aditya-167/SuperPong-FPGA/sw/videodemo/src/assets/test.jpg

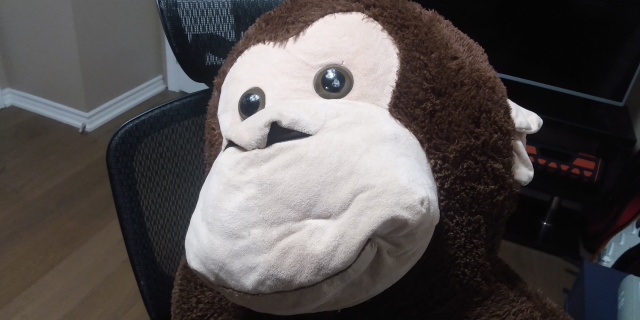
sw/videodemo/src/assets/test.jpg
