aditya-167/SuperPong-FPGA/docs/README.md

# Demo Video
[Full Demo](https://github.com/aditya-167/SuperPong-FPGA/blob/main/assets/full_demo.mp4)

# Camera Demo
[Camera Demo](https://github.com/aditya-167/SuperPong-FPGA/blob/main/assets/camera_interface.mp4)

# Pong Game Demo
[Full Demo](https://github.com/aditya-167/SuperPong-FPGA/blob/main/assets/pong_demo.mp4)

# Image Processing Demo
[Full Demo](https://github.com/aditya-167/SuperPong-FPGA/blob/main/assets/img_processing_unit.mp4)
