aditya-167/SuperPong-FPGA/hw/HDMI.runs/impl_1/.init_design.begin.rst

<?xml version="1.0"?>
<ProcessHandle Version="1" Minor="0">
    <Process Command=".planAhead." Owner="Yash Dhillon" Host="SOL-WYPC2" Pid="14732">
    </Process>
</ProcessHandle>
