aditya-167/SuperPong-FPGA/hw/HDMI.runs/hdmi_auto_rs_w_2_synth_1/.vivado.begin.rst

<?xml version="1.0"?>
<ProcessHandle Version="1" Minor="0">
    <Process Command="vivado.bat" Owner="Angad" Host="DESKTOP-RMQ09J8" Pid="7096">
    </Process>
</ProcessHandle>
