aditya-167/SuperPong-FPGA/hw/HDMI.runs/hdmi_axi_dynclk_0_0_synth_1/.vivado.begin.rst

<?xml version="1.0"?>
<ProcessHandle Version="1" Minor="0">
    <Process Command="vivado.bat" Owner="Yash Dhillon" Host="SOL-WYPC2" Pid="27572">
    </Process>
</ProcessHandle>
