aditya-167/SuperPong-FPGA/docs/ECE532 Mid-Project Demo.pptx

## Super Pong

Haoran S. Wei
Harsimrat S. Wadhawan
Yash Dhillon
Aditya Srichandan

## Overview

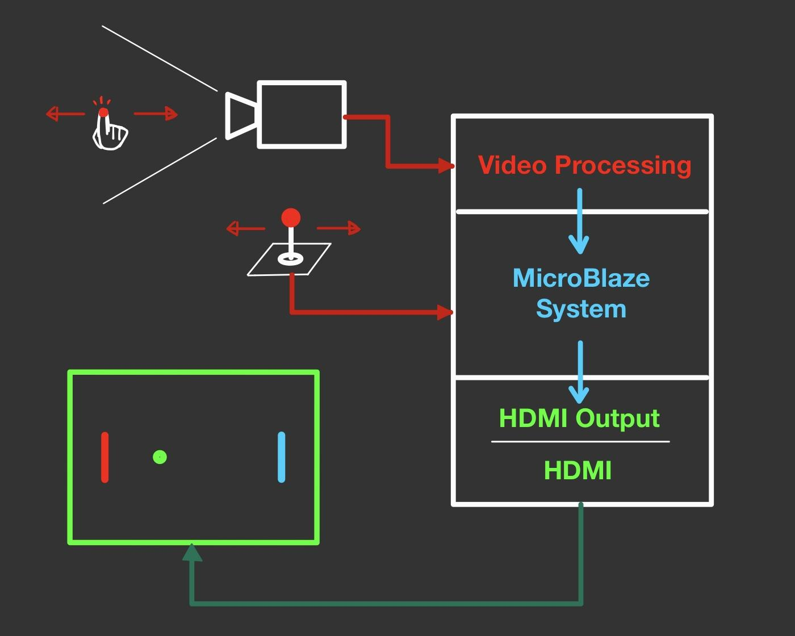
[picture p3: figure]

## Overview

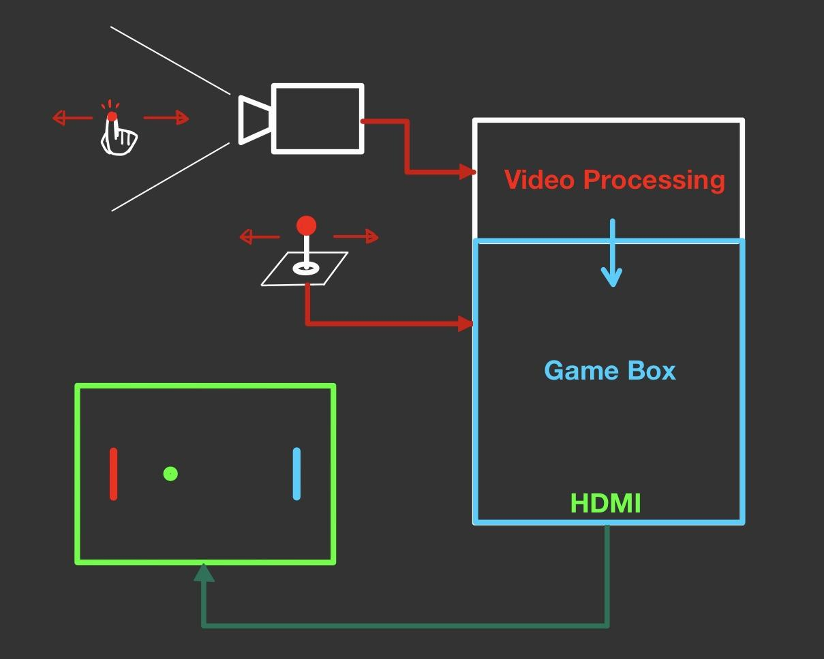
[picture p4: figure]

## Block Diagram

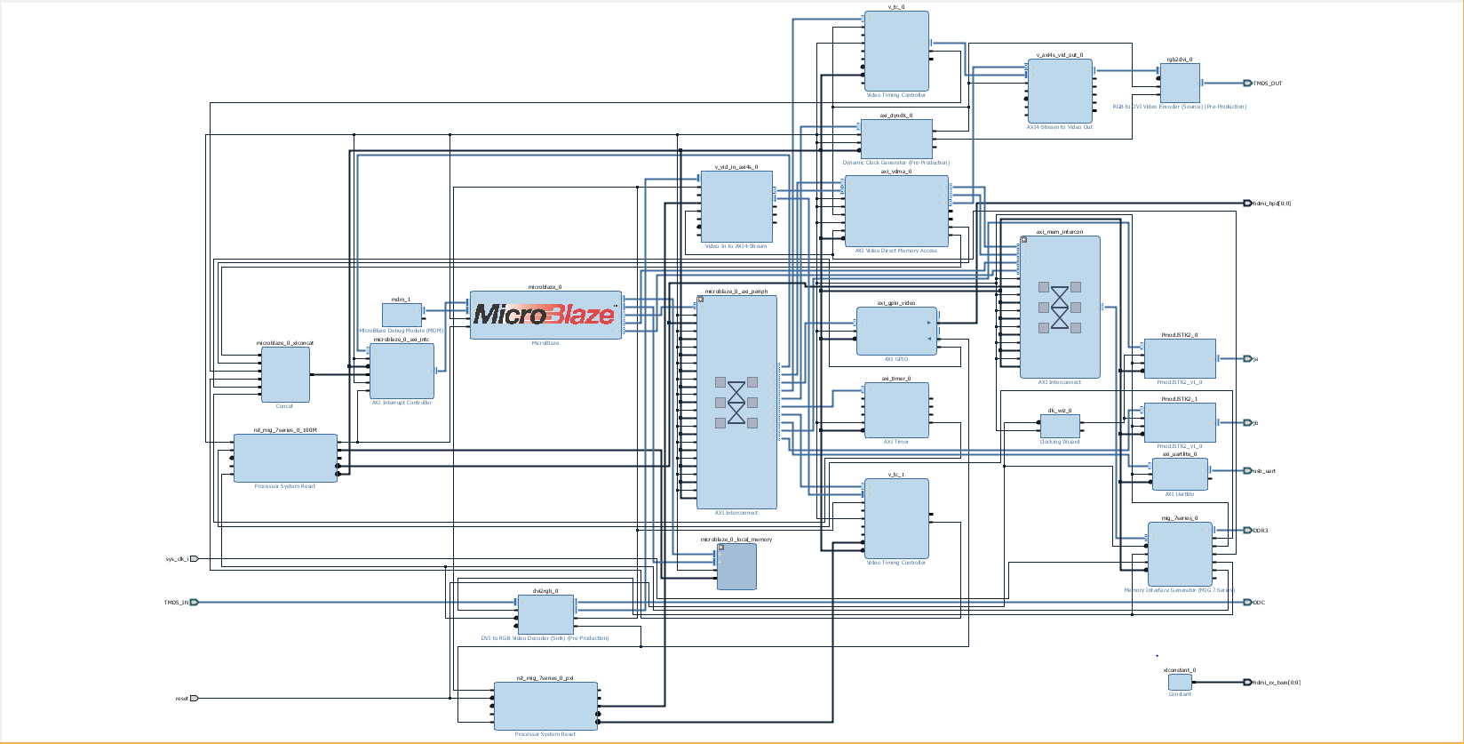
[picture p5: figure]

## Video Data Flow

VIDEO DMA

AXI STREAM TO VIDEO OUT

RGB to DVI Encoder

TMDS141 CHIP

HDMI
PORT

MEMORY INTERFACE

TIMING CONTROLLER

## MicroBlaze + HDMI Output

DRAM BUFFER

Microblaze

WRITE

READ

Video DMA

## MicroBlaze + HDMI Output

void drawPixel(int x, int y, int r, int g, int b) {
int iPixelAddr = x + (stride * y);
frame[iPixelAddr] = r;
frame[iPixelAddr + 1] = g;
frame[iPixelAddr + 2] = b;
}
// frame is a pointer to the DRAM buffer.
// iPixelAddr is the address of a single pixel in the buffer.

## Block Diagram : Joysticks

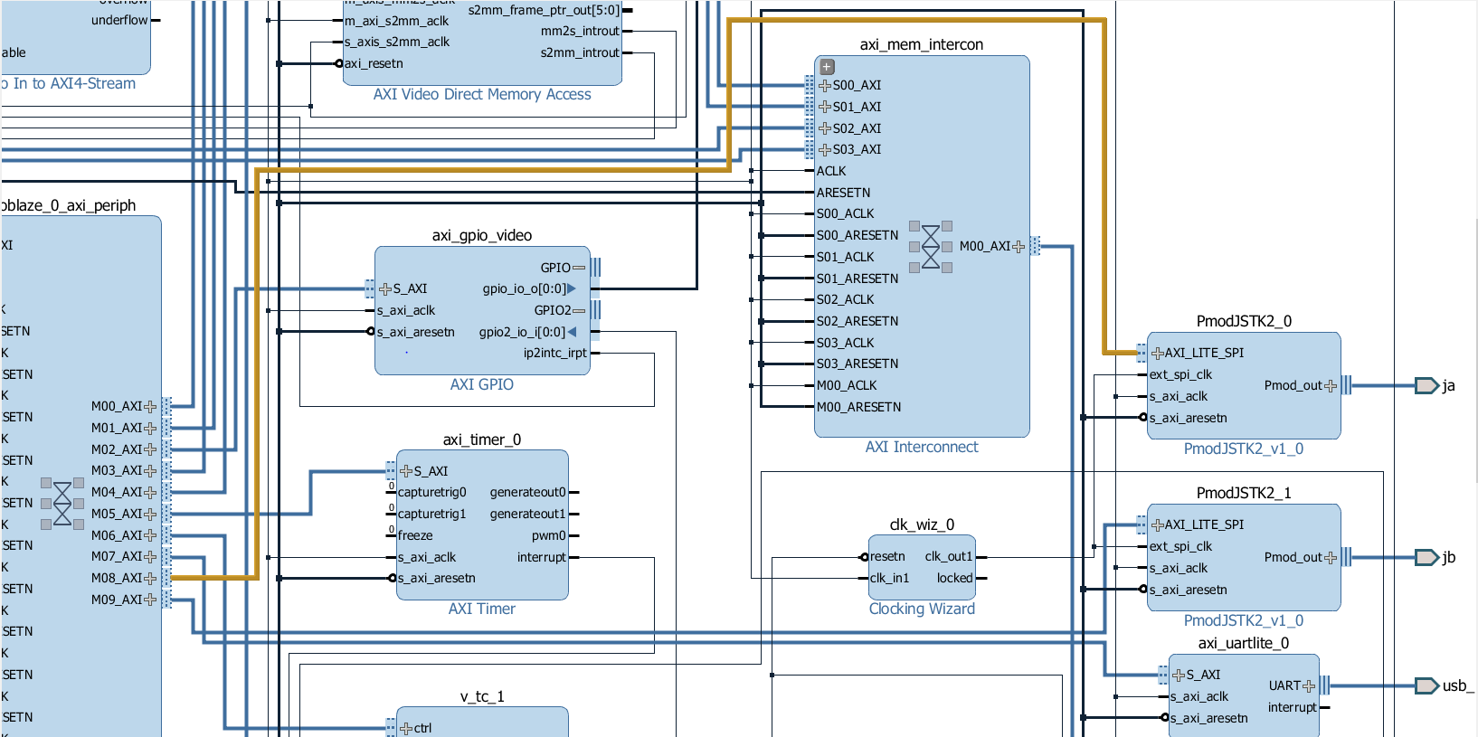
[picture p6: figure]

## Joysticks: Interface with Microblaze

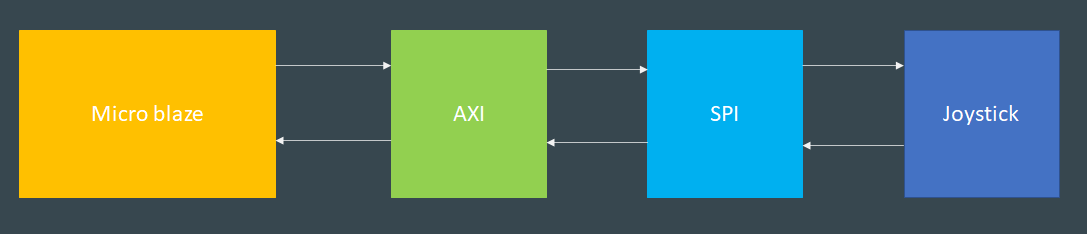
[picture p7: figure]

## Joysticks: Code Interface

void update_player_pad(PmodJSTK2* player, player_pad* pad, ball_struct* ball, int t_elapse) {
u16 Ydata;
u16 Xdata;
float step;
pad->pX = pad->xPos;
pad->pY = pad->yPos;
Ydata = JSTK2_getY(player);
Xdata = JSTK2_getX(player);
step = JOY_STEP * (((float)(Ydata-128))/128);
pad->yPos -= step;
if (pad->yPos < pad->h / 2)
pad->yPos = pad->h / 2;
if (pad->yPos > SCREEN_HEIGHT - pad->h / 2)
pad->yPos = SCREEN_HEIGHT - pad->h / 2;
}

## VGA Camera Interface

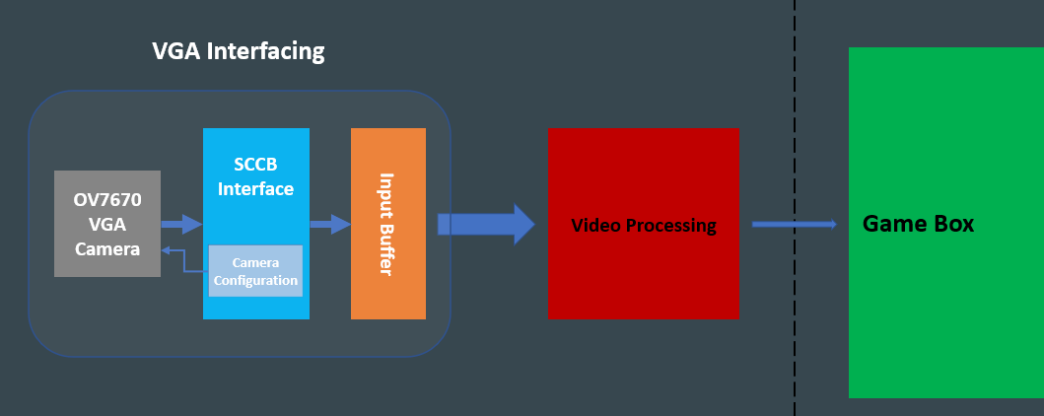
[picture p8: figure]

## VGA Camera Verification

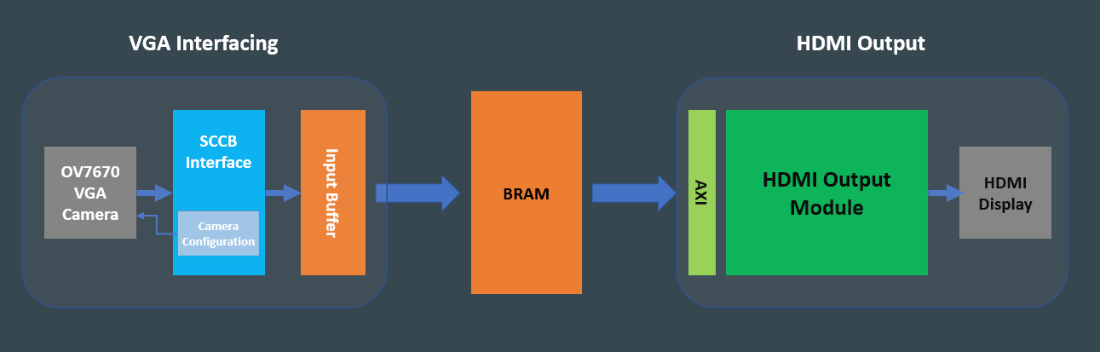
[picture p9: figure]

## Image Processing Unit (IPU)

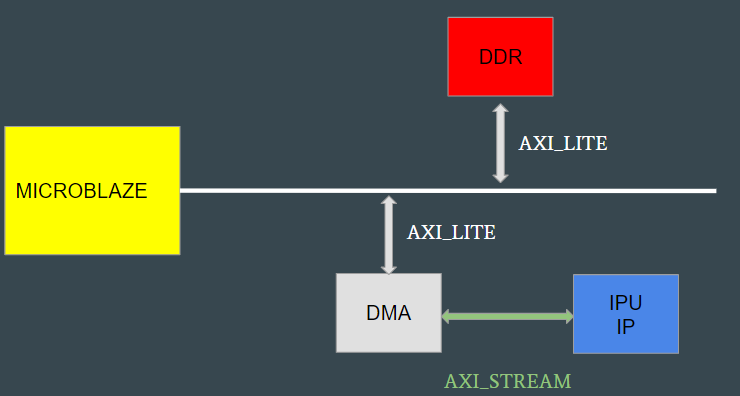
[picture p10: figure]

System Architecture

- 24 bits RGB2HSV Module
- Masking HSV logic

IPU Logic

## IPU BLOCK DESIGN

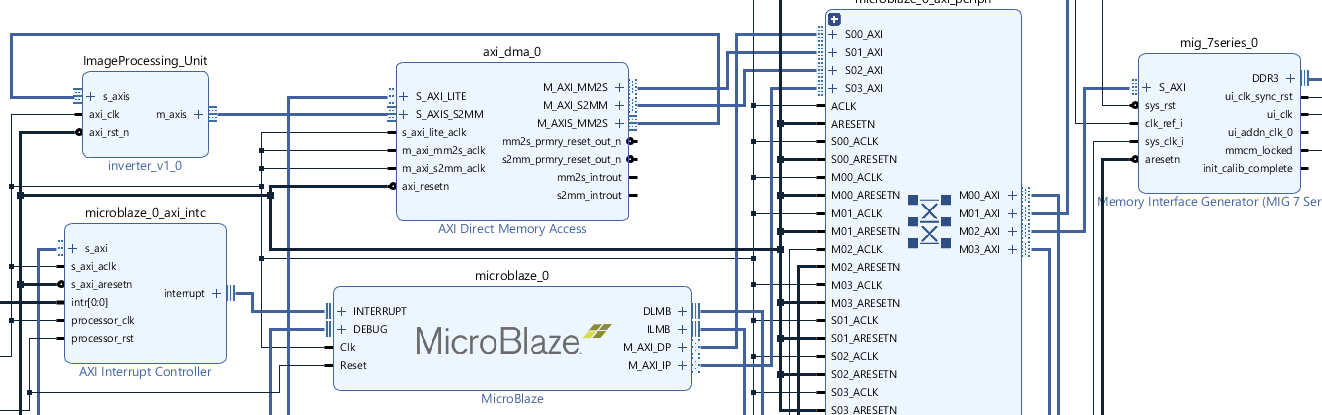
[picture p11: figure]

## TEST IMAGE

BMP image
(Two fingers covered with blue & yellow cover)

UART

Microblaze

RGB2HSV & mask values

Save back to bmp file & visualize

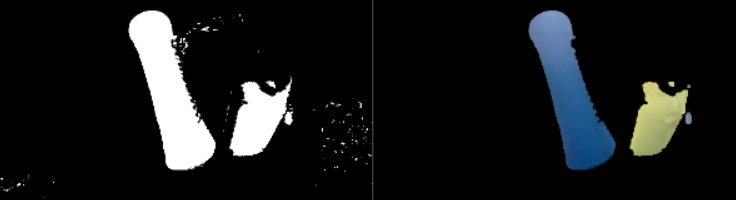
[picture p12: figure]

HW IPU under development, tested functionality on SW

## Demonstration

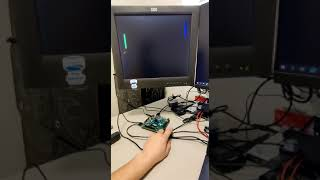
[picture p13: figure]

## Thanks !

Q & A
