aditya-167/SuperPong-FPGA/assets/generalproj.bmp

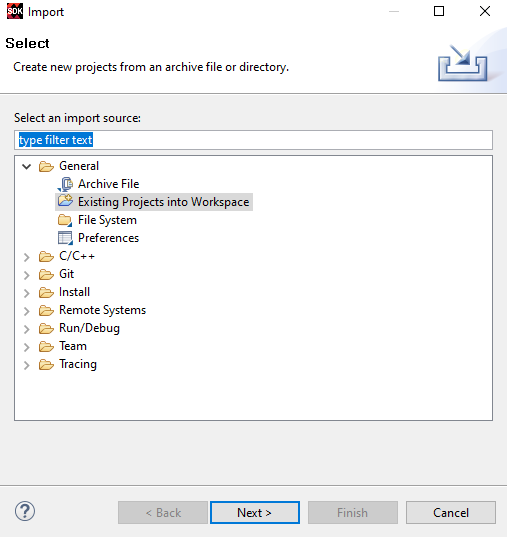
assets/generalproj.bmp
