aditya-167/SuperPong-FPGA/assets/prog.bmp

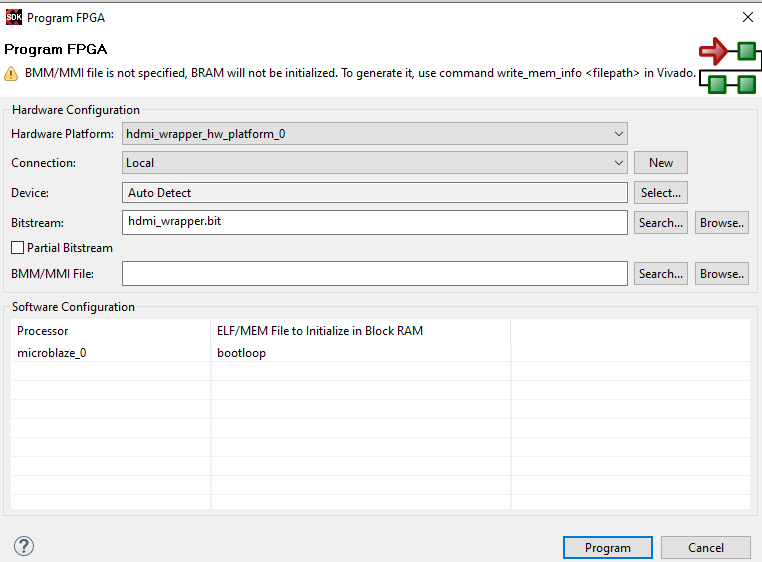
assets/prog.bmp
