aditya-167/SuperPong-FPGA/assets/root0dir.bmp

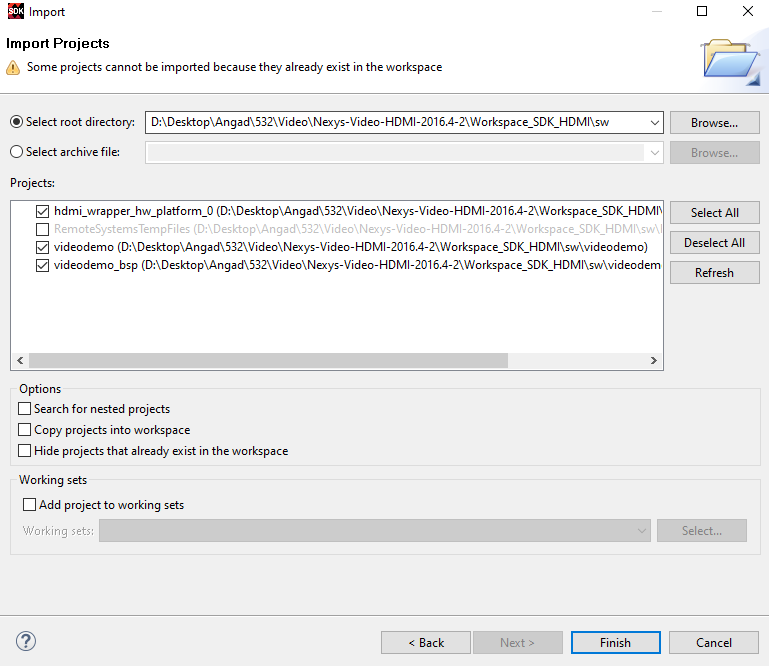
assets/root0dir.bmp
