aditya-167/SuperPong-FPGA/hw/HDMI.runs/impl_1/usage_statistics_webtalk.html

### Device Usage Page (usage_statistics_webtalk.html)

This HTML page displays the device usage statistics that will be sent to Xilinx.
To see the actual file transmitted to Xilinx, please click here.

software_version_and_target_device
beta | FALSE | build_version | 1756540
date_generated | Sun Mar 05 17:50:35 2023 | os_platform | WIN64
product_version | Vivado v2016.4 (64-bit) | project_id | 1ed84a7dc2a040de8295c28d0cfe79b6
project_iteration | 4 | random_id | 4f49d80dda655659bcc6e15ab8275343
registration_id | 4f49d80dda655659bcc6e15ab8275343 | route_design | TRUE
target_device | xc7a200t | target_family | artix7
target_package | sbg484 | target_speed | -1
tool_flow | Vivado

user_environment
cpu_name | Intel(R) Core(TM) i5-6300U CPU @ 2.40GHz | cpu_speed | 2496 MHz
os_name | Microsoft Windows 8 or later , 64-bit | os_release | major release (build 9200)
system_ram | 16.000 GB | total_processors | 1

vivado_usage

java_command_handlers
autoconnectport=3 | autoconnecttarget=1 | createtophdl=9 | customizersbblock=18
disconnectrsbpin=1 | editdelete=10 | editproperties=1 | editundo=5
launchprogramfpga=1 | newexporthardware=4 | newhardwaredashboard=1 | newlaunchhardware=13
openblockdesign=10 | openexample=1 | openhardwaremanager=2 | openproject=3
projectsettingscmdhandler=3 | regeneratersblayout=5 | runbitgen=11 | runimplementation=1
runsynthesis=2 | saversbdesign=4 | showproductguide=1 | showproductwebpage=1
showview=4 | toggleautofitselection=2 | validatersbdesign=1 | viewtaskprojectmanager=1

zoomin=2

other_data

guimode=12

project_data
constraintsetcount=1 | core_container=false | currentimplrun=impl_1 | currentsynthesisrun=synth_1
default_library=xil_defaultlib | designmode=RTL | export_simulation_activehdl=0 | export_simulation_ies=0
export_simulation_modelsim=0 | export_simulation_questa=0 | export_simulation_riviera=0 | export_simulation_vcs=0
export_simulation_xsim=0 | implstrategy=Vivado Implementation Defaults | launch_simulation_activehdl=0 | launch_simulation_ies=0
launch_simulation_modelsim=0 | launch_simulation_questa=0 | launch_simulation_riviera=0 | launch_simulation_vcs=0
launch_simulation_xsim=0 | simulator_language=Mixed | srcsetcount=3 | synthesisstrategy=Vivado Synthesis Defaults
target_language=VHDL | target_simulator=XSim | totalimplruns=7 | totalsynthesisruns=7

unisim_transformation

post_unisim_transformation
and2b1l=3 | bscane2=1 | bufg=11 | bufh=1
bufio=2 | bufmr=1 | bufr=2 | carry4=761
dsp48e1=9 | fdce=816 | fdpe=325 | fdre=30860
fdse=1087 | fifo36e1=10 | gnd=1306 | ibuf=21
ibuf_intermdisable=16 | ibufds=4 | ibufds_intermdisable_int=4 | iddr=2
idelayctrl=2 | idelaye2=19 | in_fifo=2 | inv=3
iserdese2=22 | lut1=1573 | lut2=3108 | lut3=7629
lut4=3981 | lut5=5327 | lut6=7744 | mmcme2_adv=4
muxf7=803 | muxf8=39 | obuf=27 | obufds=6
obuft=36 | obuftds=4 | oddr=5 | oserdese2=51
out_fifo=4 | phaser_in_phy=2 | phaser_out_phy=4 | phaser_ref=1
phy_control=1 | plle2_adv=1 | ramb18e1=4 | ramb36e1=280
ramd32=1126 | rams32=866 | srl16e=1067 | srlc16e=7
srlc32e=209 | vcc=906 | xadc=1

pre_unisim_transformation
and2b1l=3 | bscane2=1 | bufg=11 | bufh=1
bufio=2 | bufmr=1 | bufr=2 | carry4=761
dsp48e1=9 | fdce=816 | fdpe=325 | fdre=30860
fdse=1087 | fifo36e1=10 | gnd=1306 | ibuf=4
ibufds=4 | iddr=2 | idelayctrl=2 | idelaye2=19
in_fifo=2 | iobuf=18 | iobuf_intermdisable=16 | iobufds_diff_out_intermdisable=2
iserdese2=22 | lut1=1573 | lut2=3108 | lut3=7629
lut4=3981 | lut5=5263 | lut6=7680 | lut6_2=64
mmcme2_adv=4 | muxf7=803 | muxf8=39 | obuf=27
obufds=5 | obuft=2 | oddr=5 | oserdese2=51
out_fifo=4 | phaser_in_phy=2 | phaser_out_phy=4 | phaser_ref=1
phy_control=1 | plle2_adv=1 | ram32m=177 | ram32x1d=32
ram32x1s=512 | ramb18e1=4 | ramb36e1=280 | srl16e=1067
srlc16e=7 | srlc32e=209 | vcc=906 | xadc=1

ip_statistics

IP_Integrator/1
bdsource=USER | core_container=NA | da_axi4_cnt=2 | da_board_cnt=1
iptotal=1 | maxhierdepth=1 | numblks=59 | numhdlrefblks=0
numhierblks=19 | numhlsblks=0 | numnonxlnxblks=5 | numpkgbdblks=0
numreposblks=40 | numsysgenblks=0 | synth_mode=OOC_per_IP | x_iplanguage=VHDL
x_iplibrary=BlockDiagram | x_ipname=hdmi | x_ipvendor=xilinx.com | x_ipversion=1.00.a

MDM/1
c_data_size=32 | c_dbg_mem_access=0 | c_dbg_reg_access=0 | c_debug_interface=0
c_family=artix7 | c_interconnect=2 | c_jtag_chain=2 | c_m_axi_addr_width=32
c_m_axi_data_width=32 | c_m_axi_thread_id_width=1 | c_m_axis_data_width=32 | c_m_axis_id_width=7
c_mb_dbg_ports=1 | c_s_axi_aclk_freq_hz=100000000 | c_s_axi_addr_width=4 | c_s_axi_data_width=32
c_trace_clk_freq_hz=200000000 | c_trace_clk_out_phase=90 | c_trace_data_width=32 | c_trace_output=0
c_use_bscan=0 | c_use_config_reset=0 | c_use_cross_trigger=0 | c_use_uart=0
core_container=NA | iptotal=1 | x_ipcorerevision=8 | x_iplanguage=VHDL
x_iplibrary=ip | x_ipname=mdm | x_ipproduct=Vivado 2016.4 | x_ipsimlanguage=MIXED
x_ipvendor=xilinx.com | x_ipversion=3.2

MicroBlaze/1
c_addr_tag_bits=14 | c_allow_dcache_wr=1 | c_allow_icache_wr=1 | c_area_optimized=0
c_async_interrupt=1 | c_async_wakeup=3 | c_avoid_primitives=0 | c_base_vectors=0x0000000000000000
c_branch_target_cache_size=0 | c_cache_byte_size=32768 | c_d_axi=1 | c_d_lmb=1
c_daddr_size=32 | c_data_size=32 | c_dcache_addr_tag=14 | c_dcache_always_used=1
c_dcache_baseaddr=0x0000000080000000 | c_dcache_byte_size=32768 | c_dcache_data_width=1 | c_dcache_force_tag_lutram=0
c_dcache_highaddr=0x000000009fffffff | c_dcache_line_len=8 | c_dcache_use_writeback=1 | c_dcache_victims=8
c_debug_counter_width=32 | c_debug_enabled=2 | c_debug_event_counters=5 | c_debug_external_trace=0
c_debug_interface=0 | c_debug_latency_counters=1 | c_debug_profile_size=0 | c_debug_trace_size=8192
c_div_zero_exception=0 | c_dynamic_bus_sizing=0 | c_ecc_use_ce_exception=0 | c_edge_is_positive=1
c_endianness=1 | c_family=artix7 | c_fault_tolerant=0 | c_fpu_exception=0
c_freq=100000000 | c_fsl_exception=0 | c_fsl_links=0 | c_i_axi=0
c_i_lmb=1 | c_iaddr_size=32 | c_icache_always_used=1 | c_icache_baseaddr=0x0000000080000000
c_icache_data_width=1 | c_icache_force_tag_lutram=0 | c_icache_highaddr=0x000000009FFFFFFF | c_icache_line_len=8
c_icache_streams=1 | c_icache_victims=8 | c_ill_opcode_exception=0 | c_imprecise_exceptions=0
c_instance=hdmi_microblaze_0_0 | c_instr_size=32 | c_interconnect=2 | c_interrupt_is_edge=0
c_lockstep_master=0 | c_lockstep_slave=0 | c_m0_axis_data_width=32 | c_m10_axis_data_width=32
c_m11_axis_data_width=32 | c_m12_axis_data_width=32 | c_m13_axis_data_width=32 | c_m14_axis_data_width=32
c_m15_axis_data_width=32 | c_m1_axis_data_width=32 | c_m2_axis_data_width=32 | c_m3_axis_data_width=32
c_m4_axis_data_width=32 | c_m5_axis_data_width=32 | c_m6_axis_data_width=32 | c_m7_axis_data_width=32
c_m8_axis_data_width=32 | c_m9_axis_data_width=32 | c_m_axi_d_bus_exception=0 | c_m_axi_dc_addr_width=32
c_m_axi_dc_aruser_width=5 | c_m_axi_dc_awuser_width=5 | c_m_axi_dc_buser_width=1 | c_m_axi_dc_data_width=256
c_m_axi_dc_exclusive_access=0 | c_m_axi_dc_ruser_width=1 | c_m_axi_dc_thread_id_width=1 | c_m_axi_dc_user_value=31
c_m_axi_dc_wuser_width=1 | c_m_axi_dp_addr_width=32 | c_m_axi_dp_data_width=32 | c_m_axi_dp_exclusive_access=0
c_m_axi_dp_thread_id_width=1 | c_m_axi_i_bus_exception=0 | c_m_axi_ic_addr_width=32 | c_m_axi_ic_aruser_width=5
c_m_axi_ic_awuser_width=5 | c_m_axi_ic_buser_width=1 | c_m_axi_ic_data_width=256 | c_m_axi_ic_ruser_width=1
c_m_axi_ic_thread_id_width=1 | c_m_axi_ic_user_value=31 | c_m_axi_ic_wuser_width=1 | c_m_axi_ip_addr_width=32
c_m_axi_ip_data_width=32 | c_m_axi_ip_thread_id_width=1 | c_mmu_dtlb_size=4 | c_mmu_itlb_size=2
c_mmu_privileged_instr=0 | c_mmu_tlb_access=3 | c_mmu_zones=2 | c_num_sync_ff_clk=2
c_num_sync_ff_clk_debug=2 | c_num_sync_ff_clk_irq=1 | c_num_sync_ff_dbg_clk=1 | c_number_of_pc_brk=1
c_number_of_rd_addr_brk=0 | c_number_of_wr_addr_brk=0 | c_opcode_0x0_illegal=0 | c_optimization=0
c_pc_width=32 | c_pvr=0 | c_pvr_user1=0x00 | c_pvr_user2=0x00000000
c_reset_msr=0x00000000 | c_s0_axis_data_width=32 | c_s10_axis_data_width=32 | c_s11_axis_data_width=32
c_s12_axis_data_width=32 | c_s13_axis_data_width=32 | c_s14_axis_data_width=32 | c_s15_axis_data_width=32
c_s1_axis_data_width=32 | c_s2_axis_data_width=32 | c_s3_axis_data_width=32 | c_s4_axis_data_width=32
c_s5_axis_data_width=32 | c_s6_axis_data_width=32 | c_s7_axis_data_width=32 | c_s8_axis_data_width=32
c_s9_axis_data_width=32 | c_sco=0 | c_unaligned_exceptions=0 | c_use_barrel=1
c_use_branch_target_cache=0 | c_use_config_reset=0 | c_use_dcache=1 | c_use_div=1
c_use_ext_brk=0 | c_use_ext_nm_brk=0 | c_use_extended_fsl_instr=0 | c_use_fpu=2
c_use_hw_mul=2 | c_use_icache=1 | c_use_interrupt=2 | c_use_mmu=0
c_use_msr_instr=1 | c_use_non_secure=0 | c_use_pcmp_instr=1 | c_use_reorder_instr=1
c_use_stack_protection=0 | core_container=NA | iptotal=1 | x_ipcorerevision=1
x_iplanguage=VHDL | x_iplibrary=ip | x_ipname=microblaze | x_ipproduct=Vivado 2016.4
x_ipsimlanguage=MIXED | x_ipvendor=xilinx.com | x_ipversion=10.0

axi_crossbar_v2_1_12_axi_crossbar/1
x_ipversion=10.0 | c_axi_addr_width=32 | c_axi_aruser_width=1 | c_axi_awuser_width=1
c_axi_buser_width=1 | c_axi_data_width=256 | c_axi_id_width=2 | c_axi_protocol=0
c_axi_ruser_width=1 | c_axi_supports_user_signals=0 | c_axi_wuser_width=1 | c_connectivity_mode=1
c_family=artix7 | c_m_axi_addr_width=0x0000001d | c_m_axi_base_addr=0x0000000080000000 | c_m_axi_read_connectivity=0x0000000d
c_m_axi_read_issuing=0x00000008 | c_m_axi_secure=0x00000000 | c_m_axi_write_connectivity=0x00000006 | c_m_axi_write_issuing=0x00000008
c_num_addr_ranges=1 | c_num_master_slots=1 | c_num_slave_slots=4 | c_r_register=0
c_s_axi_arb_priority=0x00000000000000000000000000000000 | c_s_axi_base_id=0x00000003000000020000000100000000 | c_s_axi_read_acceptance=0x00000008000000020000000200000002 | c_s_axi_single_thread=0x00000000000000000000000000000000
c_s_axi_write_acceptance=0x00000002000000080000000200000002 | core_container=NA | iptotal=1 | x_ipcorerevision=12
x_iplanguage=VHDL | x_iplibrary=ip | x_ipname=axi_crossbar | x_ipproduct=Vivado 2016.4
x_ipsimlanguage=MIXED | x_ipvendor=xilinx.com | x_ipversion=2.1

axi_crossbar_v2_1_12_axi_crossbar/2
c_axi_addr_width=32 | c_axi_aruser_width=1 | c_axi_awuser_width=1 | c_axi_buser_width=1
c_axi_data_width=32 | c_axi_id_width=1 | c_axi_protocol=2 | c_axi_ruser_width=1
c_axi_supports_user_signals=0 | c_axi_wuser_width=1 | c_connectivity_mode=0 | c_family=artix7
c_m_axi_addr_width=0x00000010000000100000001000000010000000100000001000000010000000100000001000000010 | c_m_axi_base_addr=0x0000000000020000000000000001000000000000406000000000000044a300000000000041c000000000000044a200000000000044a1000000000000400000000000000044a000000000000041200000 | c_m_axi_read_connectivity=0x00000001000000010000000100000001000000010000000100000001000000010000000100000001 | c_m_axi_read_issuing=0x00000001000000010000000100000001000000010000000100000001000000010000000100000001
c_m_axi_secure=0x00000000000000000000000000000000000000000000000000000000000000000000000000000000 | c_m_axi_write_connectivity=0x00000001000000010000000100000001000000010000000100000001000000010000000100000001 | c_m_axi_write_issuing=0x00000001000000010000000100000001000000010000000100000001000000010000000100000001 | c_num_addr_ranges=1
c_num_master_slots=10 | c_num_slave_slots=1 | c_r_register=1 | c_s_axi_arb_priority=0x00000000
c_s_axi_base_id=0x00000000 | c_s_axi_read_acceptance=0x00000001 | c_s_axi_single_thread=0x00000001 | c_s_axi_thread_id_width=0x00000000
c_s_axi_write_acceptance=0x00000001 | core_container=NA | iptotal=1 | x_ipcorerevision=12
x_iplanguage=VHDL | x_iplibrary=ip | x_ipname=axi_crossbar | x_ipproduct=Vivado 2016.4
x_ipsimlanguage=MIXED | x_ipvendor=xilinx.com | x_ipversion=2.1

axi_dwidth_converter_v2_1_11_top/1
c_axi_addr_width=29 | c_axi_is_aclk_async=0 | c_axi_protocol=0 | c_axi_supports_read=1
c_axi_supports_write=1 | c_family=artix7 | c_fifo_mode=0 | c_m_axi_aclk_ratio=2
c_m_axi_data_width=128 | c_max_split_beats=256 | c_packing_level=1 | c_s_axi_aclk_ratio=1
c_s_axi_data_width=256 | c_s_axi_id_width=2 | c_supports_id=1 | c_synchronizer_stage=3
core_container=NA | iptotal=1 | x_ipcorerevision=11 | x_iplanguage=VHDL
x_iplibrary=ip | x_ipname=axi_dwidth_converter | x_ipproduct=Vivado 2016.4 | x_ipsimlanguage=MIXED
x_ipvendor=xilinx.com | x_ipversion=2.1

axi_dwidth_converter_v2_1_11_top/2
c_axi_addr_width=32 | c_axi_is_aclk_async=0 | c_axi_protocol=0 | c_axi_supports_read=1
c_axi_supports_write=0 | c_family=artix7 | c_fifo_mode=0 | c_m_axi_aclk_ratio=2
c_m_axi_data_width=256 | c_max_split_beats=16 | c_packing_level=1 | c_s_axi_aclk_ratio=1
c_s_axi_data_width=128 | c_s_axi_id_width=1 | c_supports_id=0 | c_synchronizer_stage=3
core_container=NA | iptotal=1 | x_ipcorerevision=11 | x_iplanguage=VHDL
x_iplibrary=ip | x_ipname=axi_dwidth_converter | x_ipproduct=Vivado 2016.4 | x_ipsimlanguage=MIXED
x_ipvendor=xilinx.com | x_ipversion=2.1

axi_dwidth_converter_v2_1_11_top/3
c_axi_addr_width=32 | c_axi_is_aclk_async=0 | c_axi_protocol=0 | c_axi_supports_read=0
c_axi_supports_write=1 | c_family=artix7 | c_fifo_mode=0 | c_m_axi_aclk_ratio=2
c_m_axi_data_width=256 | c_max_split_beats=16 | c_packing_level=1 | c_s_axi_aclk_ratio=1
c_s_axi_data_width=128 | c_s_axi_id_width=1 | c_supports_id=0 | c_synchronizer_stage=3
core_container=NA | iptotal=1 | x_ipcorerevision=11 | x_iplanguage=VHDL
x_iplibrary=ip | x_ipname=axi_dwidth_converter | x_ipproduct=Vivado 2016.4 | x_ipsimlanguage=MIXED
x_ipvendor=xilinx.com | x_ipversion=2.1

axi_gpio/1
c_all_inputs=0 | c_all_inputs_2=1 | c_all_outputs=1 | c_all_outputs_2=0
c_dout_default=0x00000000 | c_dout_default_2=0x00000000 | c_family=artix7 | c_gpio2_width=1
c_gpio_width=1 | c_interrupt_present=1 | c_is_dual=1 | c_s_axi_addr_width=9
c_s_axi_data_width=32 | c_tri_default=0xFFFFFFFF | c_tri_default_2=0xFFFFFFFF | core_container=NA
iptotal=1 | x_ipcorerevision=13 | x_iplanguage=VHDL | x_iplibrary=ip
x_ipname=axi_gpio | x_ipproduct=Vivado 2016.4 | x_ipsimlanguage=MIXED | x_ipvendor=xilinx.com

x_ipversion=2.0

axi_intc/1
c_async_intr=0xFFFFFFCF | c_cascade_master=0 | c_disable_synchronizers=0 | c_en_cascade_mode=0
c_enable_async=0 | c_family=artix7 | c_has_cie=1 | c_has_fast=1
c_has_ilr=0 | c_has_ipr=1 | c_has_ivr=1 | c_has_sie=1
c_instance=hdmi_microblaze_0_axi_intc_0 | c_irq_active=0x1 | c_irq_is_level=1 | c_ivar_reset_value=0x00000010
c_kind_of_edge=0xFFFFFFFF | c_kind_of_intr=0xffffffc0 | c_kind_of_lvl=0xFFFFFFFF | c_mb_clk_not_connected=1
c_num_intr_inputs=6 | c_num_sw_intr=0 | c_num_sync_ff=2 | c_s_axi_addr_width=9
c_s_axi_data_width=32 | core_container=NA | iptotal=1 | x_ipcorerevision=9
x_iplanguage=VHDL | x_iplibrary=ip | x_ipname=axi_intc | x_ipproduct=Vivado 2016.4
x_ipsimlanguage=MIXED | x_ipvendor=xilinx.com | x_ipversion=4.1

axi_quad_spi/1
async_clk=1 | c_dual_quad_mode=0 | c_family=artix7 | c_fifo_depth=16
c_instance=axi_quad_spi_inst | c_lsb_stup=0 | c_num_ss_bits=1 | c_num_transfer_bits=8
c_s_axi4_addr_width=24 | c_s_axi4_baseaddr=0xFFFFFFFF | c_s_axi4_data_width=32 | c_s_axi4_highaddr=0x00000000
c_s_axi4_id_width=1 | c_s_axi_addr_width=7 | c_s_axi_data_width=32 | c_sck_ratio=16
c_select_xpm=0 | c_shared_startup=0 | c_spi_mem_addr_bits=24 | c_spi_memory=1
c_spi_mode=0 | c_sub_family=zynq | c_type_of_axi4_interface=0 | c_uc_family=0
c_use_startup=0 | c_use_startup_ext=0 | c_xip_mode=0 | core_container=NA
iptotal=2 | x_ipcorerevision=10 | x_iplanguage=VERILOG | x_iplibrary=ip
x_ipname=axi_quad_spi | x_ipproduct=Vivado 2016.4 | x_ipsimlanguage=MIXED | x_ipvendor=xilinx.com

x_ipversion=3.2

axi_register_slice_v2_1_11_axi_register_slice/1
c_axi_addr_width=29 | c_axi_aruser_width=1 | c_axi_awuser_width=1 | c_axi_buser_width=1
c_axi_data_width=256 | c_axi_id_width=2 | c_axi_protocol=0 | c_axi_ruser_width=1
c_axi_supports_user_signals=0 | c_axi_wuser_width=1 | c_family=artix7 | c_reg_config_ar=0
c_reg_config_aw=0 | c_reg_config_b=0 | c_reg_config_r=0 | c_reg_config_w=1
core_container=NA | iptotal=1 | x_ipcorerevision=11 | x_iplanguage=VHDL
x_iplibrary=ip | x_ipname=axi_register_slice | x_ipproduct=Vivado 2016.4 | x_ipsimlanguage=MIXED
x_ipvendor=xilinx.com | x_ipversion=2.1

axi_register_slice_v2_1_11_axi_register_slice/2
c_axi_addr_width=32 | c_axi_aruser_width=1 | c_axi_awuser_width=1 | c_axi_buser_width=1
c_axi_data_width=256 | c_axi_id_width=1 | c_axi_protocol=0 | c_axi_ruser_width=1
c_axi_supports_user_signals=0 | c_axi_wuser_width=1 | c_family=artix7 | c_reg_config_ar=0
c_reg_config_aw=0 | c_reg_config_b=0 | c_reg_config_r=1 | c_reg_config_w=0
core_container=NA | iptotal=1 | x_ipcorerevision=11 | x_iplanguage=VHDL
x_iplibrary=ip | x_ipname=axi_register_slice | x_ipproduct=Vivado 2016.4 | x_ipsimlanguage=MIXED
x_ipvendor=xilinx.com | x_ipversion=2.1

axi_register_slice_v2_1_11_axi_register_slice/3
c_axi_addr_width=32 | c_axi_aruser_width=1 | c_axi_awuser_width=1 | c_axi_buser_width=1
c_axi_data_width=256 | c_axi_id_width=1 | c_axi_protocol=0 | c_axi_ruser_width=1
c_axi_supports_user_signals=0 | c_axi_wuser_width=1 | c_family=artix7 | c_reg_config_ar=0
c_reg_config_aw=0 | c_reg_config_b=0 | c_reg_config_r=0 | c_reg_config_w=1
core_container=NA | iptotal=1 | x_ipcorerevision=11 | x_iplanguage=VHDL
x_iplibrary=ip | x_ipname=axi_register_slice | x_ipproduct=Vivado 2016.4 | x_ipsimlanguage=MIXED
x_ipvendor=xilinx.com | x_ipversion=2.1

axi_register_slice_v2_1_11_axi_register_slice/4
c_axi_addr_width=29 | c_axi_aruser_width=1 | c_axi_awuser_width=1 | c_axi_buser_width=1
c_axi_data_width=128 | c_axi_id_width=1 | c_axi_protocol=0 | c_axi_ruser_width=1
c_axi_supports_user_signals=0 | c_axi_wuser_width=1 | c_family=artix7 | c_reg_config_ar=7
c_reg_config_aw=7 | c_reg_config_b=7 | c_reg_config_r=1 | c_reg_config_w=1
core_container=NA | iptotal=1 | x_ipcorerevision=11 | x_iplanguage=VHDL
x_iplibrary=ip | x_ipname=axi_register_slice | x_ipproduct=Vivado 2016.4 | x_ipsimlanguage=MIXED
x_ipvendor=xilinx.com | x_ipversion=2.1

axi_register_slice_v2_1_11_axi_register_slice/5
c_axi_addr_width=32 | c_axi_aruser_width=1 | c_axi_awuser_width=1 | c_axi_buser_width=1
c_axi_data_width=128 | c_axi_id_width=1 | c_axi_protocol=0 | c_axi_ruser_width=1
c_axi_supports_user_signals=0 | c_axi_wuser_width=1 | c_family=artix7 | c_reg_config_ar=7
c_reg_config_aw=0 | c_reg_config_b=0 | c_reg_config_r=1 | c_reg_config_w=0
core_container=NA | iptotal=1 | x_ipcorerevision=11 | x_iplanguage=VHDL
x_iplibrary=ip | x_ipname=axi_register_slice | x_ipproduct=Vivado 2016.4 | x_ipsimlanguage=MIXED
x_ipvendor=xilinx.com | x_ipversion=2.1

axi_register_slice_v2_1_11_axi_register_slice/6
c_axi_addr_width=32 | c_axi_aruser_width=1 | c_axi_awuser_width=1 | c_axi_buser_width=1
c_axi_data_width=128 | c_axi_id_width=1 | c_axi_protocol=0 | c_axi_ruser_width=1
c_axi_supports_user_signals=0 | c_axi_wuser_width=1 | c_family=artix7 | c_reg_config_ar=0
c_reg_config_aw=7 | c_reg_config_b=7 | c_reg_config_r=0 | c_reg_config_w=1
core_container=NA | iptotal=1 | x_ipcorerevision=11 | x_iplanguage=VHDL
x_iplibrary=ip | x_ipname=axi_register_slice | x_ipproduct=Vivado 2016.4 | x_ipsimlanguage=MIXED
x_ipvendor=xilinx.com | x_ipversion=2.1

axi_register_slice_v2_1_11_axi_register_slice/7
c_axi_addr_width=32 | c_axi_aruser_width=1 | c_axi_awuser_width=1 | c_axi_buser_width=1
c_axi_data_width=256 | c_axi_id_width=1 | c_axi_protocol=0 | c_axi_ruser_width=1
c_axi_supports_user_signals=0 | c_axi_wuser_width=1 | c_family=artix7 | c_reg_config_ar=7
c_reg_config_aw=7 | c_reg_config_b=7 | c_reg_config_r=1 | c_reg_config_w=1
core_container=NA | iptotal=1 | x_ipcorerevision=11 | x_iplanguage=VHDL
x_iplibrary=ip | x_ipname=axi_register_slice | x_ipproduct=Vivado 2016.4 | x_ipsimlanguage=MIXED
x_ipvendor=xilinx.com | x_ipversion=2.1

axi_register_slice_v2_1_11_axi_register_slice/8
c_axi_addr_width=32 | c_axi_aruser_width=1 | c_axi_awuser_width=1 | c_axi_buser_width=1
c_axi_data_width=256 | c_axi_id_width=1 | c_axi_protocol=0 | c_axi_ruser_width=1
c_axi_supports_user_signals=0 | c_axi_wuser_width=1 | c_family=artix7 | c_reg_config_ar=7
c_reg_config_aw=0 | c_reg_config_b=0 | c_reg_config_r=1 | c_reg_config_w=0
core_container=NA | iptotal=1 | x_ipcorerevision=11 | x_iplanguage=VHDL
x_iplibrary=ip | x_ipname=axi_register_slice | x_ipproduct=Vivado 2016.4 | x_ipsimlanguage=MIXED
x_ipvendor=xilinx.com | x_ipversion=2.1

axi_timer/1
c_count_width=32 | c_family=artix7 | c_gen0_assert=1 | c_gen1_assert=1
c_one_timer_only=0 | c_s_axi_addr_width=5 | c_s_axi_data_width=32 | c_trig0_assert=1
c_trig1_assert=1 | core_container=NA | iptotal=1 | x_ipcorerevision=13
x_iplanguage=VHDL | x_iplibrary=ip | x_ipname=axi_timer | x_ipproduct=Vivado 2016.4
x_ipsimlanguage=MIXED | x_ipvendor=xilinx.com | x_ipversion=2.0

axi_uartlite/1
c_baudrate=115200 | c_data_bits=8 | c_family=artix7 | c_odd_parity=0
c_s_axi_aclk_freq_hz=100000000 | c_s_axi_addr_width=4 | c_s_axi_data_width=32 | c_use_parity=0
core_container=NA | iptotal=1 | x_ipcorerevision=15 | x_iplanguage=VHDL
x_iplibrary=ip | x_ipname=axi_uartlite | x_ipproduct=Vivado 2016.4 | x_ipsimlanguage=MIXED
x_ipvendor=xilinx.com | x_ipversion=2.0

axi_vdma/1
c_dlytmr_resolution=125 | c_dynamic_resolution=1 | c_enable_debug_all=0 | c_enable_debug_info_0=0
c_enable_debug_info_1=0 | c_enable_debug_info_10=0 | c_enable_debug_info_11=0 | c_enable_debug_info_12=0
c_enable_debug_info_13=0 | c_enable_debug_info_14=1 | c_enable_debug_info_15=1 | c_enable_debug_info_2=0
c_enable_debug_info_3=0 | c_enable_debug_info_4=0 | c_enable_debug_info_5=0 | c_enable_debug_info_6=1
c_enable_debug_info_7=1 | c_enable_debug_info_8=0 | c_enable_debug_info_9=0 | c_enable_vidprmtr_reads=1
c_family=artix7 | c_flush_on_fsync=1 | c_include_internal_genlock=1 | c_include_mm2s=1
c_include_mm2s_dre=0 | c_include_mm2s_sf=0 | c_include_s2mm=1 | c_include_s2mm_dre=0
c_include_s2mm_sf=1 | c_include_sg=0 | c_instance=axi_vdma | c_m_axi_mm2s_addr_width=32
c_m_axi_mm2s_data_width=128 | c_m_axi_s2mm_addr_width=32 | c_m_axi_s2mm_data_width=128 | c_m_axi_sg_addr_width=32
c_m_axi_sg_data_width=32 | c_m_axis_mm2s_tdata_width=24 | c_m_axis_mm2s_tuser_bits=1 | c_mm2s_genlock_mode=0
c_mm2s_genlock_num_masters=1 | c_mm2s_genlock_repeat_en=0 | c_mm2s_linebuffer_depth=4096 | c_mm2s_linebuffer_thresh=4
c_mm2s_max_burst_length=32 | c_mm2s_sof_enable=1 | c_num_fstores=3 | c_prmry_is_aclk_async=1
c_s2mm_genlock_mode=0 | c_s2mm_genlock_num_masters=1 | c_s2mm_genlock_repeat_en=1 | c_s2mm_linebuffer_depth=4096
c_s2mm_linebuffer_thresh=4 | c_s2mm_max_burst_length=32 | c_s2mm_sof_enable=1 | c_s_axi_lite_addr_width=9
c_s_axi_lite_data_width=32 | c_s_axis_s2mm_tdata_width=24 | c_s_axis_s2mm_tuser_bits=1 | c_select_xpm=0
c_use_fsync=1 | c_use_mm2s_fsync=0 | c_use_s2mm_fsync=2 | core_container=NA
iptotal=1 | x_ipcorerevision=10 | x_iplanguage=VHDL | x_iplibrary=ip
x_ipname=axi_vdma | x_ipproduct=Vivado 2016.4 | x_ipsimlanguage=MIXED | x_ipvendor=xilinx.com

x_ipversion=6.2

blk_mem_gen_v8_3_5/1
c_addra_width=32 | c_addrb_width=32 | c_algorithm=1 | c_axi_id_width=4
c_axi_slave_type=0 | c_axi_type=1 | c_byte_size=8 | c_common_clk=0
c_count_18k_bram=0 | c_count_36k_bram=256 | c_ctrl_ecc_algo=NONE | c_default_data=0
c_disable_warn_bhv_coll=0 | c_disable_warn_bhv_range=0 | c_elaboration_dir=./ | c_en_deepsleep_pin=0
c_en_ecc_pipe=0 | c_en_rdaddra_chg=0 | c_en_rdaddrb_chg=0 | c_en_safety_ckt=0
c_en_shutdown_pin=0 | c_en_sleep_pin=0 | c_enable_32bit_address=1 | c_est_power_summary=Estimated Power for IP _ 20.388006 mW
c_family=artix7 | c_has_axi_id=0 | c_has_ena=1 | c_has_enb=1
c_has_injecterr=0 | c_has_mem_output_regs_a=0 | c_has_mem_output_regs_b=0 | c_has_mux_output_regs_a=0
c_has_mux_output_regs_b=0 | c_has_regcea=0 | c_has_regceb=0 | c_has_rsta=1
c_has_rstb=1 | c_has_softecc_input_regs_a=0 | c_has_softecc_output_regs_b=0 | c_init_file=NONE
c_init_file_name=no_coe_file_loaded | c_inita_val=0 | c_initb_val=0 | c_interface_type=0
c_load_init_file=0 | c_mem_type=2 | c_mux_pipeline_stages=0 | c_prim_type=1
c_read_depth_a=262144 | c_read_depth_b=262144 | c_read_width_a=32 | c_read_width_b=32
c_rst_priority_a=CE | c_rst_priority_b=CE | c_rstram_a=0 | c_rstram_b=0
c_sim_collision_check=ALL | c_use_bram_block=1 | c_use_byte_wea=1 | c_use_byte_web=1
c_use_default_data=0 | c_use_ecc=0 | c_use_softecc=0 | c_use_uram=0
c_wea_width=4 | c_web_width=4 | c_write_depth_a=262144 | c_write_depth_b=262144
c_write_mode_a=WRITE_FIRST | c_write_mode_b=WRITE_FIRST | c_write_width_a=32 | c_write_width_b=32
c_xdevicefamily=artix7 | core_container=false | iptotal=1 | x_ipcorerevision=5
x_iplanguage=VHDL | x_iplibrary=ip | x_ipname=blk_mem_gen | x_ipproduct=Vivado 2016.4
x_ipsimlanguage=MIXED | x_ipvendor=xilinx.com | x_ipversion=8.3

clk_wiz_v5_3_3_0/1
clkin1_period=10.0 | clkin2_period=10.0 | clock_mgr_type=NA | component_name=hdmi_clk_wiz_0_0
core_container=NA | enable_axi=0 | feedback_source=FDBK_AUTO | feedback_type=SINGLE
iptotal=1 | manual_override=false | num_out_clk=1 | primitive=MMCM
use_dyn_phase_shift=false | use_dyn_reconfig=false | use_inclk_stopped=false | use_inclk_switchover=false
use_locked=true | use_max_i_jitter=false | use_min_o_jitter=false | use_phase_alignment=true
use_power_down=false | use_reset=true

lmb_bram_if_cntlr/1
c_baseaddr=0x0000000000000000 | c_bram_awidth=32 | c_ce_counter_width=0 | c_ce_failing_registers=0
c_ecc=0 | c_ecc_onoff_register=0 | c_ecc_onoff_reset_value=1 | c_ecc_status_registers=0
c_family=artix7 | c_fault_inject=0 | c_highaddr=0x0000000000007FFF | c_interconnect=0
c_lmb_awidth=32 | c_lmb_dwidth=32 | c_mask=0x00000000c0030000 | c_mask1=0x0000000000800000
c_mask2=0x0000000000800000 | c_mask3=0x0000000000800000 | c_num_lmb=1 | c_s_axi_ctrl_addr_width=32
c_s_axi_ctrl_data_width=32 | c_ue_failing_registers=0 | c_write_access=2 | core_container=NA
iptotal=1 | x_ipcorerevision=10 | x_iplanguage=VHDL | x_iplibrary=ip
x_ipname=lmb_bram_if_cntlr | x_ipproduct=Vivado 2016.4 | x_ipsimlanguage=MIXED | x_ipvendor=xilinx.com

x_ipversion=4.0

lmb_bram_if_cntlr/2
c_baseaddr=0x0000000000000000 | c_bram_awidth=32 | c_ce_counter_width=0 | c_ce_failing_registers=0
c_ecc=0 | c_ecc_onoff_register=0 | c_ecc_onoff_reset_value=1 | c_ecc_status_registers=0
c_family=artix7 | c_fault_inject=0 | c_highaddr=0x00000000000FFFFF | c_interconnect=0
c_lmb_awidth=32 | c_lmb_dwidth=32 | c_mask=0x0000000080000000 | c_mask1=0x0000000000800000
c_mask2=0x0000000000800000 | c_mask3=0x0000000000800000 | c_num_lmb=1 | c_s_axi_ctrl_addr_width=32
c_s_axi_ctrl_data_width=32 | c_ue_failing_registers=0 | c_write_access=2 | core_container=NA
iptotal=1 | x_ipcorerevision=10 | x_iplanguage=VHDL | x_iplibrary=ip
x_ipname=lmb_bram_if_cntlr | x_ipproduct=Vivado 2016.4 | x_ipsimlanguage=MIXED | x_ipvendor=xilinx.com

x_ipversion=4.0

lmb_v10/1
c_ext_reset_high=1 | c_lmb_awidth=32 | c_lmb_dwidth=32 | c_lmb_num_slaves=1
core_container=NA | iptotal=2 | x_ipcorerevision=9 | x_iplanguage=VHDL
x_iplibrary=ip | x_ipname=lmb_v10 | x_ipproduct=Vivado 2016.4 | x_ipsimlanguage=MIXED
x_ipvendor=xilinx.com | x_ipversion=3.0

mig_7series_v4_0/1
axi_enable=1 | burst_mode=8 | burst_type=SEQ | ca_mirror=OFF
clk_period=2500 | clkin_period=10000 | core_container=NA | data_mask=1
debug_port=OFF | dq_width=16 | ecc=OFF | interface_type=DDR3
internal_vref=1 | iptotal=1 | language=Verilog | level=CONTROLLER
memory_address_map=BANK_ROW_COLUMN | memory_part=mt41k256m16xx-125 | memory_type=COMP | no_of_controllers=1
ordering=NORM | output_drv=HIGH | phy_ratio=4 | refclk_freq=200
refclk_type=NO_BUFFER | rtt_nom=40 | synthesis_tool=Vivado | sysclk_type=SINGLE_ENDED
use_cs_port=0 | use_odt_port=1 | vccaux_io=1.8V

proc_sys_reset/1
c_aux_reset_high=0 | c_aux_rst_width=4 | c_ext_reset_high=1 | c_ext_rst_width=4
c_family=artix7 | c_num_bus_rst=1 | c_num_interconnect_aresetn=1 | c_num_perp_aresetn=1
c_num_perp_rst=1 | core_container=NA | iptotal=1 | x_ipcorerevision=10
x_iplanguage=VHDL | x_iplibrary=ip | x_ipname=proc_sys_reset | x_ipproduct=Vivado 2016.4
x_ipsimlanguage=MIXED | x_ipvendor=xilinx.com | x_ipversion=5.0

proc_sys_reset/2
c_aux_reset_high=0 | c_aux_rst_width=4 | c_ext_reset_high=0 | c_ext_rst_width=4
c_family=artix7 | c_num_bus_rst=1 | c_num_interconnect_aresetn=1 | c_num_perp_aresetn=1
c_num_perp_rst=1 | core_container=NA | iptotal=1 | x_ipcorerevision=10
x_iplanguage=VHDL | x_iplibrary=ip | x_ipname=proc_sys_reset | x_ipproduct=Vivado 2016.4
x_ipsimlanguage=MIXED | x_ipvendor=xilinx.com | x_ipversion=5.0

v_axi4s_vid_out_v4_0_5/1
c_addr_width=5 | c_components_per_pixel=3 | c_family=artix7 | c_has_async_clk=0
c_hysteresis_level=12 | c_native_component_width=8 | c_native_data_width=24 | c_pixels_per_clock=1
c_s_axis_component_width=8 | c_s_axis_tdata_width=24 | c_sync_lock_threshold=4 | c_vtg_master_slave=1
core_container=false | iptotal=1 | x_ipcorerevision=5 | x_iplanguage=VHDL
x_iplibrary=ip | x_ipname=v_axi4s_vid_out | x_ipproduct=Vivado 2016.4 | x_ipsimlanguage=MIXED
x_ipvendor=xilinx.com | x_ipversion=4.0

v_tc/1
c_det_achroma_en=0 | c_det_avideo_en=1 | c_det_fieldid_en=0 | c_det_hblank_en=1
c_det_hsync_en=1 | c_det_vblank_en=1 | c_det_vsync_en=1 | c_detect_en=0
c_fsync_hstart0=0 | c_fsync_hstart1=0 | c_fsync_hstart10=0 | c_fsync_hstart11=0
c_fsync_hstart12=0 | c_fsync_hstart13=0 | c_fsync_hstart14=0 | c_fsync_hstart15=0
c_fsync_hstart2=0 | c_fsync_hstart3=0 | c_fsync_hstart4=0 | c_fsync_hstart5=0
c_fsync_hstart6=0 | c_fsync_hstart7=0 | c_fsync_hstart8=0 | c_fsync_hstart9=0
c_fsync_vstart0=0 | c_fsync_vstart1=0 | c_fsync_vstart10=0 | c_fsync_vstart11=0
c_fsync_vstart12=0 | c_fsync_vstart13=0 | c_fsync_vstart14=0 | c_fsync_vstart15=0
c_fsync_vstart2=0 | c_fsync_vstart3=0 | c_fsync_vstart4=0 | c_fsync_vstart5=0
c_fsync_vstart6=0 | c_fsync_vstart7=0 | c_fsync_vstart8=0 | c_fsync_vstart9=0
c_gen_achroma_en=0 | c_gen_achroma_polarity=1 | c_gen_auto_switch=0 | c_gen_avideo_en=1
c_gen_avideo_polarity=1 | c_gen_cparity=0 | c_gen_f0_vblank_hend=1280 | c_gen_f0_vblank_hstart=1280
c_gen_f0_vframe_size=750 | c_gen_f0_vsync_hend=1280 | c_gen_f0_vsync_hstart=1280 | c_gen_f0_vsync_vend=729
c_gen_f0_vsync_vstart=724 | c_gen_f1_vblank_hend=1280 | c_gen_f1_vblank_hstart=1280 | c_gen_f1_vframe_size=750
c_gen_f1_vsync_hend=1280 | c_gen_f1_vsync_hstart=1280 | c_gen_f1_vsync_vend=729 | c_gen_f1_vsync_vstart=724
c_gen_fieldid_en=0 | c_gen_fieldid_polarity=1 | c_gen_hactive_size=1280 | c_gen_hblank_en=1
c_gen_hblank_polarity=1 | c_gen_hframe_size=1650 | c_gen_hsync_en=1 | c_gen_hsync_end=1430
c_gen_hsync_polarity=1 | c_gen_hsync_start=1390 | c_gen_interlaced=0 | c_gen_vactive_size=720
c_gen_vblank_en=1 | c_gen_vblank_polarity=1 | c_gen_video_format=2 | c_gen_vsync_en=1
c_gen_vsync_polarity=1 | c_generate_en=1 | c_has_axi4_lite=1 | c_has_intc_if=0
c_interlace_en=0 | c_max_lines=4096 | c_max_pixels=4096 | c_num_fsyncs=1
c_sync_en=0 | core_container=NA | iptotal=1 | x_ipcorerevision=10
x_iplanguage=VHDL | x_iplibrary=ip | x_ipname=v_tc | x_ipproduct=Vivado 2016.4
x_ipsimlanguage=MIXED | x_ipvendor=xilinx.com | x_ipversion=6.1

v_tc/2
c_det_achroma_en=0 | c_det_avideo_en=1 | c_det_fieldid_en=0 | c_det_hblank_en=0
c_det_hsync_en=1 | c_det_vblank_en=0 | c_det_vsync_en=1 | c_detect_en=1
c_fsync_hstart0=0 | c_fsync_hstart1=0 | c_fsync_hstart10=0 | c_fsync_hstart11=0
c_fsync_hstart12=0 | c_fsync_hstart13=0 | c_fsync_hstart14=0 | c_fsync_hstart15=0
c_fsync_hstart2=0 | c_fsync_hstart3=0 | c_fsync_hstart4=0 | c_fsync_hstart5=0
c_fsync_hstart6=0 | c_fsync_hstart7=0 | c_fsync_hstart8=0 | c_fsync_hstart9=0
c_fsync_vstart0=0 | c_fsync_vstart1=0 | c_fsync_vstart10=0 | c_fsync_vstart11=0
c_fsync_vstart12=0 | c_fsync_vstart13=0 | c_fsync_vstart14=0 | c_fsync_vstart15=0
c_fsync_vstart2=0 | c_fsync_vstart3=0 | c_fsync_vstart4=0 | c_fsync_vstart5=0
c_fsync_vstart6=0 | c_fsync_vstart7=0 | c_fsync_vstart8=0 | c_fsync_vstart9=0
c_gen_achroma_en=0 | c_gen_achroma_polarity=1 | c_gen_auto_switch=0 | c_gen_avideo_en=1
c_gen_avideo_polarity=1 | c_gen_cparity=0 | c_gen_f0_vblank_hend=1280 | c_gen_f0_vblank_hstart=1280
c_gen_f0_vframe_size=750 | c_gen_f0_vsync_hend=1280 | c_gen_f0_vsync_hstart=1280 | c_gen_f0_vsync_vend=729
c_gen_f0_vsync_vstart=724 | c_gen_f1_vblank_hend=1280 | c_gen_f1_vblank_hstart=1280 | c_gen_f1_vframe_size=750
c_gen_f1_vsync_hend=1280 | c_gen_f1_vsync_hstart=1280 | c_gen_f1_vsync_vend=729 | c_gen_f1_vsync_vstart=724
c_gen_fieldid_en=0 | c_gen_fieldid_polarity=1 | c_gen_hactive_size=1280 | c_gen_hblank_en=1
c_gen_hblank_polarity=1 | c_gen_hframe_size=1650 | c_gen_hsync_en=1 | c_gen_hsync_end=1430
c_gen_hsync_polarity=1 | c_gen_hsync_start=1390 | c_gen_interlaced=0 | c_gen_vactive_size=720
c_gen_vblank_en=1 | c_gen_vblank_polarity=1 | c_gen_video_format=2 | c_gen_vsync_en=1
c_gen_vsync_polarity=1 | c_generate_en=0 | c_has_axi4_lite=1 | c_has_intc_if=1
c_interlace_en=0 | c_max_lines=2048 | c_max_pixels=4096 | c_num_fsyncs=1
c_sync_en=0 | core_container=NA | iptotal=1 | x_ipcorerevision=10
x_iplanguage=VHDL | x_iplibrary=ip | x_ipname=v_tc | x_ipproduct=Vivado 2016.4
x_ipsimlanguage=MIXED | x_ipvendor=xilinx.com | x_ipversion=6.1

v_vid_in_axi4s_v4_0_5/1
c_addr_width=5 | c_components_per_pixel=3 | c_family=artix7 | c_has_async_clk=1
c_m_axis_component_width=8 | c_m_axis_tdata_width=24 | c_native_component_width=8 | c_native_data_width=24
c_pixels_per_clock=1 | core_container=false | iptotal=1 | x_ipcorerevision=5
x_iplanguage=VHDL | x_iplibrary=ip | x_ipname=v_vid_in_axi4s | x_ipproduct=Vivado 2016.4
x_ipsimlanguage=MIXED | x_ipvendor=xilinx.com | x_ipversion=4.0

xlconcat/1
core_container=NA | dout_width=6 | in0_width=1 | in10_width=1
in11_width=1 | in12_width=1 | in13_width=1 | in14_width=1
in15_width=1 | in16_width=1 | in17_width=1 | in18_width=1
in19_width=1 | in1_width=1 | in20_width=1 | in21_width=1
in22_width=1 | in23_width=1 | in24_width=1 | in25_width=1
in26_width=1 | in27_width=1 | in28_width=1 | in29_width=1
in2_width=1 | in30_width=1 | in31_width=1 | in3_width=1
in4_width=1 | in5_width=1 | in6_width=1 | in7_width=1
in8_width=1 | in9_width=1 | iptotal=1 | num_ports=6
x_ipcorerevision=2 | x_iplanguage=VHDL | x_iplibrary=ip | x_ipname=xlconcat
x_ipproduct=Vivado 2016.4 | x_ipsimlanguage=MIXED | x_ipvendor=xilinx.com | x_ipversion=2.1

report_drc

command_line_options
-append=default::[not_specified] | -checks=default::[not_specified] | -fail_on=default::[not_specified] | -force=default::[not_specified]
-format=default::[not_specified] | -messages=default::[not_specified] | -name=default::[not_specified] | -return_string=default::[not_specified]
-ruledecks=default::[not_specified] | -upgrade_cw=default::[not_specified]

results
bufc-1=14 | cfgbvs-1=1 | check-3=1 | dpip-1=15
dpop-1=3 | dpop-2=2 | reqp-1709=1 | reqp-1827=1
reqp-1839=2 | reqp-1840=20 | rtstat-10=1

report_methodology

command_line_options
-append=default::[not_specified] | -checks=default::[not_specified] | -fail_on=default::[not_specified] | -force=default::[not_specified]
-format=default::[not_specified] | -messages=default::[not_specified] | -name=default::[not_specified] | -return_string=default::[not_specified]

results
pdrc-190=14 | timing-10=1 | timing-16=262 | timing-18=29
timing-27=1 | timing-4=1 | timing-6=1 | timing-7=1
timing-9=1 | xdcb-1=2 | xdcc-1=1 | xdcc-2=1

report_power

command_line_options
-advisory=default::[not_specified] | -append=default::[not_specified] | -file=[specified] | -format=default::text
-hier=default::power | -l=default::[not_specified] | -name=default::[not_specified] | -no_propagation=default::[not_specified]
-return_string=default::[not_specified] | -rpx=[specified] | -verbose=default::[not_specified] | -vid=default::[not_specified]

-xpe=default::[not_specified]

usage
airflow=250 (LFM) | ambient_temp=25.0 (C) | bi-dir_toggle=12.500000 | bidir_output_enable=1.000000
board_layers=12to15 (12 to 15 Layers) | board_selection=medium (10"x10") | bram=0.120999 | clocks=0.134013
confidence_level_clock_activity=High | confidence_level_design_state=High | confidence_level_device_models=High | confidence_level_internal_activity=Medium
confidence_level_io_activity=Low | confidence_level_overall=Low | customer=TBD | customer_class=TBD
devstatic=0.180380 | die=xc7a200tsbg484-1 | dsp=0.003105 | dsp_output_toggle=12.500000
dynamic=1.289350 | effective_thetaja=3.3 | enable_probability=0.990000 | family=artix7
ff_toggle=12.500000 | flow_state=routed | heatsink=medium (Medium Profile) | i/o=0.334136
input_toggle=12.500000 | junction_temp=29.9 (C) | logic=0.041594 | mgtavcc_dynamic_current=0.000000
mgtavcc_static_current=0.000000 | mgtavcc_total_current=0.000000 | mgtavcc_voltage=1.000000 | mgtavtt_dynamic_current=0.000000
mgtavtt_static_current=0.000000 | mgtavtt_total_current=0.000000 | mgtavtt_voltage=1.200000 | mmcm=0.405346
netlist_net_matched=NA | off-chip_power=0.543005 | on-chip_power=1.469729 | output_enable=1.000000
output_load=5.000000 | output_toggle=12.500000 | package=sbg484 | pct_clock_constrained=28.000000
pct_inputs_defined=4 | phaser=0.134441 | platform=nt64 | pll=0.000000
process=typical | ram_enable=50.000000 | ram_write=50.000000 | read_saif=False
set/reset_probability=0.000000 | signal_rate=False | signals=0.111835 | simulation_file=None
speedgrade=-1 | static_prob=False | temp_grade=commercial | thetajb=5.0 (C/W)
thetasa=4.6 (C/W) | toggle_rate=False | user_board_temp=25.0 (C) | user_effective_thetaja=3.3
user_junc_temp=29.9 (C) | user_thetajb=5.0 (C/W) | user_thetasa=4.6 (C/W) | vccadc_dynamic_current=0.001600
vccadc_static_current=0.020000 | vccadc_total_current=0.021600 | vccadc_voltage=1.800000 | vccaux_dynamic_current=0.355482
vccaux_io_dynamic_current=0.000000 | vccaux_io_static_current=0.000000 | vccaux_io_total_current=0.000000 | vccaux_io_voltage=1.800000
vccaux_static_current=0.031079 | vccaux_total_current=0.386561 | vccaux_voltage=1.800000 | vccbram_dynamic_current=0.008733
vccbram_static_current=0.008507 | vccbram_total_current=0.017240 | vccbram_voltage=1.000000 | vccint_dynamic_current=0.447764
vccint_static_current=0.043430 | vccint_total_current=0.491194 | vccint_voltage=1.000000 | vcco12_dynamic_current=0.000000
vcco12_static_current=0.000000 | vcco12_total_current=0.000000 | vcco12_voltage=1.200000 | vcco135_dynamic_current=0.000000
vcco135_static_current=0.000000 | vcco135_total_current=0.000000 | vcco135_voltage=1.350000 | vcco15_dynamic_current=0.488183
vcco15_static_current=0.005000 | vcco15_total_current=0.493183 | vcco15_voltage=1.500000 | vcco18_dynamic_current=0.000000
vcco18_static_current=0.000000 | vcco18_total_current=0.000000 | vcco18_voltage=1.800000 | vcco25_dynamic_current=0.000000
vcco25_static_current=0.005000 | vcco25_total_current=0.005000 | vcco25_voltage=2.500000 | vcco33_dynamic_current=0.000253
vcco33_static_current=0.005000 | vcco33_total_current=0.005253 | vcco33_voltage=3.300000 | version=2016.4

xadc=0.003880

report_utilization

clocking
bufgctrl_available=32 | bufgctrl_fixed=0 | bufgctrl_used=6 | bufgctrl_util_percentage=18.75
bufhce_available=120 | bufhce_fixed=0 | bufhce_used=1 | bufhce_util_percentage=0.83
bufio_available=40 | bufio_fixed=0 | bufio_only_fixed=0 | bufio_only_used=2
bufio_used=2 | bufio_util_percentage=5.00 | bufmrce_available=20 | bufmrce_fixed=0
bufmrce_used=1 | bufmrce_util_percentage=5.00 | bufr_available=40 | bufr_fixed=0
bufr_used=2 | bufr_util_percentage=5.00 | mmcme2_adv_available=10 | mmcme2_adv_fixed=1
mmcme2_adv_used=4 | mmcme2_adv_util_percentage=40.00 | plle2_adv_available=10 | plle2_adv_fixed=1
plle2_adv_used=1 | plle2_adv_util_percentage=10.00

dsp
dsp48e1_only_used=9 | dsps_available=740 | dsps_fixed=0 | dsps_used=9

dsps_util_percentage=1.22

io_standard
blvds_25=0 | diff_hstl_i=0 | diff_hstl_i_18=0 | diff_hstl_ii=0
diff_hstl_ii_18=0 | diff_hsul_12=0 | diff_mobile_ddr=0 | diff_sstl135=0
diff_sstl135_r=0 | diff_sstl15=1 | diff_sstl15_r=0 | diff_sstl18_i=0
diff_sstl18_ii=0 | hstl_i=0 | hstl_i_18=0 | hstl_ii=0
hstl_ii_18=0 | hsul_12=0 | lvcmos12=0 | lvcmos15=1
lvcmos18=0 | lvcmos25=1 | lvcmos33=1 | lvds_25=0
lvttl=0 | mini_lvds_25=0 | mobile_ddr=0 | pci33_3=0
ppds_25=0 | rsds_25=0 | sstl135=0 | sstl135_r=0
sstl15=1 | sstl15_r=0 | sstl18_i=0 | sstl18_ii=0

tmds_33=1

memory
block_ram_tile_available=365 | block_ram_tile_fixed=0 | block_ram_tile_used=292 | block_ram_tile_util_percentage=80.00
fifo36e1_only_used=10 | ramb18_available=730 | ramb18_fixed=0 | ramb18_used=4
ramb18_util_percentage=0.55 | ramb18e1_only_used=4 | ramb36_fifo_available=365 | ramb36_fifo_fixed=0
ramb36_fifo_used=290 | ramb36_fifo_util_percentage=79.45 | ramb36e1_only_used=280

primitives
and2b1l_functional_category=Others | and2b1l_used=3 | bscane2_functional_category=Others | bscane2_used=1
bufg_functional_category=Clock | bufg_used=6 | bufh_functional_category=Clock | bufh_used=1
bufio_functional_category=Clock | bufio_used=2 | bufmr_functional_category=Clock | bufmr_used=1
bufr_functional_category=Clock | bufr_used=2 | carry4_functional_category=CarryLogic | carry4_used=749
dsp48e1_functional_category=Block Arithmetic | dsp48e1_used=9 | fdce_functional_category=Flop & Latch | fdce_used=811
fdpe_functional_category=Flop & Latch | fdpe_used=294 | fdre_functional_category=Flop & Latch | fdre_used=27332
fdse_functional_category=Flop & Latch | fdse_used=942 | fifo36e1_functional_category=Block Memory | fifo36e1_used=10
ibuf_functional_category=IO | ibuf_intermdisable_functional_category=IO | ibuf_intermdisable_used=16 | ibuf_used=21
ibufds_functional_category=IO | ibufds_intermdisable_int_functional_category=IO | ibufds_intermdisable_int_used=4 | ibufds_used=4
idelayctrl_functional_category=IO | idelayctrl_used=2 | idelaye2_functional_category=IO | idelaye2_used=19
in_fifo_functional_category=IO | in_fifo_used=2 | inv_functional_category=LUT | inv_used=3
iserdese2_functional_category=IO | iserdese2_used=22 | lut1_functional_category=LUT | lut1_used=685
lut2_functional_category=LUT | lut2_used=3219 | lut3_functional_category=LUT | lut3_used=7043
lut4_functional_category=LUT | lut4_used=3941 | lut5_functional_category=LUT | lut5_used=5216
lut6_functional_category=LUT | lut6_used=6798 | mmcme2_adv_functional_category=Clock | mmcme2_adv_used=4
muxf7_functional_category=MuxFx | muxf7_used=745 | muxf8_functional_category=MuxFx | muxf8_used=39
obuf_functional_category=IO | obuf_used=27 | obufds_functional_category=IO | obufds_used=6
obuft_functional_category=IO | obuft_used=36 | obuftds_functional_category=IO | obuftds_used=4
oddr_functional_category=IO | oddr_used=5 | oserdese2_functional_category=IO | oserdese2_used=51
out_fifo_functional_category=IO | out_fifo_used=4 | phaser_in_phy_functional_category=IO | phaser_in_phy_used=2
phaser_out_phy_functional_category=IO | phaser_out_phy_used=4 | phaser_ref_functional_category=IO | phaser_ref_used=1
phy_control_functional_category=IO | phy_control_used=1 | plle2_adv_functional_category=Clock | plle2_adv_used=1
ramb18e1_functional_category=Block Memory | ramb18e1_used=4 | ramb36e1_functional_category=Block Memory | ramb36e1_used=280
ramd32_functional_category=Distributed Memory | ramd32_used=1126 | rams32_functional_category=Distributed Memory | rams32_used=866
srl16e_functional_category=Distributed Memory | srl16e_used=1065 | srlc16e_functional_category=Distributed Memory | srlc16e_used=7
srlc32e_functional_category=Distributed Memory | srlc32e_used=207 | xadc_functional_category=Others | xadc_used=1

slice_logic
f7_muxes_available=66900 | f7_muxes_fixed=0 | f7_muxes_used=745 | f7_muxes_util_percentage=1.11
f8_muxes_available=33450 | f8_muxes_fixed=0 | f8_muxes_used=39 | f8_muxes_util_percentage=0.12
lut_as_distributed_ram_fixed=0 | lut_as_distributed_ram_used=1252 | lut_as_logic_available=133800 | lut_as_logic_fixed=0
lut_as_logic_used=21858 | lut_as_logic_util_percentage=16.34 | lut_as_memory_available=46200 | lut_as_memory_fixed=0
lut_as_memory_used=2057 | lut_as_memory_util_percentage=4.45 | lut_as_shift_register_fixed=0 | lut_as_shift_register_used=805
register_as_and_or_available=267600 | register_as_and_or_fixed=0 | register_as_and_or_used=3 | register_as_and_or_util_percentage=<0.01
register_as_flip_flop_available=267600 | register_as_flip_flop_fixed=0 | register_as_flip_flop_used=29373 | register_as_flip_flop_util_percentage=10.98
register_as_latch_available=267600 | register_as_latch_fixed=0 | register_as_latch_used=0 | register_as_latch_util_percentage=0.00
slice_luts_available=133800 | slice_luts_fixed=0 | slice_luts_used=23915 | slice_luts_util_percentage=17.87
slice_registers_available=267600 | slice_registers_fixed=0 | slice_registers_used=29376 | slice_registers_util_percentage=10.98
fully_used_lut_ff_pairs_fixed=10.98 | fully_used_lut_ff_pairs_used=2529 | lut_as_distributed_ram_fixed=0 | lut_as_distributed_ram_used=1252
lut_as_logic_available=133800 | lut_as_logic_fixed=0 | lut_as_logic_used=21858 | lut_as_logic_util_percentage=16.34
lut_as_memory_available=46200 | lut_as_memory_fixed=0 | lut_as_memory_used=2057 | lut_as_memory_util_percentage=4.45
lut_as_shift_register_fixed=0 | lut_as_shift_register_used=805 | lut_ff_pairs_with_one_unused_flip_flop_fixed=805 | lut_ff_pairs_with_one_unused_flip_flop_used=7552
lut_ff_pairs_with_one_unused_lut_output_fixed=7552 | lut_ff_pairs_with_one_unused_lut_output_used=7770 | lut_flip_flop_pairs_available=133800 | lut_flip_flop_pairs_fixed=0
lut_flip_flop_pairs_used=11143 | lut_flip_flop_pairs_util_percentage=8.33 | slice_available=33450 | slice_fixed=0
slice_used=9874 | slice_util_percentage=29.52 | slicel_fixed=0 | slicel_used=6353
slicem_fixed=0 | slicem_used=3521 | unique_control_sets_used=1069 | using_o5_and_o6_fixed=1069
using_o5_and_o6_used=474 | using_o5_output_only_fixed=474 | using_o5_output_only_used=47 | using_o6_output_only_fixed=47

using_o6_output_only_used=284

specific_feature
bscane2_available=4 | bscane2_fixed=0 | bscane2_used=1 | bscane2_util_percentage=25.00
capturee2_available=1 | capturee2_fixed=0 | capturee2_used=0 | capturee2_util_percentage=0.00
dna_port_available=1 | dna_port_fixed=0 | dna_port_used=0 | dna_port_util_percentage=0.00
efuse_usr_available=1 | efuse_usr_fixed=0 | efuse_usr_used=0 | efuse_usr_util_percentage=0.00
frame_ecce2_available=1 | frame_ecce2_fixed=0 | frame_ecce2_used=0 | frame_ecce2_util_percentage=0.00
icape2_available=2 | icape2_fixed=0 | icape2_used=0 | icape2_util_percentage=0.00
pcie_2_1_available=1 | pcie_2_1_fixed=0 | pcie_2_1_used=0 | pcie_2_1_util_percentage=0.00
startupe2_available=1 | startupe2_fixed=0 | startupe2_used=0 | startupe2_util_percentage=0.00
xadc_available=1 | xadc_fixed=0 | xadc_used=1 | xadc_util_percentage=100.00

router

usage
actual_expansions=125933999 | bogomips=0 | bram18=4 | bram36=290
bufg=0 | bufr=2 | congestion_level=1 | ctrls=1069
dsp=9 | effort=2 | estimated_expansions=48741108 | ff=29382
global_clocks=6 | high_fanout_nets=29 | iob=88 | lut=26450
movable_instances=63873 | nets=75942 | pins=410742 | pll=1
router_runtime=6.000000 | router_timing_driven=1 | threads=2 | timing_constraints_exist=1

synthesis

command_line_options
-assert=default::[not_specified] | -bufg=default::12 | -cascade_dsp=default::auto | -constrset=default::[not_specified]
-control_set_opt_threshold=default::auto | -directive=RuntimeOptimized | -fanout_limit=default::10000 | -flatten_hierarchy=none
-fsm_extraction=off | -gated_clock_conversion=default::off | -generic=default::[not_specified] | -include_dirs=default::[not_specified]
-keep_equivalent_registers=default::[not_specified] | -max_bram=default::-1 | -max_bram_cascade_height=default::-1 | -max_dsp=default::-1
-max_uram=default::-1 | -max_uram_cascade_height=default::-1 | -mode=default::default | -name=default::[not_specified]
-no_lc=default::[not_specified] | -no_srlextract=default::[not_specified] | -no_timing_driven=default::[not_specified] | -part=xc7a200tsbg484-1
-resource_sharing=default::auto | -retiming=default::[not_specified] | -rtl=default::[not_specified] | -rtl_skip_constraints=default::[not_specified]
-rtl_skip_ip=default::[not_specified] | -seu_protect=default::none | -shreg_min_size=default::3 | -top=hdmi_wrapper

-verilog_define=default::[not_specified]

usage
elapsed=00:01:31s | hls_ip=0 | memory_gain=554.047MB | memory_peak=969.762MB
