aditya-167/SuperPong-FPGA/hw/HDMI.runs/hdmi_PmodJSTK2_0_1_synth_1/.Xil/hdmi_PmodJSTK2_0_1_propImpl.xdc

set_property SRC_FILE_INFO {cfile:c:/Users/Public/Vivado_Projects/Nexys-Video-HDMI/src/bd/hdmi/ip/hdmi_PmodJSTK2_0_1/hdmi_PmodJSTK2_0_1_board.xdc rfile:../../../../src/bd/hdmi/ip/hdmi_PmodJSTK2_0_1/hdmi_PmodJSTK2_0_1_board.xdc id:1 order:EARLY used_in_board:yes scoped_inst:inst prop_thru_buffer:yes} [current_design]
set_property SRC_FILE_INFO {cfile:c:/Users/Public/Vivado_Projects/Nexys-Video-HDMI/src/bd/hdmi/ip/hdmi_PmodJSTK2_0_1/src/PmodJSTK2_axi_quad_spi_0_0/PmodJSTK2_axi_quad_spi_0_0_clocks.xdc rfile:../../../../src/bd/hdmi/ip/hdmi_PmodJSTK2_0_1/src/PmodJSTK2_axi_quad_spi_0_0/PmodJSTK2_axi_quad_spi_0_0_clocks.xdc id:2 order:LATE scoped_inst:inst/axi_quad_spi_0/U0} [current_design]
set_property src_info {type:SCOPED_XDC file:1 line:7 export:INPUT save:INPUT read:READ} [current_design]
set_property BOARD_PIN {JA7} [get_ports Pmod_out_pin7_t]
set_property src_info {type:SCOPED_XDC file:1 line:8 export:INPUT save:INPUT read:READ} [current_design]
set_property BOARD_PIN {JA8} [get_ports Pmod_out_pin8_t]
set_property src_info {type:SCOPED_XDC file:1 line:9 export:INPUT save:INPUT read:READ} [current_design]
set_property BOARD_PIN {JA9} [get_ports Pmod_out_pin9_t]
set_property src_info {type:SCOPED_XDC file:1 line:10 export:INPUT save:INPUT read:READ} [current_design]
set_property BOARD_PIN {JA10} [get_ports Pmod_out_pin10_t]
set_property src_info {type:SCOPED_XDC file:2 line:51 export:INPUT save:INPUT read:READ} [current_design]
set_max_delay -from [get_cells -hierarchical -filter {NAME =~*RX_FIFO_II/USE_2N_DEPTH.V6_S6_AND_LATER.I_ASYNC_FIFO_BRAM/inst_fifo_gen/gconvfifo.rf/grf.rf/gntv_or_sync_fifo.gcx.clkx/*rd_pntr_gc_reg[*]}] -to [get_cells -hierarchical -filter {NAME =~*RX_FIFO_II/USE_2N_DEPTH.V6_S6_AND_LATER.I_ASYNC_FIFO_BRAM/inst_fifo_gen/gconvfifo.rf/grf.rf/gntv_or_sync_fifo.gcx.clkx/*gsync_stage[1].wr_stg_inst/Q_reg_reg[*]}] -datapath_only [get_property -min PERIOD [get_clocks -of_objects [get_ports s_axi_aclk]]]
set_property src_info {type:SCOPED_XDC file:2 line:52 export:INPUT save:INPUT read:READ} [current_design]
set_max_delay -from [get_cells -hierarchical -filter {NAME =~*RX_FIFO_II/USE_2N_DEPTH.V6_S6_AND_LATER.I_ASYNC_FIFO_BRAM/inst_fifo_gen/gconvfifo.rf/grf.rf/gntv_or_sync_fifo.gcx.clkx/*wr_pntr_gc_reg[*]}] -to [get_cells -hierarchical -filter {NAME =~*RX_FIFO_II/USE_2N_DEPTH.V6_S6_AND_LATER.I_ASYNC_FIFO_BRAM/inst_fifo_gen/gconvfifo.rf/grf.rf/gntv_or_sync_fifo.gcx.clkx/*gsync_stage[1].rd_stg_inst/Q_reg_reg[*]}] -datapath_only [get_property -min PERIOD [get_clocks -of_objects [get_ports ext_spi_clk]]]
set_property src_info {type:SCOPED_XDC file:2 line:55 export:INPUT save:INPUT read:READ} [current_design]
set_max_delay -from [get_cells -hierarchical -filter {NAME =~*TX_FIFO_II/USE_2N_DEPTH.V6_S6_AND_LATER.I_ASYNC_FIFO_BRAM/inst_fifo_gen/gconvfifo.rf/grf.rf/gntv_or_sync_fifo.gcx.clkx/*rd_pntr_gc_reg[*]}] -to [get_cells -hierarchical -filter {NAME =~*TX_FIFO_II/USE_2N_DEPTH.V6_S6_AND_LATER.I_ASYNC_FIFO_BRAM/inst_fifo_gen/gconvfifo.rf/grf.rf/gntv_or_sync_fifo.gcx.clkx/*gsync_stage[1].wr_stg_inst/Q_reg_reg[*]}] -datapath_only [get_property -min PERIOD [get_clocks -of_objects [get_ports ext_spi_clk]]]
set_property src_info {type:SCOPED_XDC file:2 line:56 export:INPUT save:INPUT read:READ} [current_design]
set_max_delay -from [get_cells -hierarchical -filter {NAME =~*TX_FIFO_II/USE_2N_DEPTH.V6_S6_AND_LATER.I_ASYNC_FIFO_BRAM/inst_fifo_gen/gconvfifo.rf/grf.rf/gntv_or_sync_fifo.gcx.clkx/*wr_pntr_gc_reg[*]}] -to [get_cells -hierarchical -filter {NAME =~*TX_FIFO_II/USE_2N_DEPTH.V6_S6_AND_LATER.I_ASYNC_FIFO_BRAM/inst_fifo_gen/gconvfifo.rf/grf.rf/gntv_or_sync_fifo.gcx.clkx/*gsync_stage[1].rd_stg_inst/Q_reg_reg[*]}] -datapath_only [get_property -min PERIOD [get_clocks -of_objects [get_ports s_axi_aclk]]]
set_property src_info {type:SCOPED_XDC file:2 line:61 export:INPUT save:INPUT read:READ} [current_design]
set_bus_skew -from [get_cells [list {inst/axi_quad_spi_0/U0/NO_DUAL_QUAD_MODE.QSPI_NORMAL/QSPI_LEGACY_MD_GEN.QSPI_CORE_INTERFACE_I/FIFO_EXISTS.RX_FIFO_II/USE_2N_DEPTH.V6_S6_AND_LATER.I_ASYNC_FIFO_BRAM/inst_fifo_gen/gconvfifo.rf/grf.rf/gntv_or_sync_fifo.gcx.clkx/gnxpm_cdc.rd_pntr_gc_reg[0]} {inst/axi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
set_property src_info {type:SCOPED_XDC file:2 line:62 export:INPUT save:INPUT read:READ} [current_design]
set_bus_skew -from [get_cells [list {inst/axi_quad_spi_0/U0/NO_DUAL_QUAD_MODE.QSPI_NORMAL/QSPI_LEGACY_MD_GEN.QSPI_CORE_INTERFACE_I/FIFO_EXISTS.RX_FIFO_II/USE_2N_DEPTH.V6_S6_AND_LATER.I_ASYNC_FIFO_BRAM/inst_fifo_gen/gconvfifo.rf/grf.rf/gntv_or_sync_fifo.gcx.clkx/gnxpm_cdc.rd_pntr_gc_reg[0]} {inst/axi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
