aditya-167/SuperPong-FPGA/src/bd/hdmi/hdl/hdmi.vhd

--Copyright 1986-2016 Xilinx, Inc. All Rights Reserved.
----------------------------------------------------------------------------------
--Tool Version: Vivado v.2016.4 (win64) Build 1756540 Mon Jan 23 19:11:23 MST 2017
--Date        : Tue Feb 28 22:46:10 2023
--Host        : DESKTOP-RMQ09J8 running 64-bit major release  (build 9200)
--Command     : generate_target hdmi.bd
--Design      : hdmi
--Purpose     : IP block netlist
----------------------------------------------------------------------------------
library IEEE;
use IEEE.STD_LOGIC_1164.ALL;
library UNISIM;
use UNISIM.VCOMPONENTS.ALL;
entity m00_couplers_imp_1HARIPC is
  port (
    M_ACLK : in STD_LOGIC;
    M_ARESETN : in STD_LOGIC;
    M_AXI_araddr : out STD_LOGIC_VECTOR ( 31 downto 0 );
    M_AXI_arready : in STD_LOGIC_VECTOR ( 0 to 0 );
    M_AXI_arvalid : out STD_LOGIC_VECTOR ( 0 to 0 );
    M_AXI_awaddr : out STD_LOGIC_VECTOR ( 31 downto 0 );
    M_AXI_awready : in STD_LOGIC_VECTOR ( 0 to 0 );
    M_AXI_awvalid : out STD_LOGIC_VECTOR ( 0 to 0 );
    M_AXI_bready : out STD_LOGIC_VECTOR ( 0 to 0 );
    M_AXI_bresp : in STD_LOGIC_VECTOR ( 1 downto 0 );
    M_AXI_bvalid : in STD_LOGIC_VECTOR ( 0 to 0 );
    M_AXI_rdata : in STD_LOGIC_VECTOR ( 31 downto 0 );
    M_AXI_rready : out STD_LOGIC_VECTOR ( 0 to 0 );
    M_AXI_rresp : in STD_LOGIC_VECTOR ( 1 downto 0 );
    M_AXI_rvalid : in STD_LOGIC_VECTOR ( 0 to 0 );
    M_AXI_wdata : out STD_LOGIC_VECTOR ( 31 downto 0 );
    M_AXI_wready : in STD_LOGIC_VECTOR ( 0 to 0 );
    M_AXI_wstrb : out STD_LOGIC_VECTOR ( 3 downto 0 );
    M_AXI_wvalid : out STD_LOGIC_VECTOR ( 0 to 0 );
    S_ACLK : in STD_LOGIC;
    S_ARESETN : in STD_LOGIC;
    S_AXI_araddr : in STD_LOGIC_VECTOR ( 31 downto 0 );
    S_AXI_arready : out STD_LOGIC_VECTOR ( 0 to 0 );
    S_AXI_arvalid : in STD_LOGIC_VECTOR ( 0 to 0 );
    S_AXI_awaddr : in STD_LOGIC_VECTOR ( 31 downto 0 );
    S_AXI_awready : out STD_LOGIC_VECTOR ( 0 to 0 );
    S_AXI_awvalid : in STD_LOGIC_VECTOR ( 0 to 0 );
    S_AXI_bready : in STD_LOGIC_VECTOR ( 0 to 0 );
    S_AXI_bresp : out STD_LOGIC_VECTOR ( 1 downto 0 );
    S_AXI_bvalid : out STD_LOGIC_VECTOR ( 0 to 0 );
    S_AXI_rdata : out STD_LOGIC_VECTOR ( 31 downto 0 );
    S_AXI_rready : in STD_LOGIC_VECTOR ( 0 to 0 );
    S_AXI_rresp : out STD_LOGIC_VECTOR ( 1 downto 0 );
    S_AXI_rvalid : out STD_LOGIC_VECTOR ( 0 to 0 );
    S_AXI_wdata : in STD_LOGIC_VECTOR ( 31 downto 0 );
    S_AXI_wready : out STD_LOGIC_VECTOR ( 0 to 0 );
    S_AXI_wstrb : in STD_LOGIC_VECTOR ( 3 downto 0 );
    S_AXI_wvalid : in STD_LOGIC_VECTOR ( 0 to 0 )
  );
end m00_couplers_imp_1HARIPC;

architecture STRUCTURE of m00_couplers_imp_1HARIPC is
  signal m00_couplers_to_m00_couplers_ARADDR : STD_LOGIC_VECTOR ( 31 downto 0 );
  signal m00_couplers_to_m00_couplers_ARREADY : STD_LOGIC_VECTOR ( 0 to 0 );
  signal m00_couplers_to_m00_couplers_ARVALID : STD_LOGIC_VECTOR ( 0 to 0 );
  signal m00_couplers_to_m00_couplers_AWADDR : STD_LOGIC_VECTOR ( 31 downto 0 );
  signal m00_couplers_to_m00_couplers_AWREADY : STD_LOGIC_VECTOR ( 0 to 0 );
  signal m00_couplers_to_m00_couplers_AWVALID : STD_LOGIC_VECTOR ( 0 to 0 );
  signal m00_couplers_to_m00_couplers_BREADY : STD_LOGIC_VECTOR ( 0 to 0 );
  signal m00_couplers_to_m00_couplers_BRESP : STD_LOGIC_VECTOR ( 1 downto 0 );
  signal m00_couplers_to_m00_couplers_BVALID : STD_LOGIC_VECTOR ( 0 to 0 );
  signal m00_couplers_to_m00_couplers_RDATA : STD_LOGIC_VECTOR ( 31 downto 0 );
  signal m00_couplers_to_m00_couplers_RREADY : STD_LOGIC_VECTOR ( 0 to 0 );
  signal m00_couplers_to_m00_couplers_RRESP : STD_LOGIC_VECTOR ( 1 downto 0 );
  signal m00_couplers_to_m00_couplers_RVALID : STD_LOGIC_VECTOR ( 0 to 0 );
  signal m00_couplers_to_m00_couplers_WDATA : STD_LOGIC_VECTOR ( 31 downto 0 );
  signal m00_couplers_to_m00_couplers_WREADY : STD_LOGIC_VECTOR ( 0 to 0 );
  signal m00_couplers_to_m00_couplers_WSTRB : STD_LOGIC_VECTOR ( 3 downto 0 );
  signal m00_couplers_to_m00_couplers_WVALID : STD_LOGIC_VECTOR ( 0 to 0 );
begin
  M_AXI_araddr(31 downto 0) <= m00_couplers_to_m00_couplers_ARADDR(31 downto 0);
  M_AXI_arvalid(0) <= m00_couplers_to_m00_couplers_ARVALID(0);
  M_AXI_awaddr(31 downto 0) <= m00_couplers_to_m00_couplers_AWADDR(31 downto 0);
  M_AXI_awvalid(0) <= m00_couplers_to_m00_couplers_AWVALID(0);
  M_AXI_bready(0) <= m00_couplers_to_m00_couplers_BREADY(0);
  M_AXI_rready(0) <= m00_couplers_to_m00_couplers_RREADY(0);
  M_AXI_wdata(31 downto 0) <= m00_couplers_to_m00_couplers_WDATA(31 downto 0);
  M_AXI_wstrb(3 downto 0) <= m00_couplers_to_m00_couplers_WSTRB(3 downto 0);
  M_AXI_wvalid(0) <= m00_couplers_to_m00_couplers_WVALID(0);
  S_AXI_arready(0) <= m00_couplers_to_m00_couplers_ARREADY(0);
  S_AXI_awready(0) <= m00_couplers_to_m00_couplers_AWREADY(0);
  S_AXI_bresp(1 downto 0) <= m00_couplers_to_m00_couplers_BRESP(1 downto 0);
  S_AXI_bvalid(0) <= m00_couplers_to_m00_couplers_BVALID(0);
  S_AXI_rdata(31 downto 0) <= m00_couplers_to_m00_couplers_RDATA(31 downto 0);
  S_AXI_rresp(1 downto 0) <= m00_couplers_to_m00_couplers_RRESP(1 downto 0);
  S_AXI_rvalid(0) <= m00_couplers_to_m00_couplers_RVALID(0);
  S_AXI_wready(0) <= m00_couplers_to_m00_couplers_WREADY(0);
  m00_couplers_to_m00_couplers_ARADDR(31 downto 0) <= S_AXI_araddr(31 downto 0);
  m00_couplers_to_m00_couplers_ARREADY(0) <= M_AXI_arready(0);
  m00_couplers_to_m00_couplers_ARVALID(0) <= S_AXI_arvalid(0);
  m00_couplers_to_m00_couplers_AWADDR(31 downto 0) <= S_AXI_awaddr(31 downto 0);
  m00_couplers_to_m00_couplers_AWREADY(0) <= M_AXI_awready(0);
  m00_couplers_to_m00_couplers_AWVALID(0) <= S_AXI_awvalid(0);
  m00_couplers_to_m00_couplers_BREADY(0) <= S_AXI_bready(0);
  m00_couplers_to_m00_couplers_BRESP(1 downto 0) <= M_AXI_bresp(1 downto 0);
  m00_couplers_to_m00_couplers_BVALID(0) <= M_AXI_bvalid(0);
  m00_couplers_to_m00_couplers_RDATA(31 downto 0) <= M_AXI_rdata(31 downto 0);
  m00_couplers_to_m00_couplers_RREADY(0) <= S_AXI_rready(0);
  m00_couplers_to_m00_couplers_RRESP(1 downto 0) <= M_AXI_rresp(1 downto 0);
  m00_couplers_to_m00_couplers_RVALID(0) <= M_AXI_rvalid(0);
  m00_couplers_to_m00_couplers_WDATA(31 downto 0) <= S_AXI_wdata(31 downto 0);
  m00_couplers_to_m00_couplers_WREADY(0) <= M_AXI_wready(0);
  m00_couplers_to_m00_couplers_WSTRB(3 downto 0) <= S_AXI_wstrb(3 downto 0);
  m00_couplers_to_m00_couplers_WVALID(0) <= S_AXI_wvalid(0);
end STRUCTURE;
library IEEE;
use IEEE.STD_LOGIC_1164.ALL;
library UNISIM;
use UNISIM.VCOMPONENTS.ALL;
entity m00_couplers_imp_JC9FNM is
  port (
    M_ACLK : in STD_LOGIC;
    M_ARESETN : in STD_LOGIC;
    M_AXI_araddr : out STD_LOGIC_VECTOR ( 28 downto 0 );
    M_AXI_arburst : out STD_LOGIC_VECTOR ( 1 downto 0 );
    M_AXI_arcache : out STD_LOGIC_VECTOR ( 3 downto 0 );
    M_AXI_arlen : out STD_LOGIC_VECTOR ( 7 downto 0 );
    M_AXI_arlock : out STD_LOGIC;
    M_AXI_arprot : out STD_LOGIC_VECTOR ( 2 downto 0 );
    M_AXI_arqos : out STD_LOGIC_VECTOR ( 3 downto 0 );
    M_AXI_arready : in STD_LOGIC;
    M_AXI_arsize : out STD_LOGIC_VECTOR ( 2 downto 0 );
    M_AXI_arvalid : out STD_LOGIC;
    M_AXI_awaddr : out STD_LOGIC_VECTOR ( 28 downto 0 );
    M_AXI_awburst : out STD_LOGIC_VECTOR ( 1 downto 0 );
    M_AXI_awcache : out STD_LOGIC_VECTOR ( 3 downto 0 );
    M_AXI_awlen : out STD_LOGIC_VECTOR ( 7 downto 0 );
    M_AXI_awlock : out STD_LOGIC;
    M_AXI_awprot : out STD_LOGIC_VECTOR ( 2 downto 0 );
    M_AXI_awqos : out STD_LOGIC_VECTOR ( 3 downto 0 );
    M_AXI_awready : in STD_LOGIC;
    M_AXI_awsize : out STD_LOGIC_VECTOR ( 2 downto 0 );
    M_AXI_awvalid : out STD_LOGIC;
    M_AXI_bready : out STD_LOGIC;
    M_AXI_bresp : in STD_LOGIC_VECTOR ( 1 downto 0 );
    M_AXI_bvalid : in STD_LOGIC;
    M_AXI_rdata : in STD_LOGIC_VECTOR ( 127 downto 0 );
    M_AXI_rlast : in STD_LOGIC;
    M_AXI_rready : out STD_LOGIC;
    M_AXI_rresp : in STD_LOGIC_VECTOR ( 1 downto 0 );
    M_AXI_rvalid : in STD_LOGIC;
    M_AXI_wdata : out STD_LOGIC_VECTOR ( 127 downto 0 );
    M_AXI_wlast : out STD_LOGIC;
    M_AXI_wready : in STD_LOGIC;
    M_AXI_wstrb : out STD_LOGIC_VECTOR ( 15 downto 0 );
    M_AXI_wvalid : out STD_LOGIC;
    S_ACLK : in STD_LOGIC;
    S_ARESETN : in STD_LOGIC;
    S_AXI_araddr : in STD_LOGIC_VECTOR ( 31 downto 0 );
    S_AXI_arburst : in STD_LOGIC_VECTOR ( 1 downto 0 );
    S_AXI_arcache : in STD_LOGIC_VECTOR ( 3 downto 0 );
    S_AXI_arid : in STD_LOGIC_VECTOR ( 1 downto 0 );
    S_AXI_arlen : in STD_LOGIC_VECTOR ( 7 downto 0 );
    S_AXI_arlock : in STD_LOGIC_VECTOR ( 0 to 0 );
    S_AXI_arprot : in STD_LOGIC_VECTOR ( 2 downto 0 );
    S_AXI_arqos : in STD_LOGIC_VECTOR ( 3 downto 0 );
    S_AXI_arready : out STD_LOGIC;
    S_AXI_arregion : in STD_LOGIC_VECTOR ( 3 downto 0 );
    S_AXI_arsize : in STD_LOGIC_VECTOR ( 2 downto 0 );
    S_AXI_arvalid : in STD_LOGIC;
    S_AXI_awaddr : in STD_LOGIC_VECTOR ( 31 downto 0 );
    S_AXI_awburst : in STD_LOGIC_VECTOR ( 1 downto 0 );
    S_AXI_awcache : in STD_LOGIC_VECTOR ( 3 downto 0 );
    S_AXI_awid : in STD_LOGIC_VECTOR ( 1 downto 0 );
    S_AXI_awlen : in STD_LOGIC_VECTOR ( 7 downto 0 );
    S_AXI_awlock : in STD_LOGIC_VECTOR ( 0 to 0 );
    S_AXI_awprot : in STD_LOGIC_VECTOR ( 2 downto 0 );
    S_AXI_awqos : in STD_LOGIC_VECTOR ( 3 downto 0 );
    S_AXI_awready : out STD_LOGIC;
    S_AXI_awregion : in STD_LOGIC_VECTOR ( 3 downto 0 );
    S_AXI_awsize : in STD_LOGIC_VECTOR ( 2 downto 0 );
    S_AXI_awvalid : in STD_LOGIC;
    S_AXI_bid : out STD_LOGIC_VECTOR ( 1 downto 0 );
    S_AXI_bready : in STD_LOGIC;
    S_AXI_bresp : out STD_LOGIC_VECTOR ( 1 downto 0 );
    S_AXI_bvalid : out STD_LOGIC;
    S_AXI_rdata : out STD_LOGIC_VECTOR ( 255 downto 0 );
    S_AXI_rid : out STD_LOGIC_VECTOR ( 1 downto 0 );
    S_AXI_rlast : out STD_LOGIC;
    S_AXI_rready : in STD_LOGIC;
    S_AXI_rresp : out STD_LOGIC_VECTOR ( 1 downto 0 );
    S_AXI_rvalid : out STD_LOGIC;
    S_AXI_wdata : in STD_LOGIC_VECTOR ( 255 downto 0 );
    S_AXI_wlast : in STD_LOGIC;
    S_AXI_wready : out STD_LOGIC;
    S_AXI_wstrb : in STD_LOGIC_VECTOR ( 31 downto 0 );
    S_AXI_wvalid : in STD_LOGIC
  );
end m00_couplers_imp_JC9FNM;

architecture STRUCTURE of m00_couplers_imp_JC9FNM is
  component hdmi_m00_regslice_0 is
  port (
    aclk : in STD_LOGIC;
    aresetn : in STD_LOGIC;
    s_axi_awaddr : in STD_LOGIC_VECTOR ( 28 downto 0 );
    s_axi_awlen : in STD_LOGIC_VECTOR ( 7 downto 0 );
    s_axi_awsize : in STD_LOGIC_VECTOR ( 2 downto 0 );
    s_axi_awburst : in STD_LOGIC_VECTOR ( 1 downto 0 );
    s_axi_awlock : in STD_LOGIC_VECTOR ( 0 to 0 );
    s_axi_awcache : in STD_LOGIC_VECTOR ( 3 downto 0 );
    s_axi_awprot : in STD_LOGIC_VECTOR ( 2 downto 0 );
    s_axi_awregion : in STD_LOGIC_VECTOR ( 3 downto 0 );
    s_axi_awqos : in STD_LOGIC_VECTOR ( 3 downto 0 );
    s_axi_awvalid : in STD_LOGIC;
    s_axi_awready : out STD_LOGIC;
    s_axi_wdata : in STD_LOGIC_VECTOR ( 127 downto 0 );
    s_axi_wstrb : in STD_LOGIC_VECTOR ( 15 downto 0 );
    s_axi_wlast : in STD_LOGIC;
    s_axi_wvalid : in STD_LOGIC;
    s_axi_wready : out STD_LOGIC;
    s_axi_bresp : out STD_LOGIC_VECTOR ( 1 downto 0 );
    s_axi_bvalid : out STD_LOGIC;
    s_axi_bready : in STD_LOGIC;
    s_axi_araddr : in STD_LOGIC_VECTOR ( 28 downto 0 );
    s_axi_arlen : in STD_LOGIC_VECTOR ( 7 downto 0 );
    s_axi_arsize : in STD_LOGIC_VECTOR ( 2 downto 0 );
    s_axi_arburst : in STD_LOGIC_VECTOR ( 1 downto 0 );
    s_axi_arlock : in STD_LOGIC_VECTOR ( 0 to 0 );
    s_axi_arcache : in STD_LOGIC_VECTOR ( 3 downto 0 );
    s_axi_arprot : in STD_LOGIC_VECTOR ( 2 downto 0 );
    s_axi_arregion : in STD_LOGIC_VECTOR ( 3 downto 0 );
    s_axi_arqos : in STD_LOGIC_VECTOR ( 3 downto 0 );
    s_axi_arvalid : in STD_LOGIC;
    s_axi_arready : out STD_LOGIC;
    s_axi_rdata : out STD_LOGIC_VECTOR ( 127 downto 0 );
    s_axi_rresp : out STD_LOGIC_VECTOR ( 1 downto 0 );
    s_axi_rlast : out STD_LOGIC;
    s_axi_rvalid : out STD_LOGIC;
    s_axi_rready : in STD_LOGIC;
    m_axi_awaddr : out STD_LOGIC_VECTOR ( 28 downto 0 );
    m_axi_awlen : out STD_LOGIC_VECTOR ( 7 downto 0 );
    m_axi_awsize : out STD_LOGIC_VECTOR ( 2 downto 0 );
    m_axi_awburst : out STD_LOGIC_VECTOR ( 1 downto 0 );
    m_axi_awlock : out STD_LOGIC_VECTOR ( 0 to 0 );
    m_axi_awcache : out STD_LOGIC_VECTOR ( 3 downto 0 );
    m_axi_awprot : out STD_LOGIC_VECTOR ( 2 downto 0 );
    m_axi_awregion : out STD_LOGIC_VECTOR ( 3 downto 0 );
    m_axi_awqos : out STD_LOGIC_VECTOR ( 3 downto 0 );
    m_axi_awvalid : out STD_LOGIC;
    m_axi_awready : in STD_LOGIC;
    m_axi_wdata : out STD_LOGIC_VECTOR ( 127 downto 0 );
    m_axi_wstrb : out STD_LOGIC_VECTOR ( 15 downto 0 );
    m_axi_wlast : out STD_LOGIC;
    m_axi_wvalid : out STD_LOGIC;
    m_axi_wready : in STD_LOGIC;
    m_axi_bresp : in STD_LOGIC_VECTOR ( 1 downto 0 );
    m_axi_bvalid : in STD_LOGIC;
    m_axi_bready : out STD_LOGIC;
    m_axi_araddr : out STD_LOGIC_VECTOR ( 28 downto 0 );
    m_axi_arlen : out STD_LOGIC_VECTOR ( 7 downto 0 );
    m_axi_arsize : out STD_LOGIC_VECTOR ( 2 downto 0 );
    m_axi_arburst : out STD_LOGIC_VECTOR ( 1 downto 0 );
    m_axi_arlock : out STD_LOGIC_VECTOR ( 0 to 0 );
    m_axi_arcache : out STD_LOGIC_VECTOR ( 3 downto 0 );
    m_axi_arprot : out STD_LOGIC_VECTOR ( 2 downto 0 );
    m_axi_arregion : out STD_LOGIC_VECTOR ( 3 downto 0 );
    m_axi_arqos : out STD_LOGIC_VECTOR ( 3 downto 0 );
    m_axi_arvalid : out STD_LOGIC;
    m_axi_arready : in STD_LOGIC;
    m_axi_rdata : in STD_LOGIC_VECTOR ( 127 downto 0 );
    m_axi_rresp : in STD_LOGIC_VECTOR ( 1 downto 0 );
    m_axi_rlast : in STD_LOGIC;
    m_axi_rvalid : in STD_LOGIC;
    m_axi_rready : out STD_LOGIC
  );
  end component hdmi_m00_regslice_0;
  component hdmi_auto_ds_0 is
  port (
    s_axi_aclk : in STD_LOGIC;
    s_axi_aresetn : in STD_LOGIC;
    s_axi_awid : in STD_LOGIC_VECTOR ( 1 downto 0 );
    s_axi_awaddr : in STD_LOGIC_VECTOR ( 28 downto 0 );
    s_axi_awlen : in STD_LOGIC_VECTOR ( 7 downto 0 );
    s_axi_awsize : in STD_LOGIC_VECTOR ( 2 downto 0 );
    s_axi_awburst : in STD_LOGIC_VECTOR ( 1 downto 0 );
    s_axi_awlock : in STD_LOGIC_VECTOR ( 0 to 0 );
    s_axi_awcache : in STD_LOGIC_VECTOR ( 3 downto 0 );
    s_axi_awprot : in STD_LOGIC_VECTOR ( 2 downto 0 );
    s_axi_awregion : in STD_LOGIC_VECTOR ( 3 downto 0 );
    s_axi_awqos : in STD_LOGIC_VECTOR ( 3 downto 0 );
    s_axi_awvalid : in STD_LOGIC;
    s_axi_awready : out STD_LOGIC;
    s_axi_wdata : in STD_LOGIC_VECTOR ( 255 downto 0 );
    s_axi_wstrb : in STD_LOGIC_VECTOR ( 31 downto 0 );
    s_axi_wlast : in STD_LOGIC;
    s_axi_wvalid : in STD_LOGIC;
    s_axi_wready : out STD_LOGIC;
    s_axi_bid : out STD_LOGIC_VECTOR ( 1 downto 0 );
    s_axi_bresp : out STD_LOGIC_VECTOR ( 1 downto 0 );
    s_axi_bvalid : out STD_LOGIC;
    s_axi_bready : in STD_LOGIC;
    s_axi_arid : in STD_LOGIC_VECTOR ( 1 downto 0 );
    s_axi_araddr : in STD_LOGIC_VECTOR ( 28 downto 0 );
    s_axi_arlen : in STD_LOGIC_VECTOR ( 7 downto 0 );
    s_axi_arsize : in STD_LOGIC_VECTOR ( 2 downto 0 );
    s_axi_arburst : in STD_LOGIC_VECTOR ( 1 downto 0 );
    s_axi_arlock : in STD_LOGIC_VECTOR ( 0 to 0 );
    s_axi_arcache : in STD_LOGIC_VECTOR ( 3 downto 0 );
    s_axi_arprot : in STD_LOGIC_VECTOR ( 2 downto 0 );
    s_axi_arregion : in STD_LOGIC_VECTOR ( 3 downto 0 );
    s_axi_arqos : in STD_LOGIC_VECTOR ( 3 downto 0 );
    s_axi_arvalid : in STD_LOGIC;
    s_axi_arready : out STD_LOGIC;
    s_axi_rid : out STD_LOGIC_VECTOR ( 1 downto 0 );
    s_axi_rdata : out STD_LOGIC_VECTOR ( 255 downto 0 );
    s_axi_rresp : out STD_LOGIC_VECTOR ( 1 downto 0 );
    s_axi_rlast : out STD_LOGIC;
    s_axi_rvalid : out STD_LOGIC;
    s_axi_rready : in STD_LOGIC;
    m_axi_awaddr : out STD_LOGIC_VECTOR ( 28 downto 0 );
    m_axi_awlen : out STD_LOGIC_VECTOR ( 7 downto 0 );
    m_axi_awsize : out STD_LOGIC_VECTOR ( 2 downto 0 );
    m_axi_awburst : out STD_LOGIC_VECTOR ( 1 downto 0 );
    m_axi_awlock : out STD_LOGIC_VECTOR ( 0 to 0 );
    m_axi_awcache : out STD_LOGIC_VECTOR ( 3 downto 0 );
    m_axi_awprot : out STD_LOGIC_VECTOR ( 2 downto 0 );
    m_axi_awregion : out STD_LOGIC_VECTOR ( 3 downto 0 );
    m_axi_awqos : out STD_LOGIC_VECTOR ( 3 downto 0 );
    m_axi_awvalid : out STD_LOGIC;
    m_axi_awready : in STD_LOGIC;
    m_axi_wdata : out STD_LOGIC_VECTOR ( 127 downto 0 );
    m_axi_wstrb : out STD_LOGIC_VECTOR ( 15 downto 0 );
    m_axi_wlast : out STD_LOGIC;
    m_axi_wvalid : out STD_LOGIC;
    m_axi_wready : in STD_LOGIC;
    m_axi_bresp : in STD_LOGIC_VECTOR ( 1 downto 0 );
    m_axi_bvalid : in STD_LOGIC;
    m_axi_bready : out STD_LOGIC;
    m_axi_araddr : out STD_LOGIC_VECTOR ( 28 downto 0 );
    m_axi_arlen : out STD_LOGIC_VECTOR ( 7 downto 0 );
    m_axi_arsize : out STD_LOGIC_VECTOR ( 2 downto 0 );
    m_axi_arburst : out STD_LOGIC_VECTOR ( 1 downto 0 );
    m_axi_arlock : out STD_LOGIC_VECTOR ( 0 to 0 );
    m_axi_arcache : out STD_LOGIC_VECTOR ( 3 downto 0 );
    m_axi_arprot : out STD_LOGIC_VECTOR ( 2 downto 0 );
    m_axi_arregion : out STD_LOGIC_VECTOR ( 3 downto 0 );
    m_axi_arqos : out STD_LOGIC_VECTOR ( 3 downto 0 );
    m_axi_arvalid : out STD_LOGIC;
    m_axi_arready : in STD_LOGIC;
    m_axi_rdata : in STD_LOGIC_VECTOR ( 127 downto 0 );
    m_axi_rresp : in STD_LOGIC_VECTOR ( 1 downto 0 );
    m_axi_rlast : in STD_LOGIC;
    m_axi_rvalid : in STD_LOGIC;
    m_axi_rready : out STD_LOGIC
  );
  end component hdmi_auto_ds_0;
  component hdmi_auto_rs_w_0 is
  port (
    aclk : in STD_LOGIC;
    aresetn : in STD_LOGIC;
    s_axi_awid : in STD_LOGIC_VECTOR ( 1 downto 0 );
    s_axi_awaddr : in STD_LOGIC_VECTOR ( 28 downto 0 );
    s_axi_awlen : in STD_LOGIC_VECTOR ( 7 downto 0 );
    s_axi_awsize : in STD_LOGIC_VECTOR ( 2 downto 0 );
    s_axi_awburst : in STD_LOGIC_VECTOR ( 1 downto 0 );
    s_axi_awlock : in STD_LOGIC_VECTOR ( 0 to 0 );
    s_axi_awcache : in STD_LOGIC_VECTOR ( 3 downto 0 );
    s_axi_awprot : in STD_LOGIC_VECTOR ( 2 downto 0 );
    s_axi_awregion : in STD_LOGIC_VECTOR ( 3 downto 0 );
    s_axi_awqos : in STD_LOGIC_VECTOR ( 3 downto 0 );
    s_axi_awvalid : in STD_LOGIC;
    s_axi_awready : out STD_LOGIC;
    s_axi_wdata : in STD_LOGIC_VECTOR ( 255 downto 0 );
    s_axi_wstrb : in STD_LOGIC_VECTOR ( 31 downto 0 );
    s_axi_wlast : in STD_LOGIC;
    s_axi_wvalid : in STD_LOGIC;
    s_axi_wready : out STD_LOGIC;
    s_axi_bid : out STD_LOGIC_VECTOR ( 1 downto 0 );
    s_axi_bresp : out STD_LOGIC_VECTOR ( 1 downto 0 );
    s_axi_bvalid : out STD_LOGIC;
    s_axi_bready : in STD_LOGIC;
    s_axi_arid : in STD_LOGIC_VECTOR ( 1 downto 0 );
    s_axi_araddr : in STD_LOGIC_VECTOR ( 28 downto 0 );
    s_axi_arlen : in STD_LOGIC_VECTOR ( 7 downto 0 );
    s_axi_arsize : in STD_LOGIC_VECTOR ( 2 downto 0 );
    s_axi_arburst : in STD_LOGIC_VECTOR ( 1 downto 0 );
    s_axi_arlock : in STD_LOGIC_VECTOR ( 0 to 0 );
    s_axi_arcache : in STD_LOGIC_VECTOR ( 3 downto 0 );
    s_axi_arprot : in STD_LOGIC_VECTOR ( 2 downto 0 );
    s_axi_arregion : in STD_LOGIC_VECTOR ( 3 downto 0 );
    s_axi_arqos : in STD_LOGIC_VECTOR ( 3 downto 0 );
    s_axi_arvalid : in STD_LOGIC;
    s_axi_arready : out STD_LOGIC;
    s_axi_rid : out STD_LOGIC_VECTOR ( 1 downto 0 );
    s_axi_rdata : out STD_LOGIC_VECTOR ( 255 downto 0 );
    s_axi_rresp : out STD_LOGIC_VECTOR ( 1 downto 0 );
    s_axi_rlast : out STD_LOGIC;
    s_axi_rvalid : out STD_LOGIC;
    s_axi_rready : in STD_LOGIC;
    m_axi_awid : out STD_LOGIC_VECTOR ( 1 downto 0 );
    m_axi_awaddr : out STD_LOGIC_VECTOR ( 28 downto 0 );
    m_axi_awlen : out STD_LOGIC_VECTOR ( 7 downto 0 );
    m_axi_awsize : out STD_LOGIC_VECTOR ( 2 downto 0 );
    m_axi_awburst : out STD_LOGIC_VECTOR ( 1 downto 0 );
    m_axi_awlock : out STD_LOGIC_VECTOR ( 0 to 0 );
    m_axi_awcache : out STD_LOGIC_VECTOR ( 3 downto 0 );
    m_axi_awprot : out STD_LOGIC_VECTOR ( 2 downto 0 );
    m_axi_awregion : out STD_LOGIC_VECTOR ( 3 downto 0 );
    m_axi_awqos : out STD_LOGIC_VECTOR ( 3 downto 0 );
    m_axi_awvalid : out STD_LOGIC;
    m_axi_awready : in STD_LOGIC;
    m_axi_wdata : out STD_LOGIC_VECTOR ( 255 downto 0 );
    m_axi_wstrb : out STD_LOGIC_VECTOR ( 31 downto 0 );
    m_axi_wlast : out STD_LOGIC;
    m_axi_wvalid : out STD_LOGIC;
    m_axi_wready : in STD_LOGIC;
    m_axi_bid : in STD_LOGIC_VECTOR ( 1 downto 0 );
    m_axi_bresp : in STD_LOGIC_VECTOR ( 1 downto 0 );
    m_axi_bvalid : in STD_LOGIC;
    m_axi_bready : out STD_LOGIC;
    m_axi_arid : out STD_LOGIC_VECTOR ( 1 downto 0 );
    m_axi_araddr : out STD_LOGIC_VECTOR ( 28 downto 0 );
    m_axi_arlen : out STD_LOGIC_VECTOR ( 7 downto 0 );
    m_axi_arsize : out STD_LOGIC_VECTOR ( 2 downto 0 );
    m_axi_arburst : out STD_LOGIC_VECTOR ( 1 downto 0 );
    m_axi_arlock : out STD_LOGIC_VECTOR ( 0 to 0 );
    m_axi_arcache : out STD_LOGIC_VECTOR ( 3 downto 0 );
    m_axi_arprot : out STD_LOGIC_VECTOR ( 2 downto 0 );
    m_axi_arregion : out STD_LOGIC_VECTOR ( 3 downto 0 );
    m_axi_arqos : out STD_LOGIC_VECTOR ( 3 downto 0 );
    m_axi_arvalid : out STD_LOGIC;
    m_axi_arready : in STD_LOGIC;
    m_axi_rid : in STD_LOGIC_VECTOR ( 1 downto 0 );
    m_axi_rdata : in STD_LOGIC_VECTOR ( 255 downto 0 );
    m_axi_rresp : in STD_LOGIC_VECTOR ( 1 downto 0 );
    m_axi_rlast : in STD_LOGIC;
    m_axi_rvalid : in STD_LOGIC;
    m_axi_rready : out STD_LOGIC
  );
  end component hdmi_auto_rs_w_0;
  signal M_ACLK_1 : STD_LOGIC;
  signal M_ARESETN_1 : STD_LOGIC;
  signal S_ACLK_1 : STD_LOGIC;
  signal S_ARESETN_1 : STD_LOGIC;
  signal auto_ds_to_m00_regslice_ARADDR : STD_LOGIC_VECTOR ( 28 downto 0 );
  signal auto_ds_to_m00_regslice_ARBURST : STD_LOGIC_VECTOR ( 1 downto 0 );
  signal auto_ds_to_m00_regslice_ARCACHE : STD_LOGIC_VECTOR ( 3 downto 0 );
  signal auto_ds_to_m00_regslice_ARLEN : STD_LOGIC_VECTOR ( 7 downto 0 );
  signal auto_ds_to_m00_regslice_ARLOCK : STD_LOGIC_VECTOR ( 0 to 0 );
  signal auto_ds_to_m00_regslice_ARPROT : STD_LOGIC_VECTOR ( 2 downto 0 );
  signal auto_ds_to_m00_regslice_ARQOS : STD_LOGIC_VECTOR ( 3 downto 0 );
  signal auto_ds_to_m00_regslice_ARREADY : STD_LOGIC;
  signal auto_ds_to_m00_regslice_ARREGION : STD_LOGIC_VECTOR ( 3 downto 0 );
  signal auto_ds_to_m00_regslice_ARSIZE : STD_LOGIC_VECTOR ( 2 downto 0 );
  signal auto_ds_to_m00_regslice_ARVALID : STD_LOGIC;
  signal auto_ds_to_m00_regslice_AWADDR : STD_LOGIC_VECTOR ( 28 downto 0 );
  signal auto_ds_to_m00_regslice_AWBURST : STD_LOGIC_VECTOR ( 1 downto 0 );
  signal auto_ds_to_m00_regslice_AWCACHE : STD_LOGIC_VECTOR ( 3 downto 0 );
  signal auto_ds_to_m00_regslice_AWLEN : STD_LOGIC_VECTOR ( 7 downto 0 );
  signal auto_ds_to_m00_regslice_AWLOCK : STD_LOGIC_VECTOR ( 0 to 0 );
  signal auto_ds_to_m00_regslice_AWPROT : STD_LOGIC_VECTOR ( 2 downto 0 );
  signal auto_ds_to_m00_regslice_AWQOS : STD_LOGIC_VECTOR ( 3 downto 0 );
  signal auto_ds_to_m00_regslice_AWREADY : STD_LOGIC;
  signal auto_ds_to_m00_regslice_AWREGION : STD_LOGIC_VECTOR ( 3 downto 0 );
  signal auto_ds_to_m00_regslice_AWSIZE : STD_LOGIC_VECTOR ( 2 downto 0 );
  signal auto_ds_to_m00_regslice_AWVALID : STD_LOGIC;
  signal auto_ds_to_m00_regslice_BREADY : STD_LOGIC;
  signal auto_ds_to_m00_regslice_BRESP : STD_LOGIC_VECTOR ( 1 downto 0 );
  signal auto_ds_to_m00_regslice_BVALID : STD_LOGIC;
  signal auto_ds_to_m00_regslice_RDATA : STD_LOGIC_VECTOR ( 127 downto 0 );
  signal auto_ds_to_m00_regslice_RLAST : STD_LOGIC;
  signal auto_ds_to_m00_regslice_RREADY : STD_LOGIC;
  signal auto_ds_to_m00_regslice_RRESP : STD_LOGIC_VECTOR ( 1 downto 0 );
  signal auto_ds_to_m00_regslice_RVALID : STD_LOGIC;
  signal auto_ds_to_m00_regslice_WDATA : STD_LOGIC_VECTOR ( 127 downto 0 );
  signal auto_ds_to_m00_regslice_WLAST : STD_LOGIC;
  signal auto_ds_to_m00_regslice_WREADY : STD_LOGIC;
  signal auto_ds_to_m00_regslice_WSTRB : STD_LOGIC_VECTOR ( 15 downto 0 );
  signal auto_ds_to_m00_regslice_WVALID : STD_LOGIC;
  signal auto_rs_w_to_auto_ds_ARADDR : STD_LOGIC_VECTOR ( 28 downto 0 );
  signal auto_rs_w_to_auto_ds_ARBURST : STD_LOGIC_VECTOR ( 1 downto 0 );
  signal auto_rs_w_to_auto_ds_ARCACHE : STD_LOGIC_VECTOR ( 3 downto 0 );
  signal auto_rs_w_to_auto_ds_ARID : STD_LOGIC_VECTOR ( 1 downto 0 );
  signal auto_rs_w_to_auto_ds_ARLEN : STD_LOGIC_VECTOR ( 7 downto 0 );
  signal auto_rs_w_to_auto_ds_ARLOCK : STD_LOGIC_VECTOR ( 0 to 0 );
  signal auto_rs_w_to_auto_ds_ARPROT : STD_LOGIC_VECTOR ( 2 downto 0 );
  signal auto_rs_w_to_auto_ds_ARQOS : STD_LOGIC_VECTOR ( 3 downto 0 );
  signal auto_rs_w_to_auto_ds_ARREADY : STD_LOGIC;
  signal auto_rs_w_to_auto_ds_ARREGION : STD_LOGIC_VECTOR ( 3 downto 0 );
  signal auto_rs_w_to_auto_ds_ARSIZE : STD_LOGIC_VECTOR ( 2 downto 0 );
  signal auto_rs_w_to_auto_ds_ARVALID : STD_LOGIC;
  signal auto_rs_w_to_auto_ds_AWADDR : STD_LOGIC_VECTOR ( 28 downto 0 );
  signal auto_rs_w_to_auto_ds_AWBURST : STD_LOGIC_VECTOR ( 1 downto 0 );
  signal auto_rs_w_to_auto_ds_AWCACHE : STD_LOGIC_VECTOR ( 3 downto 0 );
  signal auto_rs_w_to_auto_ds_AWID : STD_LOGIC_VECTOR ( 1 downto 0 );
  signal auto_rs_w_to_auto_ds_AWLEN : STD_LOGIC_VECTOR ( 7 downto 0 );
  signal auto_rs_w_to_auto_ds_AWLOCK : STD_LOGIC_VECTOR ( 0 to 0 );
  signal auto_rs_w_to_auto_ds_AWPROT : STD_LOGIC_VECTOR ( 2 downto 0 );
  signal auto_rs_w_to_auto_ds_AWQOS : STD_LOGIC_VECTOR ( 3 downto 0 );
  signal auto_rs_w_to_auto_ds_AWREADY : STD_LOGIC;
  signal auto_rs_w_to_auto_ds_AWREGION : STD_LOGIC_VECTOR ( 3 downto 0 );
  signal auto_rs_w_to_auto_ds_AWSIZE : STD_LOGIC_VECTOR ( 2 downto 0 );
  signal auto_rs_w_to_auto_ds_AWVALID : STD_LOGIC;
  signal auto_rs_w_to_auto_ds_BID : STD_LOGIC_VECTOR ( 1 downto 0 );
  signal auto_rs_w_to_auto_ds_BREADY : STD_LOGIC;
  signal auto_rs_w_to_auto_ds_BRESP : STD_LOGIC_VECTOR ( 1 downto 0 );
  signal auto_rs_w_to_auto_ds_BVALID : STD_LOGIC;
  signal auto_rs_w_to_auto_ds_RDATA : STD_LOGIC_VECTOR ( 255 downto 0 );
  signal auto_rs_w_to_auto_ds_RID : STD_LOGIC_VECTOR ( 1 downto 0 );
  signal auto_rs_w_to_auto_ds_RLAST : STD_LOGIC;
  signal auto_rs_w_to_auto_ds_RREADY : STD_LOGIC;
  signal auto_rs_w_to_auto_ds_RRESP : STD_LOGIC_VECTOR ( 1 downto 0 );
  signal auto_rs_w_to_auto_ds_RVALID : STD_LOGIC;
  signal auto_rs_w_to_auto_ds_WDATA : STD_LOGIC_VECTOR ( 255 downto 0 );
  signal auto_rs_w_to_auto_ds_WLAST : STD_LOGIC;
  signal auto_rs_w_to_auto_ds_WREADY : STD_LOGIC;
  signal auto_rs_w_to_auto_ds_WSTRB : STD_LOGIC_VECTOR ( 31 downto 0 );
  signal auto_rs_w_to_auto_ds_WVALID : STD_LOGIC;
  signal m00_couplers_to_auto_rs_w_ARADDR : STD_LOGIC_VECTOR ( 31 downto 0 );
  signal m00_couplers_to_auto_rs_w_ARBURST : STD_LOGIC_VECTOR ( 1 downto 0 );
  signal m00_couplers_to_auto_rs_w_ARCACHE : STD_LOGIC_VECTOR ( 3 downto 0 );
  signal m00_couplers_to_auto_rs_w_ARID : STD_LOGIC_VECTOR ( 1 downto 0 );
  signal m00_couplers_to_auto_rs_w_ARLEN : STD_LOGIC_VECTOR ( 7 downto 0 );
  signal m00_couplers_to_auto_rs_w_ARLOCK : STD_LOGIC_VECTOR ( 0 to 0 );
  signal m00_couplers_to_auto_rs_w_ARPROT : STD_LOGIC_VECTOR ( 2 downto 0 );
  signal m00_couplers_to_auto_rs_w_ARQOS : STD_LOGIC_VECTOR ( 3 downto 0 );
  signal m00_couplers_to_auto_rs_w_ARREADY : STD_LOGIC;
  signal m00_couplers_to_auto_rs_w_ARREGION : STD_LOGIC_VECTOR ( 3 downto 0 );
  signal m00_couplers_to_auto_rs_w_ARSIZE : STD_LOGIC_VECTOR ( 2 downto 0 );
  signal m00_couplers_to_auto_rs_w_ARVALID : STD_LOGIC;
  signal m00_couplers_to_auto_rs_w_AWADDR : STD_LOGIC_VECTOR ( 31 downto 0 );
  signal m00_couplers_to_auto_rs_w_AWBURST : STD_LOGIC_VECTOR ( 1 downto 0 );
  signal m00_couplers_to_auto_rs_w_AWCACHE : STD_LOGIC_VECTOR ( 3 downto 0 );
  signal m00_couplers_to_auto_rs_w_AWID : STD_LOGIC_VECTOR ( 1 downto 0 );
  signal m00_couplers_to_auto_rs_w_AWLEN : STD_LOGIC_VECTOR ( 7 downto 0 );
  signal m00_couplers_to_auto_rs_w_AWLOCK : STD_LOGIC_VECTOR ( 0 to 0 );
  signal m00_couplers_to_auto_rs_w_AWPROT : STD_LOGIC_VECTOR ( 2 downto 0 );
  signal m00_couplers_to_auto_rs_w_AWQOS : STD_LOGIC_VECTOR ( 3 downto 0 );
  signal m00_couplers_to_auto_rs_w_AWREADY : STD_LOGIC;
  signal m00_couplers_to_auto_rs_w_AWREGION : STD_LOGIC_VECTOR ( 3 downto 0 );
  signal m00_couplers_to_auto_rs_w_AWSIZE : STD_LOGIC_VECTOR ( 2 downto 0 );
  signal m00_couplers_to_auto_rs_w_AWVALID : STD_LOGIC;
  signal m00_couplers_to_auto_rs_w_BID : STD_LOGIC_VECTOR ( 1 downto 0 );
  signal m00_couplers_to_auto_rs_w_BREADY : STD_LOGIC;
  signal m00_couplers_to_auto_rs_w_BRESP : STD_LOGIC_VECTOR ( 1 downto 0 );
  signal m00_couplers_to_auto_rs_w_BVALID : STD_LOGIC;
  signal m00_couplers_to_auto_rs_w_RDATA : STD_LOGIC_VECTOR ( 255 downto 0 );
  signal m00_couplers_to_auto_rs_w_RID : STD_LOGIC_VECTOR ( 1 downto 0 );
  signal m00_couplers_to_auto_rs_w_RLAST : STD_LOGIC;
  signal m00_couplers_to_auto_rs_w_RREADY : STD_LOGIC;
  signal m00_couplers_to_auto_rs_w_RRESP : STD_LOGIC_VECTOR ( 1 downto 0 );
  signal m00_couplers_to_auto_rs_w_RVALID : STD_LOGIC;
  signal m00_couplers_to_auto_rs_w_WDATA : STD_LOGIC_VECTOR ( 255 downto 0 );
  signal m00_couplers_to_auto_rs_w_WLAST : STD_LOGIC;
  signal m00_couplers_to_auto_rs_w_WREADY : STD_LOGIC;
  signal m00_couplers_to_auto_rs_w_WSTRB : STD_LOGIC_VECTOR ( 31 downto 0 );
  signal m00_couplers_to_auto_rs_w_WVALID : STD_LOGIC;
  signal m00_regslice_to_m00_couplers_ARADDR : STD_LOGIC_VECTOR ( 28 downto 0 );
  signal m00_regslice_to_m00_couplers_ARBURST : STD_LOGIC_VECTOR ( 1 downto 0 );
  signal m00_regslice_to_m00_couplers_ARCACHE : STD_LOGIC_VECTOR ( 3 downto 0 );
  signal m00_regslice_to_m00_couplers_ARLEN : STD_LOGIC_VECTOR ( 7 downto 0 );
  signal m00_regslice_to_m00_couplers_ARLOCK : STD_LOGIC_VECTOR ( 0 to 0 );
  signal m00_regslice_to_m00_couplers_ARPROT : STD_LOGIC_VECTOR ( 2 downto 0 );
  signal m00_regslice_to_m00_couplers_ARQOS : STD_LOGIC_VECTOR ( 3 downto 0 );
  signal m00_regslice_to_m00_couplers_ARREADY : STD_LOGIC;
  signal m00_regslice_to_m00_couplers_ARSIZE : STD_LOGIC_VECTOR ( 2 downto 0 );
  signal m00_regslice_to_m00_couplers_ARVALID : STD_LOGIC;
  signal m00_regslice_to_m00_couplers_AWADDR : STD_LOGIC_VECTOR ( 28 downto 0 );
  signal m00_regslice_to_m00_couplers_AWBURST : STD_LOGIC_VECTOR ( 1 downto 0 );
  signal m00_regslice_to_m00_couplers_AWCACHE : STD_LOGIC_VECTOR ( 3 downto 0 );
  signal m00_regslice_to_m00_couplers_AWLEN : STD_LOGIC_VECTOR ( 7 downto 0 );
  signal m00_regslice_to_m00_couplers_AWLOCK : STD_LOGIC_VECTOR ( 0 to 0 );
  signal m00_regslice_to_m00_couplers_AWPROT : STD_LOGIC_VECTOR ( 2 downto 0 );
  signal m00_regslice_to_m00_couplers_AWQOS : STD_LOGIC_VECTOR ( 3 downto 0 );
  signal m00_regslice_to_m00_couplers_AWREADY : STD_LOGIC;
  signal m00_regslice_to_m00_couplers_AWSIZE : STD_LOGIC_VECTOR ( 2 downto 0 );
  signal m00_regslice_to_m00_couplers_AWVALID : STD_LOGIC;
  signal m00_regslice_to_m00_couplers_BREADY : STD_LOGIC;
  signal m00_regslice_to_m00_couplers_BRESP : STD_LOGIC_VECTOR ( 1 downto 0 );
  signal m00_regslice_to_m00_couplers_BVALID : STD_LOGIC;
  signal m00_regslice_to_m00_couplers_RDATA : STD_LOGIC_VECTOR ( 127 downto 0 );
  signal m00_regslice_to_m00_couplers_RLAST : STD_LOGIC;
  signal m00_regslice_to_m00_couplers_RREADY : STD_LOGIC;
  signal m00_regslice_to_m00_couplers_RRESP : STD_LOGIC_VECTOR ( 1 downto 0 );
  signal m00_regslice_to_m00_couplers_RVALID : STD_LOGIC;
  signal m00_regslice_to_m00_couplers_WDATA : STD_LOGIC_VECTOR ( 127 downto 0 );
  signal m00_regslice_to_m00_couplers_WLAST : STD_LOGIC;
  signal m00_regslice_to_m00_couplers_WREADY : STD_LOGIC;
  signal m00_regslice_to_m00_couplers_WSTRB : STD_LOGIC_VECTOR ( 15 downto 0 );
  signal m00_regslice_to_m00_couplers_WVALID : STD_LOGIC;
  signal NLW_m00_regslice_m_axi_arregion_UNCONNECTED : STD_LOGIC_VECTOR ( 3 downto 0 );
  signal NLW_m00_regslice_m_axi_awregion_UNCONNECTED : STD_LOGIC_VECTOR ( 3 downto 0 );
begin
  M_ACLK_1 <= M_ACLK;
  M_ARESETN_1 <= M_ARESETN;
  M_AXI_araddr(28 downto 0) <= m00_regslice_to_m00_couplers_ARADDR(28 downto 0);
  M_AXI_arburst(1 downto 0) <= m00_regslice_to_m00_couplers_ARBURST(1 downto 0);
  M_AXI_arcache(3 downto 0) <= m00_regslice_to_m00_couplers_ARCACHE(3 downto 0);
  M_AXI_arlen(7 downto 0) <= m00_regslice_to_m00_couplers_ARLEN(7 downto 0);
  M_AXI_arlock <= m00_regslice_to_m00_couplers_ARLOCK(0);
  M_AXI_arprot(2 downto 0) <= m00_regslice_to_m00_couplers_ARPROT(2 downto 0);
  M_AXI_arqos(3 downto 0) <= m00_regslice_to_m00_couplers_ARQOS(3 downto 0);
  M_AXI_arsize(2 downto 0) <= m00_regslice_to_m00_couplers_ARSIZE(2 downto 0);
  M_AXI_arvalid <= m00_regslice_to_m00_couplers_ARVALID;
  M_AXI_awaddr(28 downto 0) <= m00_regslice_to_m00_couplers_AWADDR(28 downto 0);
  M_AXI_awburst(1 downto 0) <= m00_regslice_to_m00_couplers_AWBURST(1 downto 0);
  M_AXI_awcache(3 downto 0) <= m00_regslice_to_m00_couplers_AWCACHE(3 downto 0);
  M_AXI_awlen(7 downto 0) <= m00_regslice_to_m00_couplers_AWLEN(7 downto 0);
  M_AXI_awlock <= m00_regslice_to_m00_couplers_AWLOCK(0);
  M_AXI_awprot(2 downto 0) <= m00_regslice_to_m00_couplers_AWPROT(2 downto 0);
  M_AXI_awqos(3 downto 0) <= m00_regslice_to_m00_couplers_AWQOS(3 downto 0);
  M_AXI_awsize(2 downto 0) <= m00_regslice_to_m00_couplers_AWSIZE(2 downto 0);
  M_AXI_awvalid <= m00_regslice_to_m00_couplers_AWVALID;
  M_AXI_bready <= m00_regslice_to_m00_couplers_BREADY;
  M_AXI_rready <= m00_regslice_to_m00_couplers_RREADY;
  M_AXI_wdata(127 downto 0) <= m00_regslice_to_m00_couplers_WDATA(127 downto 0);
  M_AXI_wlast <= m00_regslice_to_m00_couplers_WLAST;
  M_AXI_wstrb(15 downto 0) <= m00_regslice_to_m00_couplers_WSTRB(15 downto 0);
  M_AXI_wvalid <= m00_regslice_to_m00_couplers_WVALID;
  S_ACLK_1 <= S_ACLK;
  S_ARESETN_1 <= S_ARESETN;
  S_AXI_arready <= m00_couplers_to_auto_rs_w_ARREADY;
  S_AXI_awready <= m00_couplers_to_auto_rs_w_AWREADY;
  S_AXI_bid(1 downto 0) <= m00_couplers_to_auto_rs_w_BID(1 downto 0);
  S_AXI_bresp(1 downto 0) <= m00_couplers_to_auto_rs_w_BRESP(1 downto 0);
  S_AXI_bvalid <= m00_couplers_to_auto_rs_w_BVALID;
  S_AXI_rdata(255 downto 0) <= m00_couplers_to_auto_rs_w_RDATA(255 downto 0);
  S_AXI_rid(1 downto 0) <= m00_couplers_to_auto_rs_w_RID(1 downto 0);
  S_AXI_rlast <= m00_couplers_to_auto_rs_w_RLAST;
  S_AXI_rresp(1 downto 0) <= m00_couplers_to_auto_rs_w_RRESP(1 downto 0);
  S_AXI_rvalid <= m00_couplers_to_auto_rs_w_RVALID;
  S_AXI_wready <= m00_couplers_to_auto_rs_w_WREADY;
  m00_couplers_to_auto_rs_w_ARADDR(31 downto 0) <= S_AXI_araddr(31 downto 0);
  m00_couplers_to_auto_rs_w_ARBURST(1 downto 0) <= S_AXI_arburst(1 downto 0);
  m00_couplers_to_auto_rs_w_ARCACHE(3 downto 0) <= S_AXI_arcache(3 downto 0);
  m00_couplers_to_auto_rs_w_ARID(1 downto 0) <= S_AXI_arid(1 downto 0);
  m00_couplers_to_auto_rs_w_ARLEN(7 downto 0) <= S_AXI_arlen(7 downto 0);
  m00_couplers_to_auto_rs_w_ARLOCK(0) <= S_AXI_arlock(0);
  m00_couplers_to_auto_rs_w_ARPROT(2 downto 0) <= S_AXI_arprot(2 downto 0);
  m00_couplers_to_auto_rs_w_ARQOS(3 downto 0) <= S_AXI_arqos(3 downto 0);
  m00_couplers_to_auto_rs_w_ARREGION(3 downto 0) <= S_AXI_arregion(3 downto 0);
  m00_couplers_to_auto_rs_w_ARSIZE(2 downto 0) <= S_AXI_arsize(2 downto 0);
  m00_couplers_to_auto_rs_w_ARVALID <= S_AXI_arvalid;
  m00_couplers_to_auto_rs_w_AWADDR(31 downto 0) <= S_AXI_awaddr(31 downto 0);
  m00_couplers_to_auto_rs_w_AWBURST(1 downto 0) <= S_AXI_awburst(1 downto 0);
  m00_couplers_to_auto_rs_w_AWCACHE(3 downto 0) <= S_AXI_awcache(3 downto 0);
  m00_couplers_to_auto_rs_w_AWID(1 downto 0) <= S_AXI_awid(1 downto 0);
  m00_couplers_to_auto_rs_w_AWLEN(7 downto 0) <= S_AXI_awlen(7 downto 0);
  m00_couplers_to_auto_rs_w_AWLOCK(0) <= S_AXI_awlock(0);
  m00_couplers_to_auto_rs_w_AWPROT(2 downto 0) <= S_AXI_awprot(2 downto 0);
  m00_couplers_to_auto_rs_w_AWQOS(3 downto 0) <= S_AXI_awqos(3 downto 0);
  m00_couplers_to_auto_rs_w_AWREGION(3 downto 0) <= S_AXI_awregion(3 downto 0);
  m00_couplers_to_auto_rs_w_AWSIZE(2 downto 0) <= S_AXI_awsize(2 downto 0);
  m00_couplers_to_auto_rs_w_AWVALID <= S_AXI_awvalid;
  m00_couplers_to_auto_rs_w_BREADY <= S_AXI_bready;
  m00_couplers_to_auto_rs_w_RREADY <= S_AXI_rready;
  m00_couplers_to_auto_rs_w_WDATA(255 downto 0) <= S_AXI_wdata(255 downto 0);
  m00_couplers_to_auto_rs_w_WLAST <= S_AXI_wlast;
  m00_couplers_to_auto_rs_w_WSTRB(31 downto 0) <= S_AXI_wstrb(31 downto 0);
  m00_couplers_to_auto_rs_w_WVALID <= S_AXI_wvalid;
  m00_regslice_to_m00_couplers_ARREADY <= M_AXI_arready;
  m00_regslice_to_m00_couplers_AWREADY <= M_AXI_awready;
  m00_regslice_to_m00_couplers_BRESP(1 downto 0) <= M_AXI_bresp(1 downto 0);
  m00_regslice_to_m00_couplers_BVALID <= M_AXI_bvalid;
  m00_regslice_to_m00_couplers_RDATA(127 downto 0) <= M_AXI_rdata(127 downto 0);
  m00_regslice_to_m00_couplers_RLAST <= M_AXI_rlast;
  m00_regslice_to_m00_couplers_RRESP(1 downto 0) <= M_AXI_rresp(1 downto 0);
  m00_regslice_to_m00_couplers_RVALID <= M_AXI_rvalid;
  m00_regslice_to_m00_couplers_WREADY <= M_AXI_wready;
auto_ds: component hdmi_auto_ds_0
     port map (
      m_axi_araddr(28 downto 0) => auto_ds_to_m00_regslice_ARADDR(28 downto 0),
      m_axi_arburst(1 downto 0) => auto_ds_to_m00_regslice_ARBURST(1 downto 0),
      m_axi_arcache(3 downto 0) => auto_ds_to_m00_regslice_ARCACHE(3 downto 0),
      m_axi_arlen(7 downto 0) => auto_ds_to_m00_regslice_ARLEN(7 downto 0),
      m_axi_arlock(0) => auto_ds_to_m00_regslice_ARLOCK(0),
      m_axi_arprot(2 downto 0) => auto_ds_to_m00_regslice_ARPROT(2 downto 0),
      m_axi_arqos(3 downto 0) => auto_ds_to_m00_regslice_ARQOS(3 downto 0),
      m_axi_arready => auto_ds_to_m00_regslice_ARREADY,
      m_axi_arregion(3 downto 0) => auto_ds_to_m00_regslice_ARREGION(3 downto 0),
      m_axi_arsize(2 downto 0) => auto_ds_to_m00_regslice_ARSIZE(2 downto 0),
      m_axi_arvalid => auto_ds_to_m00_regslice_ARVALID,
      m_axi_awaddr(28 downto 0) => auto_ds_to_m00_regslice_AWADDR(28 downto 0),
      m_axi_awburst(1 downto 0) => auto_ds_to_m00_regslice_AWBURST(1 downto 0),
      m_axi_awcache(3 downto 0) => auto_ds_to_m00_regslice_AWCACHE(3 downto 0),
      m_axi_awlen(7 downto 0) => auto_ds_to_m00_regslice_AWLEN(7 downto 0),
      m_axi_awlock(0) => auto_ds_to_m00_regslice_AWLOCK(0),
      m_axi_awprot(2 downto 0) => auto_ds_to_m00_regslice_AWPROT(2 downto 0),
      m_axi_awqos(3 downto 0) => auto_ds_to_m00_regslice_AWQOS(3 downto 0),
      m_axi_awready => auto_ds_to_m00_regslice_AWREADY,
      m_axi_awregion(3 downto 0) => auto_ds_to_m00_regslice_AWREGION(3 downto 0),
      m_axi_awsize(2 downto 0) => auto_ds_to_m00_regslice_AWSIZE(2 downto 0),
      m_axi_awvalid => auto_ds_to_m00_regslice_AWVALID,
      m_axi_bready => auto_ds_to_m00_regslice_BREADY,
      m_axi_bresp(1 downto 0) => auto_ds_to_m00_regslice_BRESP(1 downto 0),
      m_axi_bvalid => auto_ds_to_m00_regslice_BVALID,
      m_axi_rdata(127 downto 0) => auto_ds_to_m00_regslice_RDATA(127 downto 0),
      m_axi_rlast => auto_ds_to_m00_regslice_RLAST,
      m_axi_rready => auto_ds_to_m00_regslice_RREADY,
      m_axi_rresp(1 downto 0) => auto_ds_to_m00_regslice_RRESP(1 downto 0),
      m_axi_rvalid => auto_ds_to_m00_regslice_RVALID,
      m_axi_wdata(127 downto 0) => auto_ds_to_m00_regslice_WDATA(127 downto 0),
      m_axi_wlast => auto_ds_to_m00_regslice_WLAST,
      m_axi_wready => auto_ds_to_m00_regslice_WREADY,
      m_axi_wstrb(15 downto 0) => auto_ds_to_m00_regslice_WSTRB(15 downto 0),
      m_axi_wvalid => auto_ds_to_m00_regslice_WVALID,
      s_axi_aclk => S_ACLK_1,
      s_axi_araddr(28 downto 0) => auto_rs_w_to_auto_ds_ARADDR(28 downto 0),
      s_axi_arburst(1 downto 0) => auto_rs_w_to_auto_ds_ARBURST(1 downto 0),
      s_axi_arcache(3 downto 0) => auto_rs_w_to_auto_ds_ARCACHE(3 downto 0),
      s_axi_aresetn => S_ARESETN_1,
      s_axi_arid(1 downto 0) => auto_rs_w_to_auto_ds_ARID(1 downto 0),
      s_axi_arlen(7 downto 0) => auto_rs_w_to_auto_ds_ARLEN(7 downto 0),
      s_axi_arlock(0) => auto_rs_w_to_auto_ds_ARLOCK(0),
      s_axi_arprot(2 downto 0) => auto_rs_w_to_auto_ds_ARPROT(2 downto 0),
      s_axi_arqos(3 downto 0) => auto_rs_w_to_auto_ds_ARQOS(3 downto 0),
      s_axi_arready => auto_rs_w_to_auto_ds_ARREADY,
      s_axi_arregion(3 downto 0) => auto_rs_w_to_auto_ds_ARREGION(3 downto 0),
      s_axi_arsize(2 downto 0) => auto_rs_w_to_auto_ds_ARSIZE(2 downto 0),
      s_axi_arvalid => auto_rs_w_to_auto_ds_ARVALID,
      s_axi_awaddr(28 downto 0) => auto_rs_w_to_auto_ds_AWADDR(28 downto 0),
      s_axi_awburst(1 downto 0) => auto_rs_w_to_auto_ds_AWBURST(1 downto 0),
      s_axi_awcache(3 downto 0) => auto_rs_w_to_auto_ds_AWCACHE(3 downto 0),
      s_axi_awid(1 downto 0) => auto_rs_w_to_auto_ds_AWID(1 downto 0),
      s_axi_awlen(7 downto 0) => auto_rs_w_to_auto_ds_AWLEN(7 downto 0),
      s_axi_awlock(0) => auto_rs_w_to_auto_ds_AWLOCK(0),
      s_axi_awprot(2 downto 0) => auto_rs_w_to_auto_ds_AWPROT(2 downto 0),
      s_axi_awqos(3 downto 0) => auto_rs_w_to_auto_ds_AWQOS(3 downto 0),
      s_axi_awready => auto_rs_w_to_auto_ds_AWREADY,
      s_axi_awregion(3 downto 0) => auto_rs_w_to_auto_ds_AWREGION(3 downto 0),
      s_axi_awsize(2 downto 0) => auto_rs_w_to_auto_ds_AWSIZE(2 downto 0),
      s_axi_awvalid => auto_rs_w_to_auto_ds_AWVALID,
      s_axi_bid(1 downto 0) => auto_rs_w_to_auto_ds_BID(1 downto 0),
      s_axi_bready => auto_rs_w_to_auto_ds_BREADY,
      s_axi_bresp(1 downto 0) => auto_rs_w_to_auto_ds_BRESP(1 downto 0),
      s_axi_bvalid => auto_rs_w_to_auto_ds_BVALID,
      s_axi_rdata(255 downto 0) => auto_rs_w_to_auto_ds_RDATA(255 downto 0),
      s_axi_rid(1 downto 0) => auto_rs_w_to_auto_ds_RID(1 downto 0),
      s_axi_rlast => auto_rs_w_to_auto_ds_RLAST,
      s_axi_rready => auto_rs_w_to_auto_ds_RREADY,
      s_axi_rresp(1 downto 0) => auto_rs_w_to_auto_ds_RRESP(1 downto 0),
      s_axi_rvalid => auto_rs_w_to_auto_ds_RVALID,
      s_axi_wdata(255 downto 0) => auto_rs_w_to_auto_ds_WDATA(255 downto 0),
      s_axi_wlast => auto_rs_w_to_auto_ds_WLAST,
      s_axi_wready => auto_rs_w_to_auto_ds_WREADY,
      s_axi_wstrb(31 downto 0) => auto_rs_w_to_auto_ds_WSTRB(31 downto 0),
      s_axi_wvalid => auto_rs_w_to_auto_ds_WVALID
    );
auto_rs_w: component hdmi_auto_rs_w_0
     port map (
      aclk => S_ACLK_1,
      aresetn => S_ARESETN_1,
      m_axi_araddr(28 downto 0) => auto_rs_w_to_auto_ds_ARADDR(28 downto 0),
      m_axi_arburst(1 downto 0) => auto_rs_w_to_auto_ds_ARBURST(1 downto 0),
      m_axi_arcache(3 downto 0) => auto_rs_w_to_auto_ds_ARCACHE(3 downto 0),
      m_axi_arid(1 downto 0) => auto_rs_w_to_auto_ds_ARID(1 downto 0),
      m_axi_arlen(7 downto 0) => auto_rs_w_to_auto_ds_ARLEN(7 downto 0),
      m_axi_arlock(0) => auto_rs_w_to_auto_ds_ARLOCK(0),
      m_axi_arprot(2 downto 0) => auto_rs_w_to_auto_ds_ARPROT(2 downto 0),
      m_axi_arqos(3 downto 0) => auto_rs_w_to_auto_ds_ARQOS(3 downto 0),
      m_axi_arready => auto_rs_w_to_auto_ds_ARREADY,
      m_axi_arregion(3 downto 0) => auto_rs_w_to_auto_ds_ARREGION(3 downto 0),
      m_axi_arsize(2 downto 0) => auto_rs_w_to_auto_ds_ARSIZE(2 downto 0),
      m_axi_arvalid => auto_rs_w_to_auto_ds_ARVALID,
      m_axi_awaddr(28 downto 0) => auto_rs_w_to_auto_ds_AWADDR(28 downto 0),
      m_axi_awburst(1 downto 0) => auto_rs_w_to_auto_ds_AWBURST(1 downto 0),
      m_axi_awcache(3 downto 0) => auto_rs_w_to_auto_ds_AWCACHE(3 downto 0),
      m_axi_awid(1 downto 0) => auto_rs_w_to_auto_ds_AWID(1 downto 0),
      m_axi_awlen(7 downto 0) => auto_rs_w_to_auto_ds_AWLEN(7 downto 0),
      m_axi_awlock(0) => auto_rs_w_to_auto_ds_AWLOCK(0),
      m_axi_awprot(2 downto 0) => auto_rs_w_to_auto_ds_AWPROT(2 downto 0),
      m_axi_awqos(3 downto 0) => auto_rs_w_to_auto_ds_AWQOS(3 downto 0),
      m_axi_awready => auto_rs_w_to_auto_ds_AWREADY,
      m_axi_awregion(3 downto 0) => auto_rs_w_to_auto_ds_AWREGION(3 downto 0),
      m_axi_awsize(2 downto 0) => auto_rs_w_to_auto_ds_AWSIZE(2 downto 0),
      m_axi_awvalid => auto_rs_w_to_auto_ds_AWVALID,
      m_axi_bid(1 downto 0) => auto_rs_w_to_auto_ds_BID(1 downto 0),
      m_axi_bready => auto_rs_w_to_auto_ds_BREADY,
      m_axi_bresp(1 downto 0) => auto_rs_w_to_auto_ds_BRESP(1 downto 0),
      m_axi_bvalid => auto_rs_w_to_auto_ds_BVALID,
      m_axi_rdata(255 downto 0) => auto_rs_w_to_auto_ds_RDATA(255 downto 0),
      m_axi_rid(1 downto 0) => auto_rs_w_to_auto_ds_RID(1 downto 0),
      m_axi_rlast => auto_rs_w_to_auto_ds_RLAST,
      m_axi_rready => auto_rs_w_to_auto_ds_RREADY,
      m_axi_rresp(1 downto 0) => auto_rs_w_to_auto_ds_RRESP(1 downto 0),
      m_axi_rvalid => auto_rs_w_to_auto_ds_RVALID,
      m_axi_wdata(255 downto 0) => auto_rs_w_to_auto_ds_WDATA(255 downto 0),
      m_axi_wlast => auto_rs_w_to_auto_ds_WLAST,
      m_axi_wready => auto_rs_w_to_auto_ds_WREADY,
      m_axi_wstrb(31 downto 0) => auto_rs_w_to_auto_ds_WSTRB(31 downto 0),
      m_axi_wvalid => auto_rs_w_to_auto_ds_WVALID,
      s_axi_araddr(28 downto 0) => m00_couplers_to_auto_rs_w_ARADDR(28 downto 0),
      s_axi_arburst(1 downto 0) => m00_couplers_to_auto_rs_w_ARBURST(1 downto 0),
      s_axi_arcache(3 downto 0) => m00_couplers_to_auto_rs_w_ARCACHE(3 downto 0),
      s_axi_arid(1 downto 0) => m00_couplers_to_auto_rs_w_ARID(1 downto 0),
      s_axi_arlen(7 downto 0) => m00_couplers_to_auto_rs_w_ARLEN(7 downto 0),
      s_axi_arlock(0) => m00_couplers_to_auto_rs_w_ARLOCK(0),
      s_axi_arprot(2 downto 0) => m00_couplers_to_auto_rs_w_ARPROT(2 downto 0),
      s_axi_arqos(3 downto 0) => m00_couplers_to_auto_rs_w_ARQOS(3 downto 0),
      s_axi_arready => m00_couplers_to_auto_rs_w_ARREADY,
      s_axi_arregion(3 downto 0) => m00_couplers_to_auto_rs_w_ARREGION(3 downto 0),
      s_axi_arsize(2 downto 0) => m00_couplers_to_auto_rs_w_ARSIZE(2 downto 0),
      s_axi_arvalid => m00_couplers_to_auto_rs_w_ARVALID,
      s_axi_awaddr(28 downto 0) => m00_couplers_to_auto_rs_w_AWADDR(28 downto 0),
      s_axi_awburst(1 downto 0) => m00_couplers_to_auto_rs_w_AWBURST(1 downto 0),
      s_axi_awcache(3 downto 0) => m00_couplers_to_auto_rs_w_AWCACHE(3 downto 0),
      s_axi_awid(1 downto 0) => m00_couplers_to_auto_rs_w_AWID(1 downto 0),
      s_axi_awlen(7 downto 0) => m00_couplers_to_auto_rs_w_AWLEN(7 downto 0),
      s_axi_awlock(0) => m00_couplers_to_auto_rs_w_AWLOCK(0),
      s_axi_awprot(2 downto 0) => m00_couplers_to_auto_rs_w_AWPROT(2 downto 0),
      s_axi_awqos(3 downto 0) => m00_couplers_to_auto_rs_w_AWQOS(3 downto 0),
      s_axi_awready => m00_couplers_to_auto_rs_w_AWREADY,
      s_axi_awregion(3 downto 0) => m00_couplers_to_auto_rs_w_AWREGION(3 downto 0),
      s_axi_awsize(2 downto 0) => m00_couplers_to_auto_rs_w_AWSIZE(2 downto 0),
      s_axi_awvalid => m00_couplers_to_auto_rs_w_AWVALID,
      s_axi_bid(1 downto 0) => m00_couplers_to_auto_rs_w_BID(1 downto 0),
      s_axi_bready => m00_couplers_to_auto_rs_w_BREADY,
      s_axi_bresp(1 downto 0) => m00_couplers_to_auto_rs_w_BRESP(1 downto 0),
      s_axi_bvalid => m00_couplers_to_auto_rs_w_BVALID,
      s_axi_rdata(255 downto 0) => m00_couplers_to_auto_rs_w_RDATA(255 downto 0),
      s_axi_rid(1 downto 0) => m00_couplers_to_auto_rs_w_RID(1 downto 0),
      s_axi_rlast => m00_couplers_to_auto_rs_w_RLAST,
      s_axi_rready => m00_couplers_to_auto_rs_w_RREADY,
      s_axi_rresp(1 downto 0) => m00_couplers_to_auto_rs_w_RRESP(1 downto 0),
      s_axi_rvalid => m00_couplers_to_auto_rs_w_RVALID,
      s_axi_wdata(255 downto 0) => m00_couplers_to_auto_rs_w_WDATA(255 downto 0),
      s_axi_wlast => m00_couplers_to_auto_rs_w_WLAST,
      s_axi_wready => m00_couplers_to_auto_rs_w_WREADY,
      s_axi_wstrb(31 downto 0) => m00_couplers_to_auto_rs_w_WSTRB(31 downto 0),
      s_axi_wvalid => m00_couplers_to_auto_rs_w_WVALID
    );
m00_regslice: component hdmi_m00_regslice_0
     port map (
      aclk => M_ACLK_1,
      aresetn => M_ARESETN_1,
      m_axi_araddr(28 downto 0) => m00_regslice_to_m00_couplers_ARADDR(28 downto 0),
      m_axi_arburst(1 downto 0) => m00_regslice_to_m00_couplers_ARBURST(1 downto 0),
      m_axi_arcache(3 downto 0) => m00_regslice_to_m00_couplers_ARCACHE(3 downto 0),
      m_axi_arlen(7 downto 0) => m00_regslice_to_m00_couplers_ARLEN(7 downto 0),
      m_axi_arlock(0) => m00_regslice_to_m00_couplers_ARLOCK(0),
      m_axi_arprot(2 downto 0) => m00_regslice_to_m00_couplers_ARPROT(2 downto 0),
      m_axi_arqos(3 downto 0) => m00_regslice_to_m00_couplers_ARQOS(3 downto 0),
      m_axi_arready => m00_regslice_to_m00_couplers_ARREADY,
      m_axi_arregion(3 downto 0) => NLW_m00_regslice_m_axi_arregion_UNCONNECTED(3 downto 0),
      m_axi_arsize(2 downto 0) => m00_regslice_to_m00_couplers_ARSIZE(2 downto 0),
      m_axi_arvalid => m00_regslice_to_m00_couplers_ARVALID,
      m_axi_awaddr(28 downto 0) => m00_regslice_to_m00_couplers_AWADDR(28 downto 0),
      m_axi_awburst(1 downto 0) => m00_regslice_to_m00_couplers_AWBURST(1 downto 0),
      m_axi_awcache(3 downto 0) => m00_regslice_to_m00_couplers_AWCACHE(3 downto 0),
      m_axi_awlen(7 downto 0) => m00_regslice_to_m00_couplers_AWLEN(7 downto 0),
      m_axi_awlock(0) => m00_regslice_to_m00_couplers_AWLOCK(0),
      m_axi_awprot(2 downto 0) => m00_regslice_to_m00_couplers_AWPROT(2 downto 0),
      m_axi_awqos(3 downto 0) => m00_regslice_to_m00_couplers_AWQOS(3 downto 0),
      m_axi_awready => m00_regslice_to_m00_couplers_AWREADY,
      m_axi_awregion(3 downto 0) => NLW_m00_regslice_m_axi_awregion_UNCONNECTED(3 downto 0),
      m_axi_awsize(2 downto 0) => m00_regslice_to_m00_couplers_AWSIZE(2 downto 0),
      m_axi_awvalid => m00_regslice_to_m00_couplers_AWVALID,
      m_axi_bready => m00_regslice_to_m00_couplers_BREADY,
      m_axi_bresp(1 downto 0) => m00_regslice_to_m00_couplers_BRESP(1 downto 0),
      m_axi_bvalid => m00_regslice_to_m00_couplers_BVALID,
      m_axi_rdata(127 downto 0) => m00_regslice_to_m00_couplers_RDATA(127 downto 0),
      m_axi_rlast => m00_regslice_to_m00_couplers_RLAST,
      m_axi_rready => m00_regslice_to_m00_couplers_RREADY,
      m_axi_rresp(1 downto 0) => m00_regslice_to_m00_couplers_RRESP(1 downto 0),
      m_axi_rvalid => m00_regslice_to_m00_couplers_RVALID,
      m_axi_wdata(127 downto 0) => m00_regslice_to_m00_couplers_WDATA(127 downto 0),
      m_axi_wlast => m00_regslice_to_m00_couplers_WLAST,
      m_axi_wready => m00_regslice_to_m00_couplers_WREADY,
      m_axi_wstrb(15 downto 0) => m00_regslice_to_m00_couplers_WSTRB(15 downto 0),
      m_axi_wvalid => m00_regslice_to_m00_couplers_WVALID,
      s_axi_araddr(28 downto 0) => auto_ds_to_m00_regslice_ARADDR(28 downto 0),
      s_axi_arburst(1 downto 0) => auto_ds_to_m00_regslice_ARBURST(1 downto 0),
      s_axi_arcache(3 downto 0) => auto_ds_to_m00_regslice_ARCACHE(3 downto 0),
      s_axi_arlen(7 downto 0) => auto_ds_to_m00_regslice_ARLEN(7 downto 0),
      s_axi_arlock(0) => auto_ds_to_m00_regslice_ARLOCK(0),
      s_axi_arprot(2 downto 0) => auto_ds_to_m00_regslice_ARPROT(2 downto 0),
      s_axi_arqos(3 downto 0) => auto_ds_to_m00_regslice_ARQOS(3 downto 0),
      s_axi_arready => auto_ds_to_m00_regslice_ARREADY,
      s_axi_arregion(3 downto 0) => auto_ds_to_m00_regslice_ARREGION(3 downto 0),
      s_axi_arsize(2 downto 0) => auto_ds_to_m00_regslice_ARSIZE(2 downto 0),
      s_axi_arvalid => auto_ds_to_m00_regslice_ARVALID,
      s_axi_awaddr(28 downto 0) => auto_ds_to_m00_regslice_AWADDR(28 downto 0),
      s_axi_awburst(1 downto 0) => auto_ds_to_m00_regslice_AWBURST(1 downto 0),
      s_axi_awcache(3 downto 0) => auto_ds_to_m00_regslice_AWCACHE(3 downto 0),
      s_axi_awlen(7 downto 0) => auto_ds_to_m00_regslice_AWLEN(7 downto 0),
      s_axi_awlock(0) => auto_ds_to_m00_regslice_AWLOCK(0),
      s_axi_awprot(2 downto 0) => auto_ds_to_m00_regslice_AWPROT(2 downto 0),
      s_axi_awqos(3 downto 0) => auto_ds_to_m00_regslice_AWQOS(3 downto 0),
      s_axi_awready => auto_ds_to_m00_regslice_AWREADY,
      s_axi_awregion(3 downto 0) => auto_ds_to_m00_regslice_AWREGION(3 downto 0),
      s_axi_awsize(2 downto 0) => auto_ds_to_m00_regslice_AWSIZE(2 downto 0),
      s_axi_awvalid => auto_ds_to_m00_regslice_AWVALID,
      s_axi_bready => auto_ds_to_m00_regslice_BREADY,
      s_axi_bresp(1 downto 0) => auto_ds_to_m00_regslice_BRESP(1 downto 0),
      s_axi_bvalid => auto_ds_to_m00_regslice_BVALID,
      s_axi_rdata(127 downto 0) => auto_ds_to_m00_regslice_RDATA(127 downto 0),
      s_axi_rlast => auto_ds_to_m00_regslice_RLAST,
      s_axi_rready => auto_ds_to_m00_regslice_RREADY,
      s_axi_rresp(1 downto 0) => auto_ds_to_m00_regslice_RRESP(1 downto 0),
      s_axi_rvalid => auto_ds_to_m00_regslice_RVALID,
      s_axi_wdata(127 downto 0) => auto_ds_to_m00_regslice_WDATA(127 downto 0),
      s_axi_wlast => auto_ds_to_m00_regslice_WLAST,
      s_axi_wready => auto_ds_to_m00_regslice_WREADY,
      s_axi_wstrb(15 downto 0) => auto_ds_to_m00_regslice_WSTRB(15 downto 0),
      s_axi_wvalid => auto_ds_to_m00_regslice_WVALID
    );
end STRUCTURE;
library IEEE;
use IEEE.STD_LOGIC_1164.ALL;
library UNISIM;
use UNISIM.VCOMPONENTS.ALL;
entity m01_couplers_imp_PTW8HY is
  port (
    M_ACLK : in STD_LOGIC;
    M_ARESETN : in STD_LOGIC;
    M_AXI_araddr : out STD_LOGIC_VECTOR ( 31 downto 0 );
    M_AXI_arready : in STD_LOGIC_VECTOR ( 0 to 0 );
    M_AXI_arvalid : out STD_LOGIC_VECTOR ( 0 to 0 );
    M_AXI_awaddr : out STD_LOGIC_VECTOR ( 31 downto 0 );
    M_AXI_awready : in STD_LOGIC_VECTOR ( 0 to 0 );
    M_AXI_awvalid : out STD_LOGIC_VECTOR ( 0 to 0 );
    M_AXI_bready : out STD_LOGIC_VECTOR ( 0 to 0 );
    M_AXI_bresp : in STD_LOGIC_VECTOR ( 1 downto 0 );
    M_AXI_bvalid : in STD_LOGIC_VECTOR ( 0 to 0 );
    M_AXI_rdata : in STD_LOGIC_VECTOR ( 31 downto 0 );
    M_AXI_rready : out STD_LOGIC_VECTOR ( 0 to 0 );
    M_AXI_rresp : in STD_LOGIC_VECTOR ( 1 downto 0 );
    M_AXI_rvalid : in STD_LOGIC_VECTOR ( 0 to 0 );
    M_AXI_wdata : out STD_LOGIC_VECTOR ( 31 downto 0 );
    M_AXI_wready : in STD_LOGIC_VECTOR ( 0 to 0 );
    M_AXI_wvalid : out STD_LOGIC_VECTOR ( 0 to 0 );
    S_ACLK : in STD_LOGIC;
    S_ARESETN : in STD_LOGIC;
    S_AXI_araddr : in STD_LOGIC_VECTOR ( 31 downto 0 );
    S_AXI_arready : out STD_LOGIC_VECTOR ( 0 to 0 );
    S_AXI_arvalid : in STD_LOGIC_VECTOR ( 0 to 0 );
    S_AXI_awaddr : in STD_LOGIC_VECTOR ( 31 downto 0 );
    S_AXI_awready : out STD_LOGIC_VECTOR ( 0 to 0 );
    S_AXI_awvalid : in STD_LOGIC_VECTOR ( 0 to 0 );
    S_AXI_bready : in STD_LOGIC_VECTOR ( 0 to 0 );
    S_AXI_bresp : out STD_LOGIC_VECTOR ( 1 downto 0 );
    S_AXI_bvalid : out STD_LOGIC_VECTOR ( 0 to 0 );
    S_AXI_rdata : out STD_LOGIC_VECTOR ( 31 downto 0 );
    S_AXI_rready : in STD_LOGIC_VECTOR ( 0 to 0 );
    S_AXI_rresp : out STD_LOGIC_VECTOR ( 1 downto 0 );
    S_AXI_rvalid : out STD_LOGIC_VECTOR ( 0 to 0 );
    S_AXI_wdata : in STD_LOGIC_VECTOR ( 31 downto 0 );
    S_AXI_wready : out STD_LOGIC_VECTOR ( 0 to 0 );
    S_AXI_wvalid : in STD_LOGIC_VECTOR ( 0 to 0 )
  );
end m01_couplers_imp_PTW8HY;

architecture STRUCTURE of m01_couplers_imp_PTW8HY is
  signal m01_couplers_to_m01_couplers_ARADDR : STD_LOGIC_VECTOR ( 31 downto 0 );
  signal m01_couplers_to_m01_couplers_ARREADY : STD_LOGIC_VECTOR ( 0 to 0 );
  signal m01_couplers_to_m01_couplers_ARVALID : STD_LOGIC_VECTOR ( 0 to 0 );
  signal m01_couplers_to_m01_couplers_AWADDR : STD_LOGIC_VECTOR ( 31 downto 0 );
  signal m01_couplers_to_m01_couplers_AWREADY : STD_LOGIC_VECTOR ( 0 to 0 );
  signal m01_couplers_to_m01_couplers_AWVALID : STD_LOGIC_VECTOR ( 0 to 0 );
  signal m01_couplers_to_m01_couplers_BREADY : STD_LOGIC_VECTOR ( 0 to 0 );
  signal m01_couplers_to_m01_couplers_BRESP : STD_LOGIC_VECTOR ( 1 downto 0 );
  signal m01_couplers_to_m01_couplers_BVALID : STD_LOGIC_VECTOR ( 0 to 0 );
  signal m01_couplers_to_m01_couplers_RDATA : STD_LOGIC_VECTOR ( 31 downto 0 );
  signal m01_couplers_to_m01_couplers_RREADY : STD_LOGIC_VECTOR ( 0 to 0 );
  signal m01_couplers_to_m01_couplers_RRESP : STD_LOGIC_VECTOR ( 1 downto 0 );
  signal m01_couplers_to_m01_couplers_RVALID : STD_LOGIC_VECTOR ( 0 to 0 );
  signal m01_couplers_to_m01_couplers_WDATA : STD_LOGIC_VECTOR ( 31 downto 0 );
  signal m01_couplers_to_m01_couplers_WREADY : STD_LOGIC_VECTOR ( 0 to 0 );
  signal m01_couplers_to_m01_couplers_WVALID : STD_LOGIC_VECTOR ( 0 to 0 );
begin
  M_AXI_araddr(31 downto 0) <= m01_couplers_to_m01_couplers_ARADDR(31 downto 0);
  M_AXI_arvalid(0) <= m01_couplers_to_m01_couplers_ARVALID(0);
  M_AXI_awaddr(31 downto 0) <= m01_couplers_to_m01_couplers_AWADDR(31 downto 0);
  M_AXI_awvalid(0) <= m01_couplers_to_m01_couplers_AWVALID(0);
  M_AXI_bready(0) <= m01_couplers_to_m01_couplers_BREADY(0);
  M_AXI_rready(0) <= m01_couplers_to_m01_couplers_RREADY(0);
  M_AXI_wdata(31 downto 0) <= m01_couplers_to_m01_couplers_WDATA(31 downto 0);
  M_AXI_wvalid(0) <= m01_couplers_to_m01_couplers_WVALID(0);
  S_AXI_arready(0) <= m01_couplers_to_m01_couplers_ARREADY(0);
  S_AXI_awready(0) <= m01_couplers_to_m01_couplers_AWREADY(0);
  S_AXI_bresp(1 downto 0) <= m01_couplers_to_m01_couplers_BRESP(1 downto 0);
  S_AXI_bvalid(0) <= m01_couplers_to_m01_couplers_BVALID(0);
  S_AXI_rdata(31 downto 0) <= m01_couplers_to_m01_couplers_RDATA(31 downto 0);
  S_AXI_rresp(1 downto 0) <= m01_couplers_to_m01_couplers_RRESP(1 downto 0);
  S_AXI_rvalid(0) <= m01_couplers_to_m01_couplers_RVALID(0);
  S_AXI_wready(0) <= m01_couplers_to_m01_couplers_WREADY(0);
  m01_couplers_to_m01_couplers_ARADDR(31 downto 0) <= S_AXI_araddr(31 downto 0);
  m01_couplers_to_m01_couplers_ARREADY(0) <= M_AXI_arready(0);
  m01_couplers_to_m01_couplers_ARVALID(0) <= S_AXI_arvalid(0);
  m01_couplers_to_m01_couplers_AWADDR(31 downto 0) <= S_AXI_awaddr(31 downto 0);
  m01_couplers_to_m01_couplers_AWREADY(0) <= M_AXI_awready(0);
  m01_couplers_to_m01_couplers_AWVALID(0) <= S_AXI_awvalid(0);
  m01_couplers_to_m01_couplers_BREADY(0) <= S_AXI_bready(0);
  m01_couplers_to_m01_couplers_BRESP(1 downto 0) <= M_AXI_bresp(1 downto 0);
  m01_couplers_to_m01_couplers_BVALID(0) <= M_AXI_bvalid(0);
  m01_couplers_to_m01_couplers_RDATA(31 downto 0) <= M_AXI_rdata(31 downto 0);
  m01_couplers_to_m01_couplers_RREADY(0) <= S_AXI_rready(0);
  m01_couplers_to_m01_couplers_RRESP(1 downto 0) <= M_AXI_rresp(1 downto 0);
  m01_couplers_to_m01_couplers_RVALID(0) <= M_AXI_rvalid(0);
  m01_couplers_to_m01_couplers_WDATA(31 downto 0) <= S_AXI_wdata(31 downto 0);
  m01_couplers_to_m01_couplers_WREADY(0) <= M_AXI_wready(0);
  m01_couplers_to_m01_couplers_WVALID(0) <= S_AXI_wvalid(0);
end STRUCTURE;
library IEEE;
use IEEE.STD_LOGIC_1164.ALL;
library UNISIM;
use UNISIM.VCOMPONENTS.ALL;
entity m02_couplers_imp_9ACNVH is
  port (
    M_ACLK : in STD_LOGIC;
    M_ARESETN : in STD_LOGIC;
    M_AXI_araddr : out STD_LOGIC_VECTOR ( 31 downto 0 );
    M_AXI_arready : in STD_LOGIC_VECTOR ( 0 to 0 );
    M_AXI_arvalid : out STD_LOGIC_VECTOR ( 0 to 0 );
    M_AXI_awaddr : out STD_LOGIC_VECTOR ( 31 downto 0 );
    M_AXI_awready : in STD_LOGIC_VECTOR ( 0 to 0 );
    M_AXI_awvalid : out STD_LOGIC_VECTOR ( 0 to 0 );
    M_AXI_bready : out STD_LOGIC_VECTOR ( 0 to 0 );
    M_AXI_bresp : in STD_LOGIC_VECTOR ( 1 downto 0 );
    M_AXI_bvalid : in STD_LOGIC_VECTOR ( 0 to 0 );
    M_AXI_rdata : in STD_LOGIC_VECTOR ( 31 downto 0 );
    M_AXI_rready : out STD_LOGIC_VECTOR ( 0 to 0 );
    M_AXI_rresp : in STD_LOGIC_VECTOR ( 1 downto 0 );
    M_AXI_rvalid : in STD_LOGIC_VECTOR ( 0 to 0 );
    M_AXI_wdata : out STD_LOGIC_VECTOR ( 31 downto 0 );
    M_AXI_wready : in STD_LOGIC_VECTOR ( 0 to 0 );
    M_AXI_wstrb : out STD_LOGIC_VECTOR ( 3 downto 0 );
    M_AXI_wvalid : out STD_LOGIC_VECTOR ( 0 to 0 );
    S_ACLK : in STD_LOGIC;
    S_ARESETN : in STD_LOGIC;
    S_AXI_araddr : in STD_LOGIC_VECTOR ( 31 downto 0 );
    S_AXI_arready : out STD_LOGIC_VECTOR ( 0 to 0 );
    S_AXI_arvalid : in STD_LOGIC_VECTOR ( 0 to 0 );
    S_AXI_awaddr : in STD_LOGIC_VECTOR ( 31 downto 0 );
    S_AXI_awready : out STD_LOGIC_VECTOR ( 0 to 0 );
    S_AXI_awvalid : in STD_LOGIC_VECTOR ( 0 to 0 );
    S_AXI_bready : in STD_LOGIC_VECTOR ( 0 to 0 );
    S_AXI_bresp : out STD_LOGIC_VECTOR ( 1 downto 0 );
    S_AXI_bvalid : out STD_LOGIC_VECTOR ( 0 to 0 );
    S_AXI_rdata : out STD_LOGIC_VECTOR ( 31 downto 0 );
    S_AXI_rready : in STD_LOGIC_VECTOR ( 0 to 0 );
    S_AXI_rresp : out STD_LOGIC_VECTOR ( 1 downto 0 );
    S_AXI_rvalid : out STD_LOGIC_VECTOR ( 0 to 0 );
    S_AXI_wdata : in STD_LOGIC_VECTOR ( 31 downto 0 );
    S_AXI_wready : out STD_LOGIC_VECTOR ( 0 to 0 );
    S_AXI_wstrb : in STD_LOGIC_VECTOR ( 3 downto 0 );
    S_AXI_wvalid : in STD_LOGIC_VECTOR ( 0 to 0 )
  );
end m02_couplers_imp_9ACNVH;

architecture STRUCTURE of m02_couplers_imp_9ACNVH is
  signal m02_couplers_to_m02_couplers_ARADDR : STD_LOGIC_VECTOR ( 31 downto 0 );
  signal m02_couplers_to_m02_couplers_ARREADY : STD_LOGIC_VECTOR ( 0 to 0 );
  signal m02_couplers_to_m02_couplers_ARVALID : STD_LOGIC_VECTOR ( 0 to 0 );
  signal m02_couplers_to_m02_couplers_AWADDR : STD_LOGIC_VECTOR ( 31 downto 0 );
  signal m02_couplers_to_m02_couplers_AWREADY : STD_LOGIC_VECTOR ( 0 to 0 );
  signal m02_couplers_to_m02_couplers_AWVALID : STD_LOGIC_VECTOR ( 0 to 0 );
  signal m02_couplers_to_m02_couplers_BREADY : STD_LOGIC_VECTOR ( 0 to 0 );
  signal m02_couplers_to_m02_couplers_BRESP : STD_LOGIC_VECTOR ( 1 downto 0 );
  signal m02_couplers_to_m02_couplers_BVALID : STD_LOGIC_VECTOR ( 0 to 0 );
  signal m02_couplers_to_m02_couplers_RDATA : STD_LOGIC_VECTOR ( 31 downto 0 );
  signal m02_couplers_to_m02_couplers_RREADY : STD_LOGIC_VECTOR ( 0 to 0 );
  signal m02_couplers_to_m02_couplers_RRESP : STD_LOGIC_VECTOR ( 1 downto 0 );
  signal m02_couplers_to_m02_couplers_RVALID : STD_LOGIC_VECTOR ( 0 to 0 );
  signal m02_couplers_to_m02_couplers_WDATA : STD_LOGIC_VECTOR ( 31 downto 0 );
  signal m02_couplers_to_m02_couplers_WREADY : STD_LOGIC_VECTOR ( 0 to 0 );
  signal m02_couplers_to_m02_couplers_WSTRB : STD_LOGIC_VECTOR ( 3 downto 0 );
  signal m02_couplers_to_m02_couplers_WVALID : STD_LOGIC_VECTOR ( 0 to 0 );
begin
  M_AXI_araddr(31 downto 0) <= m02_couplers_to_m02_couplers_ARADDR(31 downto 0);
  M_AXI_arvalid(0) <= m02_couplers_to_m02_couplers_ARVALID(0);
  M_AXI_awaddr(31 downto 0) <= m02_couplers_to_m02_couplers_AWADDR(31 downto 0);
  M_AXI_awvalid(0) <= m02_couplers_to_m02_couplers_AWVALID(0);
  M_AXI_bready(0) <= m02_couplers_to_m02_couplers_BREADY(0);
  M_AXI_rready(0) <= m02_couplers_to_m02_couplers_RREADY(0);
  M_AXI_wdata(31 downto 0) <= m02_couplers_to_m02_couplers_WDATA(31 downto 0);
  M_AXI_wstrb(3 downto 0) <= m02_couplers_to_m02_couplers_WSTRB(3 downto 0);
  M_AXI_wvalid(0) <= m02_couplers_to_m02_couplers_WVALID(0);
  S_AXI_arready(0) <= m02_couplers_to_m02_couplers_ARREADY(0);
  S_AXI_awready(0) <= m02_couplers_to_m02_couplers_AWREADY(0);
  S_AXI_bresp(1 downto 0) <= m02_couplers_to_m02_couplers_BRESP(1 downto 0);
  S_AXI_bvalid(0) <= m02_couplers_to_m02_couplers_BVALID(0);
  S_AXI_rdata(31 downto 0) <= m02_couplers_to_m02_couplers_RDATA(31 downto 0);
  S_AXI_rresp(1 downto 0) <= m02_couplers_to_m02_couplers_RRESP(1 downto 0);
  S_AXI_rvalid(0) <= m02_couplers_to_m02_couplers_RVALID(0);
  S_AXI_wready(0) <= m02_couplers_to_m02_couplers_WREADY(0);
  m02_couplers_to_m02_couplers_ARADDR(31 downto 0) <= S_AXI_araddr(31 downto 0);
  m02_couplers_to_m02_couplers_ARREADY(0) <= M_AXI_arready(0);
  m02_couplers_to_m02_couplers_ARVALID(0) <= S_AXI_arvalid(0);
  m02_couplers_to_m02_couplers_AWADDR(31 downto 0) <= S_AXI_awaddr(31 downto 0);
  m02_couplers_to_m02_couplers_AWREADY(0) <= M_AXI_awready(0);
  m02_couplers_to_m02_couplers_AWVALID(0) <= S_AXI_awvalid(0);
  m02_couplers_to_m02_couplers_BREADY(0) <= S_AXI_bready(0);
  m02_couplers_to_m02_couplers_BRESP(1 downto 0) <= M_AXI_bresp(1 downto 0);
  m02_couplers_to_m02_couplers_BVALID(0) <= M_AXI_bvalid(0);
  m02_couplers_to_m02_couplers_RDATA(31 downto 0) <= M_AXI_rdata(31 downto 0);
  m02_couplers_to_m02_couplers_RREADY(0) <= S_AXI_rready(0);
  m02_couplers_to_m02_couplers_RRESP(1 downto 0) <= M_AXI_rresp(1 downto 0);
  m02_couplers_to_m02_couplers_RVALID(0) <= M_AXI_rvalid(0);
  m02_couplers_to_m02_couplers_WDATA(31 downto 0) <= S_AXI_wdata(31 downto 0);
  m02_couplers_to_m02_couplers_WREADY(0) <= M_AXI_wready(0);
  m02_couplers_to_m02_couplers_WSTRB(3 downto 0) <= S_AXI_wstrb(3 downto 0);
  m02_couplers_to_m02_couplers_WVALID(0) <= S_AXI_wvalid(0);
end STRUCTURE;
library IEEE;
use IEEE.STD_LOGIC_1164.ALL;
library UNISIM;
use UNISIM.VCOMPONENTS.ALL;
entity m03_couplers_imp_1GAIQI3 is
  port (
    M_ACLK : in STD_LOGIC;
    M_ARESETN : in STD_LOGIC;
    M_AXI_araddr : out STD_LOGIC_VECTOR ( 31 downto 0 );
    M_AXI_arready : in STD_LOGIC;
    M_AXI_arvalid : out STD_LOGIC;
    M_AXI_awaddr : out STD_LOGIC_VECTOR ( 31 downto 0 );
    M_AXI_awready : in STD_LOGIC;
    M_AXI_awvalid : out STD_LOGIC;
    M_AXI_bready : out STD_LOGIC;
    M_AXI_bresp : in STD_LOGIC_VECTOR ( 1 downto 0 );
    M_AXI_bvalid : in STD_LOGIC;
    M_AXI_rdata : in STD_LOGIC_VECTOR ( 31 downto 0 );
    M_AXI_rready : out STD_LOGIC;
    M_AXI_rresp : in STD_LOGIC_VECTOR ( 1 downto 0 );
    M_AXI_rvalid : in STD_LOGIC;
    M_AXI_wdata : out STD_LOGIC_VECTOR ( 31 downto 0 );
    M_AXI_wready : in STD_LOGIC;
    M_AXI_wstrb : out STD_LOGIC_VECTOR ( 3 downto 0 );
    M_AXI_wvalid : out STD_LOGIC;
    S_ACLK : in STD_LOGIC;
    S_ARESETN : in STD_LOGIC;
    S_AXI_araddr : in STD_LOGIC_VECTOR ( 31 downto 0 );
    S_AXI_arready : out STD_LOGIC;
    S_AXI_arvalid : in STD_LOGIC;
    S_AXI_awaddr : in STD_LOGIC_VECTOR ( 31 downto 0 );
    S_AXI_awready : out STD_LOGIC;
    S_AXI_awvalid : in STD_LOGIC;
    S_AXI_bready : in STD_LOGIC;
    S_AXI_bresp : out STD_LOGIC_VECTOR ( 1 downto 0 );
    S_AXI_bvalid : out STD_LOGIC;
    S_AXI_rdata : out STD_LOGIC_VECTOR ( 31 downto 0 );
    S_AXI_rready : in STD_LOGIC;
    S_AXI_rresp : out STD_LOGIC_VECTOR ( 1 downto 0 );
    S_AXI_rvalid : out STD_LOGIC;
    S_AXI_wdata : in STD_LOGIC_VECTOR ( 31 downto 0 );
    S_AXI_wready : out STD_LOGIC;
    S_AXI_wstrb : in STD_LOGIC_VECTOR ( 3 downto 0 );
    S_AXI_wvalid : in STD_LOGIC
  );
end m03_couplers_imp_1GAIQI3;

architecture STRUCTURE of m03_couplers_imp_1GAIQI3 is
  signal m03_couplers_to_m03_couplers_ARADDR : STD_LOGIC_VECTOR ( 31 downto 0 );
  signal m03_couplers_to_m03_couplers_ARREADY : STD_LOGIC;
  signal m03_couplers_to_m03_couplers_ARVALID : STD_LOGIC;
  signal m03_couplers_to_m03_couplers_AWADDR : STD_LOGIC_VECTOR ( 31 downto 0 );
  signal m03_couplers_to_m03_couplers_AWREADY : STD_LOGIC;
  signal m03_couplers_to_m03_couplers_AWVALID : STD_LOGIC;
  signal m03_couplers_to_m03_couplers_BREADY : STD_LOGIC;
  signal m03_couplers_to_m03_couplers_BRESP : STD_LOGIC_VECTOR ( 1 downto 0 );
  signal m03_couplers_to_m03_couplers_BVALID : STD_LOGIC;
  signal m03_couplers_to_m03_couplers_RDATA : STD_LOGIC_VECTOR ( 31 downto 0 );
  signal m03_couplers_to_m03_couplers_RREADY : STD_LOGIC;
  signal m03_couplers_to_m03_couplers_RRESP : STD_LOGIC_VECTOR ( 1 downto 0 );
  signal m03_couplers_to_m03_couplers_RVALID : STD_LOGIC;
  signal m03_couplers_to_m03_couplers_WDATA : STD_LOGIC_VECTOR ( 31 downto 0 );
  signal m03_couplers_to_m03_couplers_WREADY : STD_LOGIC;
  signal m03_couplers_to_m03_couplers_WSTRB : STD_LOGIC_VECTOR ( 3 downto 0 );
  signal m03_couplers_to_m03_couplers_WVALID : STD_LOGIC;
begin
  M_AXI_araddr(31 downto 0) <= m03_couplers_to_m03_couplers_ARADDR(31 downto 0);
  M_AXI_arvalid <= m03_couplers_to_m03_couplers_ARVALID;
  M_AXI_awaddr(31 downto 0) <= m03_couplers_to_m03_couplers_AWADDR(31 downto 0);
  M_AXI_awvalid <= m03_couplers_to_m03_couplers_AWVALID;
  M_AXI_bready <= m03_couplers_to_m03_couplers_BREADY;
  M_AXI_rready <= m03_couplers_to_m03_couplers_RREADY;
  M_AXI_wdata(31 downto 0) <= m03_couplers_to_m03_couplers_WDATA(31 downto 0);
  M_AXI_wstrb(3 downto 0) <= m03_couplers_to_m03_couplers_WSTRB(3 downto 0);
  M_AXI_wvalid <= m03_couplers_to_m03_couplers_WVALID;
  S_AXI_arready <= m03_couplers_to_m03_couplers_ARREADY;
  S_AXI_awready <= m03_couplers_to_m03_couplers_AWREADY;
  S_AXI_bresp(1 downto 0) <= m03_couplers_to_m03_couplers_BRESP(1 downto 0);
  S_AXI_bvalid <= m03_couplers_to_m03_couplers_BVALID;
  S_AXI_rdata(31 downto 0) <= m03_couplers_to_m03_couplers_RDATA(31 downto 0);
  S_AXI_rresp(1 downto 0) <= m03_couplers_to_m03_couplers_RRESP(1 downto 0);
  S_AXI_rvalid <= m03_couplers_to_m03_couplers_RVALID;
  S_AXI_wready <= m03_couplers_to_m03_couplers_WREADY;
  m03_couplers_to_m03_couplers_ARADDR(31 downto 0) <= S_AXI_araddr(31 downto 0);
  m03_couplers_to_m03_couplers_ARREADY <= M_AXI_arready;
  m03_couplers_to_m03_couplers_ARVALID <= S_AXI_arvalid;
  m03_couplers_to_m03_couplers_AWADDR(31 downto 0) <= S_AXI_awaddr(31 downto 0);
  m03_couplers_to_m03_couplers_AWREADY <= M_AXI_awready;
  m03_couplers_to_m03_couplers_AWVALID <= S_AXI_awvalid;
  m03_couplers_to_m03_couplers_BREADY <= S_AXI_bready;
  m03_couplers_to_m03_couplers_BRESP(1 downto 0) <= M_AXI_bresp(1 downto 0);
  m03_couplers_to_m03_couplers_BVALID <= M_AXI_bvalid;
  m03_couplers_to_m03_couplers_RDATA(31 downto 0) <= M_AXI_rdata(31 downto 0);
  m03_couplers_to_m03_couplers_RREADY <= S_AXI_rready;
  m03_couplers_to_m03_couplers_RRESP(1 downto 0) <= M_AXI_rresp(1 downto 0);
  m03_couplers_to_m03_couplers_RVALID <= M_AXI_rvalid;
  m03_couplers_to_m03_couplers_WDATA(31 downto 0) <= S_AXI_wdata(31 downto 0);
  m03_couplers_to_m03_couplers_WREADY <= M_AXI_wready;
  m03_couplers_to_m03_couplers_WSTRB(3 downto 0) <= S_AXI_wstrb(3 downto 0);
  m03_couplers_to_m03_couplers_WVALID <= S_AXI_wvalid;
end STRUCTURE;
library IEEE;
use IEEE.STD_LOGIC_1164.ALL;
library UNISIM;
use UNISIM.VCOMPONENTS.ALL;
entity m04_couplers_imp_1OEV23V is
  port (
    M_ACLK : in STD_LOGIC;
    M_ARESETN : in STD_LOGIC;
    M_AXI_araddr : out STD_LOGIC_VECTOR ( 31 downto 0 );
    M_AXI_arprot : out STD_LOGIC_VECTOR ( 2 downto 0 );
    M_AXI_arready : in STD_LOGIC_VECTOR ( 0 to 0 );
    M_AXI_arvalid : out STD_LOGIC_VECTOR ( 0 to 0 );
    M_AXI_awaddr : out STD_LOGIC_VECTOR ( 31 downto 0 );
    M_AXI_awprot : out STD_LOGIC_VECTOR ( 2 downto 0 );
    M_AXI_awready : in STD_LOGIC_VECTOR ( 0 to 0 );
    M_AXI_awvalid : out STD_LOGIC_VECTOR ( 0 to 0 );
    M_AXI_bready : out STD_LOGIC_VECTOR ( 0 to 0 );
    M_AXI_bresp : in STD_LOGIC_VECTOR ( 1 downto 0 );
    M_AXI_bvalid : in STD_LOGIC_VECTOR ( 0 to 0 );
    M_AXI_rdata : in STD_LOGIC_VECTOR ( 31 downto 0 );
    M_AXI_rready : out STD_LOGIC_VECTOR ( 0 to 0 );
    M_AXI_rresp : in STD_LOGIC_VECTOR ( 1 downto 0 );
    M_AXI_rvalid : in STD_LOGIC_VECTOR ( 0 to 0 );
    M_AXI_wdata : out STD_LOGIC_VECTOR ( 31 downto 0 );
    M_AXI_wready : in STD_LOGIC_VECTOR ( 0 to 0 );
    M_AXI_wstrb : out STD_LOGIC_VECTOR ( 3 downto 0 );
    M_AXI_wvalid : out STD_LOGIC_VECTOR ( 0 to 0 );
    S_ACLK : in STD_LOGIC;
    S_ARESETN : in STD_LOGIC;
    S_AXI_araddr : in STD_LOGIC_VECTOR ( 31 downto 0 );
    S_AXI_arprot : in STD_LOGIC_VECTOR ( 2 downto 0 );
    S_AXI_arready : out STD_LOGIC_VECTOR ( 0 to 0 );
    S_AXI_arvalid : in STD_LOGIC_VECTOR ( 0 to 0 );
    S_AXI_awaddr : in STD_LOGIC_VECTOR ( 31 downto 0 );
    S_AXI_awprot : in STD_LOGIC_VECTOR ( 2 downto 0 );
    S_AXI_awready : out STD_LOGIC_VECTOR ( 0 to 0 );
    S_AXI_awvalid : in STD_LOGIC_VECTOR ( 0 to 0 );
    S_AXI_bready : in STD_LOGIC_VECTOR ( 0 to 0 );
    S_AXI_bresp : out STD_LOGIC_VECTOR ( 1 downto 0 );
    S_AXI_bvalid : out STD_LOGIC_VECTOR ( 0 to 0 );
    S_AXI_rdata : out STD_LOGIC_VECTOR ( 31 downto 0 );
    S_AXI_rready : in STD_LOGIC_VECTOR ( 0 to 0 );
    S_AXI_rresp : out STD_LOGIC_VECTOR ( 1 downto 0 );
    S_AXI_rvalid : out STD_LOGIC_VECTOR ( 0 to 0 );
    S_AXI_wdata : in STD_LOGIC_VECTOR ( 31 downto 0 );
    S_AXI_wready : out STD_LOGIC_VECTOR ( 0 to 0 );
    S_AXI_wstrb : in STD_LOGIC_VECTOR ( 3 downto 0 );
    S_AXI_wvalid : in STD_LOGIC_VECTOR ( 0 to 0 )
  );
end m04_couplers_imp_1OEV23V;

architecture STRUCTURE of m04_couplers_imp_1OEV23V is
  signal m04_couplers_to_m04_couplers_ARADDR : STD_LOGIC_VECTOR ( 31 downto 0 );
  signal m04_couplers_to_m04_couplers_ARPROT : STD_LOGIC_VECTOR ( 2 downto 0 );
  signal m04_couplers_to_m04_couplers_ARREADY : STD_LOGIC_VECTOR ( 0 to 0 );
  signal m04_couplers_to_m04_couplers_ARVALID : STD_LOGIC_VECTOR ( 0 to 0 );
  signal m04_couplers_to_m04_couplers_AWADDR : STD_LOGIC_VECTOR ( 31 downto 0 );
  signal m04_couplers_to_m04_couplers_AWPROT : STD_LOGIC_VECTOR ( 2 downto 0 );
  signal m04_couplers_to_m04_couplers_AWREADY : STD_LOGIC_VECTOR ( 0 to 0 );
  signal m04_couplers_to_m04_couplers_AWVALID : STD_LOGIC_VECTOR ( 0 to 0 );
  signal m04_couplers_to_m04_couplers_BREADY : STD_LOGIC_VECTOR ( 0 to 0 );
  signal m04_couplers_to_m04_couplers_BRESP : STD_LOGIC_VECTOR ( 1 downto 0 );
  signal m04_couplers_to_m04_couplers_BVALID : STD_LOGIC_VECTOR ( 0 to 0 );
  signal m04_couplers_to_m04_couplers_RDATA : STD_LOGIC_VECTOR ( 31 downto 0 );
  signal m04_couplers_to_m04_couplers_RREADY : STD_LOGIC_VECTOR ( 0 to 0 );
  signal m04_couplers_to_m04_couplers_RRESP : STD_LOGIC_VECTOR ( 1 downto 0 );
  signal m04_couplers_to_m04_couplers_RVALID : STD_LOGIC_VECTOR ( 0 to 0 );
  signal m04_couplers_to_m04_couplers_WDATA : STD_LOGIC_VECTOR ( 31 downto 0 );
  signal m04_couplers_to_m04_couplers_WREADY : STD_LOGIC_VECTOR ( 0 to 0 );
  signal m04_couplers_to_m04_couplers_WSTRB : STD_LOGIC_VECTOR ( 3 downto 0 );
  signal m04_couplers_to_m04_couplers_WVALID : STD_LOGIC_VECTOR ( 0 to 0 );
begin
  M_AXI_araddr(31 downto 0) <= m04_couplers_to_m04_couplers_ARADDR(31 downto 0);
  M_AXI_arprot(2 downto 0) <= m04_couplers_to_m04_couplers_ARPROT(2 downto 0);
  M_AXI_arvalid(0) <= m04_couplers_to_m04_couplers_ARVALID(0);
  M_AXI_awaddr(31 downto 0) <= m04_couplers_to_m04_couplers_AWADDR(31 downto 0);
  M_AXI_awprot(2 downto 0) <= m04_couplers_to_m04_couplers_AWPROT(2 downto 0);
  M_AXI_awvalid(0) <= m04_couplers_to_m04_couplers_AWVALID(0);
  M_AXI_bready(0) <= m04_couplers_to_m04_couplers_BREADY(0);
  M_AXI_rready(0) <= m04_couplers_to_m04_couplers_RREADY(0);
  M_AXI_wdata(31 downto 0) <= m04_couplers_to_m04_couplers_WDATA(31 downto 0);
  M_AXI_wstrb(3 downto 0) <= m04_couplers_to_m04_couplers_WSTRB(3 downto 0);
  M_AXI_wvalid(0) <= m04_couplers_to_m04_couplers_WVALID(0);
  S_AXI_arready(0) <= m04_couplers_to_m04_couplers_ARREADY(0);
  S_AXI_awready(0) <= m04_couplers_to_m04_couplers_AWREADY(0);
  S_AXI_bresp(1 downto 0) <= m04_couplers_to_m04_couplers_BRESP(1 downto 0);
  S_AXI_bvalid(0) <= m04_couplers_to_m04_couplers_BVALID(0);
  S_AXI_rdata(31 downto 0) <= m04_couplers_to_m04_couplers_RDATA(31 downto 0);
  S_AXI_rresp(1 downto 0) <= m04_couplers_to_m04_couplers_RRESP(1 downto 0);
  S_AXI_rvalid(0) <= m04_couplers_to_m04_couplers_RVALID(0);
  S_AXI_wready(0) <= m04_couplers_to_m04_couplers_WREADY(0);
  m04_couplers_to_m04_couplers_ARADDR(31 downto 0) <= S_AXI_araddr(31 downto 0);
  m04_couplers_to_m04_couplers_ARPROT(2 downto 0) <= S_AXI_arprot(2 downto 0);
  m04_couplers_to_m04_couplers_ARREADY(0) <= M_AXI_arready(0);
  m04_couplers_to_m04_couplers_ARVALID(0) <= S_AXI_arvalid(0);
  m04_couplers_to_m04_couplers_AWADDR(31 downto 0) <= S_AXI_awaddr(31 downto 0);
  m04_couplers_to_m04_couplers_AWPROT(2 downto 0) <= S_AXI_awprot(2 downto 0);
  m04_couplers_to_m04_couplers_AWREADY(0) <= M_AXI_awready(0);
  m04_couplers_to_m04_couplers_AWVALID(0) <= S_AXI_awvalid(0);
  m04_couplers_to_m04_couplers_BREADY(0) <= S_AXI_bready(0);
  m04_couplers_to_m04_couplers_BRESP(1 downto 0) <= M_AXI_bresp(1 downto 0);
  m04_couplers_to_m04_couplers_BVALID(0) <= M_AXI_bvalid(0);
  m04_couplers_to_m04_couplers_RDATA(31 downto 0) <= M_AXI_rdata(31 downto 0);
  m04_couplers_to_m04_couplers_RREADY(0) <= S_AXI_rready(0);
  m04_couplers_to_m04_couplers_RRESP(1 downto 0) <= M_AXI_rresp(1 downto 0);
  m04_couplers_to_m04_couplers_RVALID(0) <= M_AXI_rvalid(0);
  m04_couplers_to_m04_couplers_WDATA(31 downto 0) <= S_AXI_wdata(31 downto 0);
  m04_couplers_to_m04_couplers_WREADY(0) <= M_AXI_wready(0);
  m04_couplers_to_m04_couplers_WSTRB(3 downto 0) <= S_AXI_wstrb(3 downto 0);
  m04_couplers_to_m04_couplers_WVALID(0) <= S_AXI_wvalid(0);
end STRUCTURE;
library IEEE;
use IEEE.STD_LOGIC_1164.ALL;
library UNISIM;
use UNISIM.VCOMPONENTS.ALL;
entity m05_couplers_imp_J2A97H is
  port (
    M_ACLK : in STD_LOGIC;
    M_ARESETN : in STD_LOGIC;
    M_AXI_araddr : out STD_LOGIC_VECTOR ( 31 downto 0 );
    M_AXI_arready : in STD_LOGIC_VECTOR ( 0 to 0 );
    M_AXI_arvalid : out STD_LOGIC_VECTOR ( 0 to 0 );
    M_AXI_awaddr : out STD_LOGIC_VECTOR ( 31 downto 0 );
    M_AXI_awready : in STD_LOGIC_VECTOR ( 0 to 0 );
    M_AXI_awvalid : out STD_LOGIC_VECTOR ( 0 to 0 );
    M_AXI_bready : out STD_LOGIC_VECTOR ( 0 to 0 );
    M_AXI_bresp : in STD_LOGIC_VECTOR ( 1 downto 0 );
    M_AXI_bvalid : in STD_LOGIC_VECTOR ( 0 to 0 );
    M_AXI_rdata : in STD_LOGIC_VECTOR ( 31 downto 0 );
    M_AXI_rready : out STD_LOGIC_VECTOR ( 0 to 0 );
    M_AXI_rresp : in STD_LOGIC_VECTOR ( 1 downto 0 );
    M_AXI_rvalid : in STD_LOGIC_VECTOR ( 0 to 0 );
    M_AXI_wdata : out STD_LOGIC_VECTOR ( 31 downto 0 );
    M_AXI_wready : in STD_LOGIC_VECTOR ( 0 to 0 );
    M_AXI_wstrb : out STD_LOGIC_VECTOR ( 3 downto 0 );
    M_AXI_wvalid : out STD_LOGIC_VECTOR ( 0 to 0 );
    S_ACLK : in STD_LOGIC;
    S_ARESETN : in STD_LOGIC;
    S_AXI_araddr : in STD_LOGIC_VECTOR ( 31 downto 0 );
    S_AXI_arready : out STD_LOGIC_VECTOR ( 0 to 0 );
    S_AXI_arvalid : in STD_LOGIC_VECTOR ( 0 to 0 );
    S_AXI_awaddr : in STD_LOGIC_VECTOR ( 31 downto 0 );
    S_AXI_awready : out STD_LOGIC_VECTOR ( 0 to 0 );
    S_AXI_awvalid : in STD_LOGIC_VECTOR ( 0 to 0 );
    S_AXI_bready : in STD_LOGIC_VECTOR ( 0 to 0 );
    S_AXI_bresp : out STD_LOGIC_VECTOR ( 1 downto 0 );
    S_AXI_bvalid : out STD_LOGIC_VECTOR ( 0 to 0 );
    S_AXI_rdata : out STD_LOGIC_VECTOR ( 31 downto 0 );
    S_AXI_rready : in STD_LOGIC_VECTOR ( 0 to 0 );
    S_AXI_rresp : out STD_LOGIC_VECTOR ( 1 downto 0 );
    S_AXI_rvalid : out STD_LOGIC_VECTOR ( 0 to 0 );
    S_AXI_wdata : in STD_LOGIC_VECTOR ( 31 downto 0 );
    S_AXI_wready : out STD_LOGIC_VECTOR ( 0 to 0 );
    S_AXI_wstrb : in STD_LOGIC_VECTOR ( 3 downto 0 );
    S_AXI_wvalid : in STD_LOGIC_VECTOR ( 0 to 0 )
  );
end m05_couplers_imp_J2A97H;

architecture STRUCTURE of m05_couplers_imp_J2A97H is
  signal m05_couplers_to_m05_couplers_ARADDR : STD_LOGIC_VECTOR ( 31 downto 0 );
  signal m05_couplers_to_m05_couplers_ARREADY : STD_LOGIC_VECTOR ( 0 to 0 );
  signal m05_couplers_to_m05_couplers_ARVALID : STD_LOGIC_VECTOR ( 0 to 0 );
  signal m05_couplers_to_m05_couplers_AWADDR : STD_LOGIC_VECTOR ( 31 downto 0 );
  signal m05_couplers_to_m05_couplers_AWREADY : STD_LOGIC_VECTOR ( 0 to 0 );
  signal m05_couplers_to_m05_couplers_AWVALID : STD_LOGIC_VECTOR ( 0 to 0 );
  signal m05_couplers_to_m05_couplers_BREADY : STD_LOGIC_VECTOR ( 0 to 0 );
  signal m05_couplers_to_m05_couplers_BRESP : STD_LOGIC_VECTOR ( 1 downto 0 );
  signal m05_couplers_to_m05_couplers_BVALID : STD_LOGIC_VECTOR ( 0 to 0 );
  signal m05_couplers_to_m05_couplers_RDATA : STD_LOGIC_VECTOR ( 31 downto 0 );
  signal m05_couplers_to_m05_couplers_RREADY : STD_LOGIC_VECTOR ( 0 to 0 );
  signal m05_couplers_to_m05_couplers_RRESP : STD_LOGIC_VECTOR ( 1 downto 0 );
  signal m05_couplers_to_m05_couplers_RVALID : STD_LOGIC_VECTOR ( 0 to 0 );
  signal m05_couplers_to_m05_couplers_WDATA : STD_LOGIC_VECTOR ( 31 downto 0 );
  signal m05_couplers_to_m05_couplers_WREADY : STD_LOGIC_VECTOR ( 0 to 0 );
  signal m05_couplers_to_m05_couplers_WSTRB : STD_LOGIC_VECTOR ( 3 downto 0 );
  signal m05_couplers_to_m05_couplers_WVALID : STD_LOGIC_VECTOR ( 0 to 0 );
begin
  M_AXI_araddr(31 downto 0) <= m05_couplers_to_m05_couplers_ARADDR(31 downto 0);
  M_AXI_arvalid(0) <= m05_couplers_to_m05_couplers_ARVALID(0);
  M_AXI_awaddr(31 downto 0) <= m05_couplers_to_m05_couplers_AWADDR(31 downto 0);
  M_AXI_awvalid(0) <= m05_couplers_to_m05_couplers_AWVALID(0);
  M_AXI_bready(0) <= m05_couplers_to_m05_couplers_BREADY(0);
  M_AXI_rready(0) <= m05_couplers_to_m05_couplers_RREADY(0);
  M_AXI_wdata(31 downto 0) <= m05_couplers_to_m05_couplers_WDATA(31 downto 0);
  M_AXI_wstrb(3 downto 0) <= m05_couplers_to_m05_couplers_WSTRB(3 downto 0);
  M_AXI_wvalid(0) <= m05_couplers_to_m05_couplers_WVALID(0);
  S_AXI_arready(0) <= m05_couplers_to_m05_couplers_ARREADY(0);
  S_AXI_awready(0) <= m05_couplers_to_m05_couplers_AWREADY(0);
  S_AXI_bresp(1 downto 0) <= m05_couplers_to_m05_couplers_BRESP(1 downto 0);
  S_AXI_bvalid(0) <= m05_couplers_to_m05_couplers_BVALID(0);
  S_AXI_rdata(31 downto 0) <= m05_couplers_to_m05_couplers_RDATA(31 downto 0);
  S_AXI_rresp(1 downto 0) <= m05_couplers_to_m05_couplers_RRESP(1 downto 0);
  S_AXI_rvalid(0) <= m05_couplers_to_m05_couplers_RVALID(0);
  S_AXI_wready(0) <= m05_couplers_to_m05_couplers_WREADY(0);
  m05_couplers_to_m05_couplers_ARADDR(31 downto 0) <= S_AXI_araddr(31 downto 0);
  m05_couplers_to_m05_couplers_ARREADY(0) <= M_AXI_arready(0);
  m05_couplers_to_m05_couplers_ARVALID(0) <= S_AXI_arvalid(0);
  m05_couplers_to_m05_couplers_AWADDR(31 downto 0) <= S_AXI_awaddr(31 downto 0);
  m05_couplers_to_m05_couplers_AWREADY(0) <= M_AXI_awready(0);
  m05_couplers_to_m05_couplers_AWVALID(0) <= S_AXI_awvalid(0);
  m05_couplers_to_m05_couplers_BREADY(0) <= S_AXI_bready(0);
  m05_couplers_to_m05_couplers_BRESP(1 downto 0) <= M_AXI_bresp(1 downto 0);
  m05_couplers_to_m05_couplers_BVALID(0) <= M_AXI_bvalid(0);
  m05_couplers_to_m05_couplers_RDATA(31 downto 0) <= M_AXI_rdata(31 downto 0);
  m05_couplers_to_m05_couplers_RREADY(0) <= S_AXI_rready(0);
  m05_couplers_to_m05_couplers_RRESP(1 downto 0) <= M_AXI_rresp(1 downto 0);
  m05_couplers_to_m05_couplers_RVALID(0) <= M_AXI_rvalid(0);
  m05_couplers_to_m05_couplers_WDATA(31 downto 0) <= S_AXI_wdata(31 downto 0);
  m05_couplers_to_m05_couplers_WREADY(0) <= M_AXI_wready(0);
  m05_couplers_to_m05_couplers_WSTRB(3 downto 0) <= S_AXI_wstrb(3 downto 0);
  m05_couplers_to_m05_couplers_WVALID(0) <= S_AXI_wvalid(0);
end STRUCTURE;
library IEEE;
use IEEE.STD_LOGIC_1164.ALL;
library UNISIM;
use UNISIM.VCOMPONENTS.ALL;
entity m06_couplers_imp_FRPBRA is
  port (
    M_ACLK : in STD_LOGIC;
    M_ARESETN : in STD_LOGIC;
    M_AXI_araddr : out STD_LOGIC_VECTOR ( 31 downto 0 );
    M_AXI_arready : in STD_LOGIC;
    M_AXI_arvalid : out STD_LOGIC;
    M_AXI_awaddr : out STD_LOGIC_VECTOR ( 31 downto 0 );
    M_AXI_awready : in STD_LOGIC;
    M_AXI_awvalid : out STD_LOGIC;
    M_AXI_bready : out STD_LOGIC;
    M_AXI_bresp : in STD_LOGIC_VECTOR ( 1 downto 0 );
    M_AXI_bvalid : in STD_LOGIC;
    M_AXI_rdata : in STD_LOGIC_VECTOR ( 31 downto 0 );
    M_AXI_rready : out STD_LOGIC;
    M_AXI_rresp : in STD_LOGIC_VECTOR ( 1 downto 0 );
    M_AXI_rvalid : in STD_LOGIC;
    M_AXI_wdata : out STD_LOGIC_VECTOR ( 31 downto 0 );
    M_AXI_wready : in STD_LOGIC;
    M_AXI_wstrb : out STD_LOGIC_VECTOR ( 3 downto 0 );
    M_AXI_wvalid : out STD_LOGIC;
    S_ACLK : in STD_LOGIC;
    S_ARESETN : in STD_LOGIC;
    S_AXI_araddr : in STD_LOGIC_VECTOR ( 31 downto 0 );
    S_AXI_arready : out STD_LOGIC;
    S_AXI_arvalid : in STD_LOGIC;
    S_AXI_awaddr : in STD_LOGIC_VECTOR ( 31 downto 0 );
    S_AXI_awready : out STD_LOGIC;
    S_AXI_awvalid : in STD_LOGIC;
    S_AXI_bready : in STD_LOGIC;
    S_AXI_bresp : out STD_LOGIC_VECTOR ( 1 downto 0 );
    S_AXI_bvalid : out STD_LOGIC;
    S_AXI_rdata : out STD_LOGIC_VECTOR ( 31 downto 0 );
    S_AXI_rready : in STD_LOGIC;
    S_AXI_rresp : out STD_LOGIC_VECTOR ( 1 downto 0 );
    S_AXI_rvalid : out STD_LOGIC;
    S_AXI_wdata : in STD_LOGIC_VECTOR ( 31 downto 0 );
    S_AXI_wready : out STD_LOGIC;
    S_AXI_wstrb : in STD_LOGIC_VECTOR ( 3 downto 0 );
    S_AXI_wvalid : in STD_LOGIC
  );
end m06_couplers_imp_FRPBRA;

architecture STRUCTURE of m06_couplers_imp_FRPBRA is
  signal m06_couplers_to_m06_couplers_ARADDR : STD_LOGIC_VECTOR ( 31 downto 0 );
  signal m06_couplers_to_m06_couplers_ARREADY : STD_LOGIC;
  signal m06_couplers_to_m06_couplers_ARVALID : STD_LOGIC;
  signal m06_couplers_to_m06_couplers_AWADDR : STD_LOGIC_VECTOR ( 31 downto 0 );
  signal m06_couplers_to_m06_couplers_AWREADY : STD_LOGIC;
  signal m06_couplers_to_m06_couplers_AWVALID : STD_LOGIC;
  signal m06_couplers_to_m06_couplers_BREADY : STD_LOGIC;
  signal m06_couplers_to_m06_couplers_BRESP : STD_LOGIC_VECTOR ( 1 downto 0 );
  signal m06_couplers_to_m06_couplers_BVALID : STD_LOGIC;
  signal m06_couplers_to_m06_couplers_RDATA : STD_LOGIC_VECTOR ( 31 downto 0 );
  signal m06_couplers_to_m06_couplers_RREADY : STD_LOGIC;
  signal m06_couplers_to_m06_couplers_RRESP : STD_LOGIC_VECTOR ( 1 downto 0 );
  signal m06_couplers_to_m06_couplers_RVALID : STD_LOGIC;
  signal m06_couplers_to_m06_couplers_WDATA : STD_LOGIC_VECTOR ( 31 downto 0 );
  signal m06_couplers_to_m06_couplers_WREADY : STD_LOGIC;
  signal m06_couplers_to_m06_couplers_WSTRB : STD_LOGIC_VECTOR ( 3 downto 0 );
  signal m06_couplers_to_m06_couplers_WVALID : STD_LOGIC;
begin
  M_AXI_araddr(31 downto 0) <= m06_couplers_to_m06_couplers_ARADDR(31 downto 0);
  M_AXI_arvalid <= m06_couplers_to_m06_couplers_ARVALID;
  M_AXI_awaddr(31 downto 0) <= m06_couplers_to_m06_couplers_AWADDR(31 downto 0);
  M_AXI_awvalid <= m06_couplers_to_m06_couplers_AWVALID;
  M_AXI_bready <= m06_couplers_to_m06_couplers_BREADY;
  M_AXI_rready <= m06_couplers_to_m06_couplers_RREADY;
  M_AXI_wdata(31 downto 0) <= m06_couplers_to_m06_couplers_WDATA(31 downto 0);
  M_AXI_wstrb(3 downto 0) <= m06_couplers_to_m06_couplers_WSTRB(3 downto 0);
  M_AXI_wvalid <= m06_couplers_to_m06_couplers_WVALID;
  S_AXI_arready <= m06_couplers_to_m06_couplers_ARREADY;
  S_AXI_awready <= m06_couplers_to_m06_couplers_AWREADY;
  S_AXI_bresp(1 downto 0) <= m06_couplers_to_m06_couplers_BRESP(1 downto 0);
  S_AXI_bvalid <= m06_couplers_to_m06_couplers_BVALID;
  S_AXI_rdata(31 downto 0) <= m06_couplers_to_m06_couplers_RDATA(31 downto 0);
  S_AXI_rresp(1 downto 0) <= m06_couplers_to_m06_couplers_RRESP(1 downto 0);
  S_AXI_rvalid <= m06_couplers_to_m06_couplers_RVALID;
  S_AXI_wready <= m06_couplers_to_m06_couplers_WREADY;
  m06_couplers_to_m06_couplers_ARADDR(31 downto 0) <= S_AXI_araddr(31 downto 0);
  m06_couplers_to_m06_couplers_ARREADY <= M_AXI_arready;
  m06_couplers_to_m06_couplers_ARVALID <= S_AXI_arvalid;
  m06_couplers_to_m06_couplers_AWADDR(31 downto 0) <= S_AXI_awaddr(31 downto 0);
  m06_couplers_to_m06_couplers_AWREADY <= M_AXI_awready;
  m06_couplers_to_m06_couplers_AWVALID <= S_AXI_awvalid;
  m06_couplers_to_m06_couplers_BREADY <= S_AXI_bready;
  m06_couplers_to_m06_couplers_BRESP(1 downto 0) <= M_AXI_bresp(1 downto 0);
  m06_couplers_to_m06_couplers_BVALID <= M_AXI_bvalid;
  m06_couplers_to_m06_couplers_RDATA(31 downto 0) <= M_AXI_rdata(31 downto 0);
  m06_couplers_to_m06_couplers_RREADY <= S_AXI_rready;
  m06_couplers_to_m06_couplers_RRESP(1 downto 0) <= M_AXI_rresp(1 downto 0);
  m06_couplers_to_m06_couplers_RVALID <= M_AXI_rvalid;
  m06_couplers_to_m06_couplers_WDATA(31 downto 0) <= S_AXI_wdata(31 downto 0);
  m06_couplers_to_m06_couplers_WREADY <= M_AXI_wready;
  m06_couplers_to_m06_couplers_WSTRB(3 downto 0) <= S_AXI_wstrb(3 downto 0);
  m06_couplers_to_m06_couplers_WVALID <= S_AXI_wvalid;
end STRUCTURE;
library IEEE;
use IEEE.STD_LOGIC_1164.ALL;
library UNISIM;
use UNISIM.VCOMPONENTS.ALL;
entity m07_couplers_imp_1A0NX68 is
  port (
    M_ACLK : in STD_LOGIC;
    M_ARESETN : in STD_LOGIC;
    M_AXI_araddr : out STD_LOGIC_VECTOR ( 31 downto 0 );
    M_AXI_arready : in STD_LOGIC_VECTOR ( 0 to 0 );
    M_AXI_arvalid : out STD_LOGIC_VECTOR ( 0 to 0 );
    M_AXI_awaddr : out STD_LOGIC_VECTOR ( 31 downto 0 );
    M_AXI_awready : in STD_LOGIC_VECTOR ( 0 to 0 );
    M_AXI_awvalid : out STD_LOGIC_VECTOR ( 0 to 0 );
    M_AXI_bready : out STD_LOGIC_VECTOR ( 0 to 0 );
    M_AXI_bresp : in STD_LOGIC_VECTOR ( 1 downto 0 );
    M_AXI_bvalid : in STD_LOGIC_VECTOR ( 0 to 0 );
    M_AXI_rdata : in STD_LOGIC_VECTOR ( 31 downto 0 );
    M_AXI_rready : out STD_LOGIC_VECTOR ( 0 to 0 );
    M_AXI_rresp : in STD_LOGIC_VECTOR ( 1 downto 0 );
    M_AXI_rvalid : in STD_LOGIC_VECTOR ( 0 to 0 );
    M_AXI_wdata : out STD_LOGIC_VECTOR ( 31 downto 0 );
    M_AXI_wready : in STD_LOGIC_VECTOR ( 0 to 0 );
    M_AXI_wstrb : out STD_LOGIC_VECTOR ( 3 downto 0 );
    M_AXI_wvalid : out STD_LOGIC_VECTOR ( 0 to 0 );
    S_ACLK : in STD_LOGIC;
    S_ARESETN : in STD_LOGIC;
    S_AXI_araddr : in STD_LOGIC_VECTOR ( 31 downto 0 );
    S_AXI_arready : out STD_LOGIC_VECTOR ( 0 to 0 );
    S_AXI_arvalid : in STD_LOGIC_VECTOR ( 0 to 0 );
    S_AXI_awaddr : in STD_LOGIC_VECTOR ( 31 downto 0 );
    S_AXI_awready : out STD_LOGIC_VECTOR ( 0 to 0 );
    S_AXI_awvalid : in STD_LOGIC_VECTOR ( 0 to 0 );
    S_AXI_bready : in STD_LOGIC_VECTOR ( 0 to 0 );
    S_AXI_bresp : out STD_LOGIC_VECTOR ( 1 downto 0 );
    S_AXI_bvalid : out STD_LOGIC_VECTOR ( 0 to 0 );
    S_AXI_rdata : out STD_LOGIC_VECTOR ( 31 downto 0 );
    S_AXI_rready : in STD_LOGIC_VECTOR ( 0 to 0 );
    S_AXI_rresp : out STD_LOGIC_VECTOR ( 1 downto 0 );
    S_AXI_rvalid : out STD_LOGIC_VECTOR ( 0 to 0 );
    S_AXI_wdata : in STD_LOGIC_VECTOR ( 31 downto 0 );
    S_AXI_wready : out STD_LOGIC_VECTOR ( 0 to 0 );
    S_AXI_wstrb : in STD_LOGIC_VECTOR ( 3 downto 0 );
    S_AXI_wvalid : in STD_LOGIC_VECTOR ( 0 to 0 )
  );
end m07_couplers_imp_1A0NX68;

architecture STRUCTURE of m07_couplers_imp_1A0NX68 is
  signal m07_couplers_to_m07_couplers_ARADDR : STD_LOGIC_VECTOR ( 31 downto 0 );
  signal m07_couplers_to_m07_couplers_ARREADY : STD_LOGIC_VECTOR ( 0 to 0 );
  signal m07_couplers_to_m07_couplers_ARVALID : STD_LOGIC_VECTOR ( 0 to 0 );
  signal m07_couplers_to_m07_couplers_AWADDR : STD_LOGIC_VECTOR ( 31 downto 0 );
  signal m07_couplers_to_m07_couplers_AWREADY : STD_LOGIC_VECTOR ( 0 to 0 );
  signal m07_couplers_to_m07_couplers_AWVALID : STD_LOGIC_VECTOR ( 0 to 0 );
  signal m07_couplers_to_m07_couplers_BREADY : STD_LOGIC_VECTOR ( 0 to 0 );
  signal m07_couplers_to_m07_couplers_BRESP : STD_LOGIC_VECTOR ( 1 downto 0 );
  signal m07_couplers_to_m07_couplers_BVALID : STD_LOGIC_VECTOR ( 0 to 0 );
  signal m07_couplers_to_m07_couplers_RDATA : STD_LOGIC_VECTOR ( 31 downto 0 );
  signal m07_couplers_to_m07_couplers_RREADY : STD_LOGIC_VECTOR ( 0 to 0 );
  signal m07_couplers_to_m07_couplers_RRESP : STD_LOGIC_VECTOR ( 1 downto 0 );
  signal m07_couplers_to_m07_couplers_RVALID : STD_LOGIC_VECTOR ( 0 to 0 );
  signal m07_couplers_to_m07_couplers_WDATA : STD_LOGIC_VECTOR ( 31 downto 0 );
  signal m07_couplers_to_m07_couplers_WREADY : STD_LOGIC_VECTOR ( 0 to 0 );
  signal m07_couplers_to_m07_couplers_WSTRB : STD_LOGIC_VECTOR ( 3 downto 0 );
  signal m07_couplers_to_m07_couplers_WVALID : STD_LOGIC_VECTOR ( 0 to 0 );
begin
  M_AXI_araddr(31 downto 0) <= m07_couplers_to_m07_couplers_ARADDR(31 downto 0);
  M_AXI_arvalid(0) <= m07_couplers_to_m07_couplers_ARVALID(0);
  M_AXI_awaddr(31 downto 0) <= m07_couplers_to_m07_couplers_AWADDR(31 downto 0);
  M_AXI_awvalid(0) <= m07_couplers_to_m07_couplers_AWVALID(0);
  M_AXI_bready(0) <= m07_couplers_to_m07_couplers_BREADY(0);
  M_AXI_rready(0) <= m07_couplers_to_m07_couplers_RREADY(0);
  M_AXI_wdata(31 downto 0) <= m07_couplers_to_m07_couplers_WDATA(31 downto 0);
  M_AXI_wstrb(3 downto 0) <= m07_couplers_to_m07_couplers_WSTRB(3 downto 0);
  M_AXI_wvalid(0) <= m07_couplers_to_m07_couplers_WVALID(0);
  S_AXI_arready(0) <= m07_couplers_to_m07_couplers_ARREADY(0);
  S_AXI_awready(0) <= m07_couplers_to_m07_couplers_AWREADY(0);
  S_AXI_bresp(1 downto 0) <= m07_couplers_to_m07_couplers_BRESP(1 downto 0);
  S_AXI_bvalid(0) <= m07_couplers_to_m07_couplers_BVALID(0);
  S_AXI_rdata(31 downto 0) <= m07_couplers_to_m07_couplers_RDATA(31 downto 0);
  S_AXI_rresp(1 downto 0) <= m07_couplers_to_m07_couplers_RRESP(1 downto 0);
  S_AXI_rvalid(0) <= m07_couplers_to_m07_couplers_RVALID(0);
  S_AXI_wready(0) <= m07_couplers_to_m07_couplers_WREADY(0);
  m07_couplers_to_m07_couplers_ARADDR(31 downto 0) <= S_AXI_araddr(31 downto 0);
  m07_couplers_to_m07_couplers_ARREADY(0) <= M_AXI_arready(0);
  m07_couplers_to_m07_couplers_ARVALID(0) <= S_AXI_arvalid(0);
  m07_couplers_to_m07_couplers_AWADDR(31 downto 0) <= S_AXI_awaddr(31 downto 0);
  m07_couplers_to_m07_couplers_AWREADY(0) <= M_AXI_awready(0);
  m07_couplers_to_m07_couplers_AWVALID(0) <= S_AXI_awvalid(0);
  m07_couplers_to_m07_couplers_BREADY(0) <= S_AXI_bready(0);
  m07_couplers_to_m07_couplers_BRESP(1 downto 0) <= M_AXI_bresp(1 downto 0);
  m07_couplers_to_m07_couplers_BVALID(0) <= M_AXI_bvalid(0);
  m07_couplers_to_m07_couplers_RDATA(31 downto 0) <= M_AXI_rdata(31 downto 0);
  m07_couplers_to_m07_couplers_RREADY(0) <= S_AXI_rready(0);
  m07_couplers_to_m07_couplers_RRESP(1 downto 0) <= M_AXI_rresp(1 downto 0);
  m07_couplers_to_m07_couplers_RVALID(0) <= M_AXI_rvalid(0);
  m07_couplers_to_m07_couplers_WDATA(31 downto 0) <= S_AXI_wdata(31 downto 0);
  m07_couplers_to_m07_couplers_WREADY(0) <= M_AXI_wready(0);
  m07_couplers_to_m07_couplers_WSTRB(3 downto 0) <= S_AXI_wstrb(3 downto 0);
  m07_couplers_to_m07_couplers_WVALID(0) <= S_AXI_wvalid(0);
end STRUCTURE;
library IEEE;
use IEEE.STD_LOGIC_1164.ALL;
library UNISIM;
use UNISIM.VCOMPONENTS.ALL;
entity m08_couplers_imp_1VIC0G6 is
  port (
    M_ACLK : in STD_LOGIC;
    M_ARESETN : in STD_LOGIC;
    M_AXI_araddr : out STD_LOGIC_VECTOR ( 31 downto 0 );
    M_AXI_arready : in STD_LOGIC;
    M_AXI_arvalid : out STD_LOGIC;
    M_AXI_awaddr : out STD_LOGIC_VECTOR ( 31 downto 0 );
    M_AXI_awready : in STD_LOGIC;
    M_AXI_awvalid : out STD_LOGIC;
    M_AXI_bready : out STD_LOGIC;
    M_AXI_bresp : in STD_LOGIC_VECTOR ( 1 downto 0 );
    M_AXI_bvalid : in STD_LOGIC;
    M_AXI_rdata : in STD_LOGIC_VECTOR ( 31 downto 0 );
    M_AXI_rready : out STD_LOGIC;
    M_AXI_rresp : in STD_LOGIC_VECTOR ( 1 downto 0 );
    M_AXI_rvalid : in STD_LOGIC;
    M_AXI_wdata : out STD_LOGIC_VECTOR ( 31 downto 0 );
    M_AXI_wready : in STD_LOGIC;
    M_AXI_wstrb : out STD_LOGIC_VECTOR ( 3 downto 0 );
    M_AXI_wvalid : out STD_LOGIC;
    S_ACLK : in STD_LOGIC;
    S_ARESETN : in STD_LOGIC;
    S_AXI_araddr : in STD_LOGIC_VECTOR ( 31 downto 0 );
    S_AXI_arready : out STD_LOGIC;
    S_AXI_arvalid : in STD_LOGIC;
    S_AXI_awaddr : in STD_LOGIC_VECTOR ( 31 downto 0 );
    S_AXI_awready : out STD_LOGIC;
    S_AXI_awvalid : in STD_LOGIC;
    S_AXI_bready : in STD_LOGIC;
    S_AXI_bresp : out STD_LOGIC_VECTOR ( 1 downto 0 );
    S_AXI_bvalid : out STD_LOGIC;
    S_AXI_rdata : out STD_LOGIC_VECTOR ( 31 downto 0 );
    S_AXI_rready : in STD_LOGIC;
    S_AXI_rresp : out STD_LOGIC_VECTOR ( 1 downto 0 );
    S_AXI_rvalid : out STD_LOGIC;
    S_AXI_wdata : in STD_LOGIC_VECTOR ( 31 downto 0 );
    S_AXI_wready : out STD_LOGIC;
    S_AXI_wstrb : in STD_LOGIC_VECTOR ( 3 downto 0 );
    S_AXI_wvalid : in STD_LOGIC
  );
end m08_couplers_imp_1VIC0G6;

architecture STRUCTURE of m08_couplers_imp_1VIC0G6 is
  signal m08_couplers_to_m08_couplers_ARADDR : STD_LOGIC_VECTOR ( 31 downto 0 );
  signal m08_couplers_to_m08_couplers_ARREADY : STD_LOGIC;
  signal m08_couplers_to_m08_couplers_ARVALID : STD_LOGIC;
  signal m08_couplers_to_m08_couplers_AWADDR : STD_LOGIC_VECTOR ( 31 downto 0 );
  signal m08_couplers_to_m08_couplers_AWREADY : STD_LOGIC;
  signal m08_couplers_to_m08_couplers_AWVALID : STD_LOGIC;
  signal m08_couplers_to_m08_couplers_BREADY : STD_LOGIC;
  signal m08_couplers_to_m08_couplers_BRESP : STD_LOGIC_VECTOR ( 1 downto 0 );
  signal m08_couplers_to_m08_couplers_BVALID : STD_LOGIC;
  signal m08_couplers_to_m08_couplers_RDATA : STD_LOGIC_VECTOR ( 31 downto 0 );
  signal m08_couplers_to_m08_couplers_RREADY : STD_LOGIC;
  signal m08_couplers_to_m08_couplers_RRESP : STD_LOGIC_VECTOR ( 1 downto 0 );
  signal m08_couplers_to_m08_couplers_RVALID : STD_LOGIC;
  signal m08_couplers_to_m08_couplers_WDATA : STD_LOGIC_VECTOR ( 31 downto 0 );
  signal m08_couplers_to_m08_couplers_WREADY : STD_LOGIC;
  signal m08_couplers_to_m08_couplers_WSTRB : STD_LOGIC_VECTOR ( 3 downto 0 );
  signal m08_couplers_to_m08_couplers_WVALID : STD_LOGIC;
begin
  M_AXI_araddr(31 downto 0) <= m08_couplers_to_m08_couplers_ARADDR(31 downto 0);
  M_AXI_arvalid <= m08_couplers_to_m08_couplers_ARVALID;
  M_AXI_awaddr(31 downto 0) <= m08_couplers_to_m08_couplers_AWADDR(31 downto 0);
  M_AXI_awvalid <= m08_couplers_to_m08_couplers_AWVALID;
  M_AXI_bready <= m08_couplers_to_m08_couplers_BREADY;
  M_AXI_rready <= m08_couplers_to_m08_couplers_RREADY;
  M_AXI_wdata(31 downto 0) <= m08_couplers_to_m08_couplers_WDATA(31 downto 0);
  M_AXI_wstrb(3 downto 0) <= m08_couplers_to_m08_couplers_WSTRB(3 downto 0);
  M_AXI_wvalid <= m08_couplers_to_m08_couplers_WVALID;
  S_AXI_arready <= m08_couplers_to_m08_couplers_ARREADY;
  S_AXI_awready <= m08_couplers_to_m08_couplers_AWREADY;
  S_AXI_bresp(1 downto 0) <= m08_couplers_to_m08_couplers_BRESP(1 downto 0);
  S_AXI_bvalid <= m08_couplers_to_m08_couplers_BVALID;
  S_AXI_rdata(31 downto 0) <= m08_couplers_to_m08_couplers_RDATA(31 downto 0);
  S_AXI_rresp(1 downto 0) <= m08_couplers_to_m08_couplers_RRESP(1 downto 0);
  S_AXI_rvalid <= m08_couplers_to_m08_couplers_RVALID;
  S_AXI_wready <= m08_couplers_to_m08_couplers_WREADY;
  m08_couplers_to_m08_couplers_ARADDR(31 downto 0) <= S_AXI_araddr(31 downto 0);
  m08_couplers_to_m08_couplers_ARREADY <= M_AXI_arready;
  m08_couplers_to_m08_couplers_ARVALID <= S_AXI_arvalid;
  m08_couplers_to_m08_couplers_AWADDR(31 downto 0) <= S_AXI_awaddr(31 downto 0);
  m08_couplers_to_m08_couplers_AWREADY <= M_AXI_awready;
  m08_couplers_to_m08_couplers_AWVALID <= S_AXI_awvalid;
  m08_couplers_to_m08_couplers_BREADY <= S_AXI_bready;
  m08_couplers_to_m08_couplers_BRESP(1 downto 0) <= M_AXI_bresp(1 downto 0);
  m08_couplers_to_m08_couplers_BVALID <= M_AXI_bvalid;
  m08_couplers_to_m08_couplers_RDATA(31 downto 0) <= M_AXI_rdata(31 downto 0);
  m08_couplers_to_m08_couplers_RREADY <= S_AXI_rready;
  m08_couplers_to_m08_couplers_RRESP(1 downto 0) <= M_AXI_rresp(1 downto 0);
  m08_couplers_to_m08_couplers_RVALID <= M_AXI_rvalid;
  m08_couplers_to_m08_couplers_WDATA(31 downto 0) <= S_AXI_wdata(31 downto 0);
  m08_couplers_to_m08_couplers_WREADY <= M_AXI_wready;
  m08_couplers_to_m08_couplers_WSTRB(3 downto 0) <= S_AXI_wstrb(3 downto 0);
  m08_couplers_to_m08_couplers_WVALID <= S_AXI_wvalid;
end STRUCTURE;
library IEEE;
use IEEE.STD_LOGIC_1164.ALL;
library UNISIM;
use UNISIM.VCOMPONENTS.ALL;
entity microblaze_0_local_memory_imp_RJJ05W is
  port (
    DLMB_abus : in STD_LOGIC_VECTOR ( 0 to 31 );
    DLMB_addrstrobe : in STD_LOGIC;
    DLMB_be : in STD_LOGIC_VECTOR ( 0 to 3 );
    DLMB_ce : out STD_LOGIC;
    DLMB_readdbus : out STD_LOGIC_VECTOR ( 0 to 31 );
    DLMB_readstrobe : in STD_LOGIC;
    DLMB_ready : out STD_LOGIC;
    DLMB_ue : out STD_LOGIC;
    DLMB_wait : out STD_LOGIC;
    DLMB_writedbus : in STD_LOGIC_VECTOR ( 0 to 31 );
    DLMB_writestrobe : in STD_LOGIC;
    ILMB_abus : in STD_LOGIC_VECTOR ( 0 to 31 );
    ILMB_addrstrobe : in STD_LOGIC;
    ILMB_ce : out STD_LOGIC;
    ILMB_readdbus : out STD_LOGIC_VECTOR ( 0 to 31 );
    ILMB_readstrobe : in STD_LOGIC;
    ILMB_ready : out STD_LOGIC;
    ILMB_ue : out STD_LOGIC;
    ILMB_wait : out STD_LOGIC;
    LMB_Clk : in STD_LOGIC;
    SYS_Rst : in STD_LOGIC_VECTOR ( 0 to 0 )
  );
end microblaze_0_local_memory_imp_RJJ05W;
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
