aditya-167/SuperPong-FPGA/sw/videodemo/src/pong/pong.h

#ifndef PONG_H
#define PONG_H

#include <stdlib.h>
#include <stdio.h>
#include <stdbool.h>
#include <math.h>
#include <time.h>
#include "../utility/engine.h"
#include "sys/time.h"
#include "../graphics/graphics.h"
#include "xparameters.h"
#include "xtmrctr.h"
#include "xil_printf.h"
#include "PmodJSTK2.h"

#define UART_BASEADDR XPAR_UARTLITE_0_BASEADDR
#define TMRCTR_DEVICE_ID	XPAR_TMRCTR_0_DEVICE_ID
#define TIMER_COUNTER_0	 0

#define SCREEN_HEIGHT 480
#define SCREEN_WIDTH 640
#define BALLVEL 7
#define BALLSIZE 10
#define PLAYERPAD_WIDTH 10
#define PLAYERPAD_HEIGHT 100
#define PLAYERPAD_MARGIN 1
#define PLAYERPAD_VELOCITY 8
#define JOY_STEP 10

typedef enum GAME_STATE {
	RUNNING, PAUSED, STOPPED, RESET
} GAME_STATE;

// Ball structure
typedef struct ball_struct {
	int x;
	int y;
	int pX;
	int pY;
	int xVel;
	int yVel;
	int size;
} ball_struct;

// PlayerPad structure
typedef struct player_pad {
	int xPos;
	int yPos;
	int pX;
	int pY;
	int w;
	int h;
	int score;
	int r;
	int g;
	int b;
} player_pad;

// Game context structure
typedef struct game_context {

	player_pad* pad1;
	player_pad* pad2;
	ball_struct* ball;
	PmodJSTK2* player_1_joystick;
	PmodJSTK2* player_2_joystick;
	int camera_control;
	enum GAME_STATE previous_state;
	enum GAME_STATE state;

} game_context;

// Game functions
bool initialize(game_context* game, PmodJSTK2* player_1_joystick, PmodJSTK2* player_2_joystick);
void update(int t_elapse, game_context* game, graphics_context* gc);
void shutdown(game_context* game);
void scoreUpdate(int, int);
void clearScreen(graphics_context* gc);
int setup_stopwatch(XTmrCtr* TimerCounter);
void render_score(game_context* game, graphics_context* gc);
int start_stopwatch(XTmrCtr* TmrCtrInstancePtr);
int end_stopwatch(XTmrCtr* TmrCtrInstancePtr);
int get_number();

// Ball functions
void render_ball(game_context* game, graphics_context* gc);
void update_ball(game_context *game, GAME_STATE state, int t_elapse);
void check_interesections(game_context* g, graphics_context* gc);
ball_struct* init_ball(int size);

// Pad function
void update_CPU_pad(player_pad* pad2, ball_struct* ball, int t_elapse, int camera_controlled);
void update_player_pad(PmodJSTK2* player, player_pad* pad1, ball_struct* ball,
		int t_elapse);
void render_pads(game_context* game, graphics_context* gc);
player_pad* init_player_pad(void);

// Debugging
void print_state(game_context *g);

#endif
