aditya-167/SuperPong-FPGA/src/bd/hdmi/ip/hdmi_axi_vdma_0_0/hdmi_axi_vdma_0_0_stub.vhdl

-- Copyright 1986-2016 Xilinx, Inc. All Rights Reserved.
-- --------------------------------------------------------------------------------
-- Tool Version: Vivado v.2016.4 (win64) Build 1756540 Mon Jan 23 19:11:23 MST 2017
-- Date        : Sun Feb 19 15:34:39 2023
-- Host        : DESKTOP-RMQ09J8 running 64-bit major release  (build 9200)
-- Command     : write_vhdl -force -mode synth_stub
--               D:/Desktop/Angad/532/Video/Nexys-Video-HDMI-2016.4-2/Nexys-Video-HDMI/src/bd/hdmi/ip/hdmi_axi_vdma_0_0/hdmi_axi_vdma_0_0_stub.vhdl
-- Design      : hdmi_axi_vdma_0_0
-- Purpose     : Stub declaration of top-level module interface
-- Device      : xc7a200tsbg484-1
-- --------------------------------------------------------------------------------
library IEEE;
use IEEE.STD_LOGIC_1164.ALL;

entity hdmi_axi_vdma_0_0 is
  Port ( 
    s_axi_lite_aclk : in STD_LOGIC;
    m_axi_mm2s_aclk : in STD_LOGIC;
    m_axis_mm2s_aclk : in STD_LOGIC;
    m_axi_s2mm_aclk : in STD_LOGIC;
    s_axis_s2mm_aclk : in STD_LOGIC;
    axi_resetn : in STD_LOGIC;
    s_axi_lite_awvalid : in STD_LOGIC;
    s_axi_lite_awready : out STD_LOGIC;
    s_axi_lite_awaddr : in STD_LOGIC_VECTOR ( 8 downto 0 );
    s_axi_lite_wvalid : in STD_LOGIC;
    s_axi_lite_wready : out STD_LOGIC;
    s_axi_lite_wdata : in STD_LOGIC_VECTOR ( 31 downto 0 );
    s_axi_lite_bresp : out STD_LOGIC_VECTOR ( 1 downto 0 );
    s_axi_lite_bvalid : out STD_LOGIC;
    s_axi_lite_bready : in STD_LOGIC;
    s_axi_lite_arvalid : in STD_LOGIC;
    s_axi_lite_arready : out STD_LOGIC;
    s_axi_lite_araddr : in STD_LOGIC_VECTOR ( 8 downto 0 );
    s_axi_lite_rvalid : out STD_LOGIC;
    s_axi_lite_rready : in STD_LOGIC;
    s_axi_lite_rdata : out STD_LOGIC_VECTOR ( 31 downto 0 );
    s_axi_lite_rresp : out STD_LOGIC_VECTOR ( 1 downto 0 );
    mm2s_frame_ptr_out : out STD_LOGIC_VECTOR ( 5 downto 0 );
    s2mm_frame_ptr_out : out STD_LOGIC_VECTOR ( 5 downto 0 );
    m_axi_mm2s_araddr : out STD_LOGIC_VECTOR ( 31 downto 0 );
    m_axi_mm2s_arlen : out STD_LOGIC_VECTOR ( 7 downto 0 );
    m_axi_mm2s_arsize : out STD_LOGIC_VECTOR ( 2 downto 0 );
    m_axi_mm2s_arburst : out STD_LOGIC_VECTOR ( 1 downto 0 );
    m_axi_mm2s_arprot : out STD_LOGIC_VECTOR ( 2 downto 0 );
    m_axi_mm2s_arcache : out STD_LOGIC_VECTOR ( 3 downto 0 );
    m_axi_mm2s_arvalid : out STD_LOGIC;
    m_axi_mm2s_arready : in STD_LOGIC;
    m_axi_mm2s_rdata : in STD_LOGIC_VECTOR ( 127 downto 0 );
    m_axi_mm2s_rresp : in STD_LOGIC_VECTOR ( 1 downto 0 );
    m_axi_mm2s_rlast : in STD_LOGIC;
    m_axi_mm2s_rvalid : in STD_LOGIC;
    m_axi_mm2s_rready : out STD_LOGIC;
    m_axis_mm2s_tdata : out STD_LOGIC_VECTOR ( 23 downto 0 );
    m_axis_mm2s_tkeep : out STD_LOGIC_VECTOR ( 2 downto 0 );
    m_axis_mm2s_tuser : out STD_LOGIC_VECTOR ( 0 to 0 );
    m_axis_mm2s_tvalid : out STD_LOGIC;
    m_axis_mm2s_tready : in STD_LOGIC;
    m_axis_mm2s_tlast : out STD_LOGIC;
    m_axi_s2mm_awaddr : out STD_LOGIC_VECTOR ( 31 downto 0 );
    m_axi_s2mm_awlen : out STD_LOGIC_VECTOR ( 7 downto 0 );
    m_axi_s2mm_awsize : out STD_LOGIC_VECTOR ( 2 downto 0 );
    m_axi_s2mm_awburst : out STD_LOGIC_VECTOR ( 1 downto 0 );
    m_axi_s2mm_awprot : out STD_LOGIC_VECTOR ( 2 downto 0 );
    m_axi_s2mm_awcache : out STD_LOGIC_VECTOR ( 3 downto 0 );
    m_axi_s2mm_awvalid : out STD_LOGIC;
    m_axi_s2mm_awready : in STD_LOGIC;
    m_axi_s2mm_wdata : out STD_LOGIC_VECTOR ( 127 downto 0 );
    m_axi_s2mm_wstrb : out STD_LOGIC_VECTOR ( 15 downto 0 );
    m_axi_s2mm_wlast : out STD_LOGIC;
    m_axi_s2mm_wvalid : out STD_LOGIC;
    m_axi_s2mm_wready : in STD_LOGIC;
    m_axi_s2mm_bresp : in STD_LOGIC_VECTOR ( 1 downto 0 );
    m_axi_s2mm_bvalid : in STD_LOGIC;
    m_axi_s2mm_bready : out STD_LOGIC;
    s_axis_s2mm_tdata : in STD_LOGIC_VECTOR ( 23 downto 0 );
    s_axis_s2mm_tkeep : in STD_LOGIC_VECTOR ( 2 downto 0 );
    s_axis_s2mm_tuser : in STD_LOGIC_VECTOR ( 0 to 0 );
    s_axis_s2mm_tvalid : in STD_LOGIC;
    s_axis_s2mm_tready : out STD_LOGIC;
    s_axis_s2mm_tlast : in STD_LOGIC;
    mm2s_introut : out STD_LOGIC;
    s2mm_introut : out STD_LOGIC
  );

end hdmi_axi_vdma_0_0;

architecture stub of hdmi_axi_vdma_0_0 is
attribute syn_black_box : boolean;
attribute black_box_pad_pin : string;
attribute syn_black_box of stub : architecture is true;
attribute black_box_pad_pin of stub : architecture is "s_axi_lite_aclk,m_axi_mm2s_aclk,m_axis_mm2s_aclk,m_axi_s2mm_aclk,s_axis_s2mm_aclk,axi_resetn,s_axi_lite_awvalid,s_axi_lite_awready,s_axi_lite_awaddr[8:0],s_axi_lite_wvalid,s_axi_lite_wready,s_axi_lite_wdata[31:0],s_axi_lite_bresp[1:0],s_axi_lite_bvalid,s_axi_lite_bready,s_axi_lite_arvalid,s_axi_lite_arready,s_axi_lite_araddr[8:0],s_axi_lite_rvalid,s_axi_lite_rready,s_axi_lite_rdata[31:0],s_axi_lite_rresp[1:0],mm2s_frame_ptr_out[5:0],s2mm_frame_ptr_out[5:0],m_axi_mm2s_araddr[31:0],m_axi_mm2s_arlen[7:0],m_axi_mm2s_arsize[2:0],m_axi_mm2s_arburst[1:0],m_axi_mm2s_arprot[2:0],m_axi_mm2s_arcache[3:0],m_axi_mm2s_arvalid,m_axi_mm2s_arready,m_axi_mm2s_rdata[127:0],m_axi_mm2s_rresp[1:0],m_axi_mm2s_rlast,m_axi_mm2s_rvalid,m_axi_mm2s_rready,m_axis_mm2s_tdata[23:0],m_axis_mm2s_tkeep[2:0],m_axis_mm2s_tuser[0:0],m_axis_mm2s_tvalid,m_axis_mm2s_tready,m_axis_mm2s_tlast,m_axi_s2mm_awaddr[31:0],m_axi_s2mm_awlen[7:0],m_axi_s2mm_awsize[2:0],m_axi_s2mm_awburst[1:0],m_axi_s2mm_awprot[2:0],m_axi_s2mm_awcache[3:0],m_axi_s2mm_awvalid,m_axi_s2mm_awready,m_axi_s2mm_wdata[127:0],m_axi_s2mm_wstrb[15:0],m_axi_s2mm_wlast,m_axi_s2mm_wvalid,m_axi_s2mm_wready,m_axi_s2mm_bresp[1:0],m_axi_s2mm_bvalid,m_axi_s2mm_bready,s_axis_s2mm_tdata[23:0],s_axis_s2mm_tkeep[2:0],s_axis_s2mm_tuser[0:0],s_axis_s2mm_tvalid,s_axis_s2mm_tready,s_axis_s2mm_tlast,mm2s_introut,s2mm_introut";
attribute x_core_info : string;
attribute x_core_info of stub : architecture is "axi_vdma,Vivado 2016.4";
begin
end;
