aditya-167/SuperPong-FPGA/hw/HDMI.runs/hdmi_PmodJSTK2_0_1_synth_1/hdmi_PmodJSTK2_0_1_stub.v

// Copyright 1986-2016 Xilinx, Inc. All Rights Reserved.
// --------------------------------------------------------------------------------
// Tool Version: Vivado v.2016.4 (win64) Build 1756540 Mon Jan 23 19:11:23 MST 2017
// Date        : Thu Feb 23 23:05:28 2023
// Host        : SOL-WYPC2 running 64-bit major release  (build 9200)
// Command     : write_verilog -force -mode synth_stub -rename_top decalper_eb_ot_sdeen_pot_pi_dehcac_xnilix -prefix
//               decalper_eb_ot_sdeen_pot_pi_dehcac_xnilix_ hdmi_PmodJSTK2_0_1_stub.v
// Design      : hdmi_PmodJSTK2_0_1
// Purpose     : Stub declaration of top-level module interface
// Device      : xc7a200tsbg484-1
// --------------------------------------------------------------------------------

// This empty module with port declaration file causes synthesis tools to infer a black box for IP.
// The synthesis directives are for Synopsys Synplify support to prevent IO buffer insertion.
// Please paste the declaration into a Verilog source file or add the file as an additional source.
(* X_CORE_INFO = "PmodJSTK2,Vivado 2016.4" *)
module decalper_eb_ot_sdeen_pot_pi_dehcac_xnilix(AXI_LITE_SPI_araddr, AXI_LITE_SPI_arready, 
  AXI_LITE_SPI_arvalid, AXI_LITE_SPI_awaddr, AXI_LITE_SPI_awready, AXI_LITE_SPI_awvalid, 
  AXI_LITE_SPI_bready, AXI_LITE_SPI_bresp, AXI_LITE_SPI_bvalid, AXI_LITE_SPI_rdata, 
  AXI_LITE_SPI_rready, AXI_LITE_SPI_rresp, AXI_LITE_SPI_rvalid, AXI_LITE_SPI_wdata, 
  AXI_LITE_SPI_wready, AXI_LITE_SPI_wstrb, AXI_LITE_SPI_wvalid, Pmod_out_pin10_i, 
  Pmod_out_pin10_o, Pmod_out_pin10_t, Pmod_out_pin1_i, Pmod_out_pin1_o, Pmod_out_pin1_t, 
  Pmod_out_pin2_i, Pmod_out_pin2_o, Pmod_out_pin2_t, Pmod_out_pin3_i, Pmod_out_pin3_o, 
  Pmod_out_pin3_t, Pmod_out_pin4_i, Pmod_out_pin4_o, Pmod_out_pin4_t, Pmod_out_pin7_i, 
  Pmod_out_pin7_o, Pmod_out_pin7_t, Pmod_out_pin8_i, Pmod_out_pin8_o, Pmod_out_pin8_t, 
  Pmod_out_pin9_i, Pmod_out_pin9_o, Pmod_out_pin9_t, ext_spi_clk, s_axi_aclk, s_axi_aresetn)
/* synthesis syn_black_box black_box_pad_pin="AXI_LITE_SPI_araddr[6:0],AXI_LITE_SPI_arready,AXI_LITE_SPI_arvalid,AXI_LITE_SPI_awaddr[6:0],AXI_LITE_SPI_awready,AXI_LITE_SPI_awvalid,AXI_LITE_SPI_bready,AXI_LITE_SPI_bresp[1:0],AXI_LITE_SPI_bvalid,AXI_LITE_SPI_rdata[31:0],AXI_LITE_SPI_rready,AXI_LITE_SPI_rresp[1:0],AXI_LITE_SPI_rvalid,AXI_LITE_SPI_wdata[31:0],AXI_LITE_SPI_wready,AXI_LITE_SPI_wstrb[3:0],AXI_LITE_SPI_wvalid,Pmod_out_pin10_i,Pmod_out_pin10_o,Pmod_out_pin10_t,Pmod_out_pin1_i,Pmod_out_pin1_o,Pmod_out_pin1_t,Pmod_out_pin2_i,Pmod_out_pin2_o,Pmod_out_pin2_t,Pmod_out_pin3_i,Pmod_out_pin3_o,Pmod_out_pin3_t,Pmod_out_pin4_i,Pmod_out_pin4_o,Pmod_out_pin4_t,Pmod_out_pin7_i,Pmod_out_pin7_o,Pmod_out_pin7_t,Pmod_out_pin8_i,Pmod_out_pin8_o,Pmod_out_pin8_t,Pmod_out_pin9_i,Pmod_out_pin9_o,Pmod_out_pin9_t,ext_spi_clk,s_axi_aclk,s_axi_aresetn" */;
  input [6:0]AXI_LITE_SPI_araddr;
  output AXI_LITE_SPI_arready;
  input AXI_LITE_SPI_arvalid;
  input [6:0]AXI_LITE_SPI_awaddr;
  output AXI_LITE_SPI_awready;
  input AXI_LITE_SPI_awvalid;
  input AXI_LITE_SPI_bready;
  output [1:0]AXI_LITE_SPI_bresp;
  output AXI_LITE_SPI_bvalid;
  output [31:0]AXI_LITE_SPI_rdata;
  input AXI_LITE_SPI_rready;
  output [1:0]AXI_LITE_SPI_rresp;
  output AXI_LITE_SPI_rvalid;
  input [31:0]AXI_LITE_SPI_wdata;
  output AXI_LITE_SPI_wready;
  input [3:0]AXI_LITE_SPI_wstrb;
  input AXI_LITE_SPI_wvalid;
  input Pmod_out_pin10_i;
  output Pmod_out_pin10_o;
  output Pmod_out_pin10_t;
  input Pmod_out_pin1_i;
  output Pmod_out_pin1_o;
  output Pmod_out_pin1_t;
  input Pmod_out_pin2_i;
  output Pmod_out_pin2_o;
  output Pmod_out_pin2_t;
  input Pmod_out_pin3_i;
  output Pmod_out_pin3_o;
  output Pmod_out_pin3_t;
  input Pmod_out_pin4_i;
  output Pmod_out_pin4_o;
  output Pmod_out_pin4_t;
  input Pmod_out_pin7_i;
  output Pmod_out_pin7_o;
  output Pmod_out_pin7_t;
  input Pmod_out_pin8_i;
  output Pmod_out_pin8_o;
  output Pmod_out_pin8_t;
  input Pmod_out_pin9_i;
  output Pmod_out_pin9_o;
  output Pmod_out_pin9_t;
  input ext_spi_clk;
  input s_axi_aclk;
  input s_axi_aresetn;
endmodule
