aditya-167/SuperPong-FPGA/hw/HDMI.runs/hdmi_PmodJSTK2_0_1_synth_1/hdmi_PmodJSTK2_0_1_stub.vhdl

-- Copyright 1986-2016 Xilinx, Inc. All Rights Reserved.
-- --------------------------------------------------------------------------------
-- Tool Version: Vivado v.2016.4 (win64) Build 1756540 Mon Jan 23 19:11:23 MST 2017
-- Date        : Thu Feb 23 23:05:28 2023
-- Host        : SOL-WYPC2 running 64-bit major release  (build 9200)
-- Command     : write_vhdl -force -mode synth_stub -rename_top decalper_eb_ot_sdeen_pot_pi_dehcac_xnilix -prefix
--               decalper_eb_ot_sdeen_pot_pi_dehcac_xnilix_ hdmi_PmodJSTK2_0_1_stub.vhdl
-- Design      : hdmi_PmodJSTK2_0_1
-- Purpose     : Stub declaration of top-level module interface
-- Device      : xc7a200tsbg484-1
-- --------------------------------------------------------------------------------
library IEEE;
use IEEE.STD_LOGIC_1164.ALL;

entity decalper_eb_ot_sdeen_pot_pi_dehcac_xnilix is
  Port ( 
    AXI_LITE_SPI_araddr : in STD_LOGIC_VECTOR ( 6 downto 0 );
    AXI_LITE_SPI_arready : out STD_LOGIC;
    AXI_LITE_SPI_arvalid : in STD_LOGIC;
    AXI_LITE_SPI_awaddr : in STD_LOGIC_VECTOR ( 6 downto 0 );
    AXI_LITE_SPI_awready : out STD_LOGIC;
    AXI_LITE_SPI_awvalid : in STD_LOGIC;
    AXI_LITE_SPI_bready : in STD_LOGIC;
    AXI_LITE_SPI_bresp : out STD_LOGIC_VECTOR ( 1 downto 0 );
    AXI_LITE_SPI_bvalid : out STD_LOGIC;
    AXI_LITE_SPI_rdata : out STD_LOGIC_VECTOR ( 31 downto 0 );
    AXI_LITE_SPI_rready : in STD_LOGIC;
    AXI_LITE_SPI_rresp : out STD_LOGIC_VECTOR ( 1 downto 0 );
    AXI_LITE_SPI_rvalid : out STD_LOGIC;
    AXI_LITE_SPI_wdata : in STD_LOGIC_VECTOR ( 31 downto 0 );
    AXI_LITE_SPI_wready : out STD_LOGIC;
    AXI_LITE_SPI_wstrb : in STD_LOGIC_VECTOR ( 3 downto 0 );
    AXI_LITE_SPI_wvalid : in STD_LOGIC;
    Pmod_out_pin10_i : in STD_LOGIC;
    Pmod_out_pin10_o : out STD_LOGIC;
    Pmod_out_pin10_t : out STD_LOGIC;
    Pmod_out_pin1_i : in STD_LOGIC;
    Pmod_out_pin1_o : out STD_LOGIC;
    Pmod_out_pin1_t : out STD_LOGIC;
    Pmod_out_pin2_i : in STD_LOGIC;
    Pmod_out_pin2_o : out STD_LOGIC;
    Pmod_out_pin2_t : out STD_LOGIC;
    Pmod_out_pin3_i : in STD_LOGIC;
    Pmod_out_pin3_o : out STD_LOGIC;
    Pmod_out_pin3_t : out STD_LOGIC;
    Pmod_out_pin4_i : in STD_LOGIC;
    Pmod_out_pin4_o : out STD_LOGIC;
    Pmod_out_pin4_t : out STD_LOGIC;
    Pmod_out_pin7_i : in STD_LOGIC;
    Pmod_out_pin7_o : out STD_LOGIC;
    Pmod_out_pin7_t : out STD_LOGIC;
    Pmod_out_pin8_i : in STD_LOGIC;
    Pmod_out_pin8_o : out STD_LOGIC;
    Pmod_out_pin8_t : out STD_LOGIC;
    Pmod_out_pin9_i : in STD_LOGIC;
    Pmod_out_pin9_o : out STD_LOGIC;
    Pmod_out_pin9_t : out STD_LOGIC;
    ext_spi_clk : in STD_LOGIC;
    s_axi_aclk : in STD_LOGIC;
    s_axi_aresetn : in STD_LOGIC
  );

end decalper_eb_ot_sdeen_pot_pi_dehcac_xnilix;

architecture stub of decalper_eb_ot_sdeen_pot_pi_dehcac_xnilix is
attribute syn_black_box : boolean;
attribute black_box_pad_pin : string;
attribute syn_black_box of stub : architecture is true;
attribute black_box_pad_pin of stub : architecture is "AXI_LITE_SPI_araddr[6:0],AXI_LITE_SPI_arready,AXI_LITE_SPI_arvalid,AXI_LITE_SPI_awaddr[6:0],AXI_LITE_SPI_awready,AXI_LITE_SPI_awvalid,AXI_LITE_SPI_bready,AXI_LITE_SPI_bresp[1:0],AXI_LITE_SPI_bvalid,AXI_LITE_SPI_rdata[31:0],AXI_LITE_SPI_rready,AXI_LITE_SPI_rresp[1:0],AXI_LITE_SPI_rvalid,AXI_LITE_SPI_wdata[31:0],AXI_LITE_SPI_wready,AXI_LITE_SPI_wstrb[3:0],AXI_LITE_SPI_wvalid,Pmod_out_pin10_i,Pmod_out_pin10_o,Pmod_out_pin10_t,Pmod_out_pin1_i,Pmod_out_pin1_o,Pmod_out_pin1_t,Pmod_out_pin2_i,Pmod_out_pin2_o,Pmod_out_pin2_t,Pmod_out_pin3_i,Pmod_out_pin3_o,Pmod_out_pin3_t,Pmod_out_pin4_i,Pmod_out_pin4_o,Pmod_out_pin4_t,Pmod_out_pin7_i,Pmod_out_pin7_o,Pmod_out_pin7_t,Pmod_out_pin8_i,Pmod_out_pin8_o,Pmod_out_pin8_t,Pmod_out_pin9_i,Pmod_out_pin9_o,Pmod_out_pin9_t,ext_spi_clk,s_axi_aclk,s_axi_aresetn";
attribute X_CORE_INFO : string;
attribute X_CORE_INFO of stub : architecture is "PmodJSTK2,Vivado 2016.4";
begin
end;
