aditya-167/SuperPong-FPGA/src/bd/hdmi/ip/hdmi_axi_dynclk_0_0/hdmi_axi_dynclk_0_0_stub.v

// Copyright 1986-2016 Xilinx, Inc. All Rights Reserved.
// --------------------------------------------------------------------------------
// Tool Version: Vivado v.2016.4 (win64) Build 1756540 Mon Jan 23 19:11:23 MST 2017
// Date        : Sun Feb 19 15:35:56 2023
// Host        : DESKTOP-RMQ09J8 running 64-bit major release  (build 9200)
// Command     : write_verilog -force -mode synth_stub
//               D:/Desktop/Angad/532/Video/Nexys-Video-HDMI-2016.4-2/Nexys-Video-HDMI/src/bd/hdmi/ip/hdmi_axi_dynclk_0_0/hdmi_axi_dynclk_0_0_stub.v
// Design      : hdmi_axi_dynclk_0_0
// Purpose     : Stub declaration of top-level module interface
// Device      : xc7a200tsbg484-1
// --------------------------------------------------------------------------------

// This empty module with port declaration file causes synthesis tools to infer a black box for IP.
// The synthesis directives are for Synopsys Synplify support to prevent IO buffer insertion.
// Please paste the declaration into a Verilog source file or add the file as an additional source.
(* x_core_info = "axi_dynclk,Vivado 2016.4" *)
module hdmi_axi_dynclk_0_0(REF_CLK_I, PXL_CLK_O, PXL_CLK_5X_O, LOCKED_O, 
  s00_axi_aclk, s00_axi_aresetn, s00_axi_awaddr, s00_axi_awprot, s00_axi_awvalid, 
  s00_axi_awready, s00_axi_wdata, s00_axi_wstrb, s00_axi_wvalid, s00_axi_wready, 
  s00_axi_bresp, s00_axi_bvalid, s00_axi_bready, s00_axi_araddr, s00_axi_arprot, 
  s00_axi_arvalid, s00_axi_arready, s00_axi_rdata, s00_axi_rresp, s00_axi_rvalid, 
  s00_axi_rready)
/* synthesis syn_black_box black_box_pad_pin="REF_CLK_I,PXL_CLK_O,PXL_CLK_5X_O,LOCKED_O,s00_axi_aclk,s00_axi_aresetn,s00_axi_awaddr[4:0],s00_axi_awprot[2:0],s00_axi_awvalid,s00_axi_awready,s00_axi_wdata[31:0],s00_axi_wstrb[3:0],s00_axi_wvalid,s00_axi_wready,s00_axi_bresp[1:0],s00_axi_bvalid,s00_axi_bready,s00_axi_araddr[4:0],s00_axi_arprot[2:0],s00_axi_arvalid,s00_axi_arready,s00_axi_rdata[31:0],s00_axi_rresp[1:0],s00_axi_rvalid,s00_axi_rready" */;
  input REF_CLK_I;
  output PXL_CLK_O;
  output PXL_CLK_5X_O;
  output LOCKED_O;
  input s00_axi_aclk;
  input s00_axi_aresetn;
  input [4:0]s00_axi_awaddr;
  input [2:0]s00_axi_awprot;
  input s00_axi_awvalid;
  output s00_axi_awready;
  input [31:0]s00_axi_wdata;
  input [3:0]s00_axi_wstrb;
  input s00_axi_wvalid;
  output s00_axi_wready;
  output [1:0]s00_axi_bresp;
  output s00_axi_bvalid;
  input s00_axi_bready;
  input [4:0]s00_axi_araddr;
  input [2:0]s00_axi_arprot;
  input s00_axi_arvalid;
  output s00_axi_arready;
  output [31:0]s00_axi_rdata;
  output [1:0]s00_axi_rresp;
  output s00_axi_rvalid;
  input s00_axi_rready;
endmodule
