aditya-167/SuperPong-FPGA/src/bd/hdmi/ip/hdmi_dvi2rgb_0_0/hdmi_dvi2rgb_0_0_stub.vhdl

-- Copyright 1986-2016 Xilinx, Inc. All Rights Reserved.
-- --------------------------------------------------------------------------------
-- Tool Version: Vivado v.2016.4 (win64) Build 1756540 Mon Jan 23 19:11:23 MST 2017
-- Date        : Sun Feb 19 15:22:31 2023
-- Host        : DESKTOP-RMQ09J8 running 64-bit major release  (build 9200)
-- Command     : write_vhdl -force -mode synth_stub
--               D:/Desktop/Angad/532/Video/Nexys-Video-HDMI-2016.4-2/Nexys-Video-HDMI/src/bd/hdmi/ip/hdmi_dvi2rgb_0_0/hdmi_dvi2rgb_0_0_stub.vhdl
-- Design      : hdmi_dvi2rgb_0_0
-- Purpose     : Stub declaration of top-level module interface
-- Device      : xc7a200tsbg484-1
-- --------------------------------------------------------------------------------
library IEEE;
use IEEE.STD_LOGIC_1164.ALL;

entity hdmi_dvi2rgb_0_0 is
  Port ( 
    TMDS_Clk_p : in STD_LOGIC;
    TMDS_Clk_n : in STD_LOGIC;
    TMDS_Data_p : in STD_LOGIC_VECTOR ( 2 downto 0 );
    TMDS_Data_n : in STD_LOGIC_VECTOR ( 2 downto 0 );
    RefClk : in STD_LOGIC;
    aRst_n : in STD_LOGIC;
    vid_pData : out STD_LOGIC_VECTOR ( 23 downto 0 );
    vid_pVDE : out STD_LOGIC;
    vid_pHSync : out STD_LOGIC;
    vid_pVSync : out STD_LOGIC;
    PixelClk : out STD_LOGIC;
    aPixelClkLckd : out STD_LOGIC;
    DDC_SDA_I : in STD_LOGIC;
    DDC_SDA_O : out STD_LOGIC;
    DDC_SDA_T : out STD_LOGIC;
    DDC_SCL_I : in STD_LOGIC;
    DDC_SCL_O : out STD_LOGIC;
    DDC_SCL_T : out STD_LOGIC;
    pRst_n : in STD_LOGIC
  );

end hdmi_dvi2rgb_0_0;

architecture stub of hdmi_dvi2rgb_0_0 is
attribute syn_black_box : boolean;
attribute black_box_pad_pin : string;
attribute syn_black_box of stub : architecture is true;
attribute black_box_pad_pin of stub : architecture is "TMDS_Clk_p,TMDS_Clk_n,TMDS_Data_p[2:0],TMDS_Data_n[2:0],RefClk,aRst_n,vid_pData[23:0],vid_pVDE,vid_pHSync,vid_pVSync,PixelClk,aPixelClkLckd,DDC_SDA_I,DDC_SDA_O,DDC_SDA_T,DDC_SCL_I,DDC_SCL_O,DDC_SCL_T,pRst_n";
attribute x_core_info : string;
attribute x_core_info of stub : architecture is "dvi2rgb,Vivado 2016.4";
begin
end;
