aditya-167/SuperPong-FPGA/src/bd/hdmi/ip/hdmi_microblaze_0_axi_intc_0/hdmi_microblaze_0_axi_intc_0_stub.vhdl

-- Copyright 1986-2016 Xilinx, Inc. All Rights Reserved.
-- --------------------------------------------------------------------------------
-- Tool Version: Vivado v.2016.4 (win64) Build 1756540 Mon Jan 23 19:11:23 MST 2017
-- Date        : Sun Feb 19 15:56:14 2023
-- Host        : DESKTOP-RMQ09J8 running 64-bit major release  (build 9200)
-- Command     : write_vhdl -force -mode synth_stub
--               D:/Desktop/Angad/532/Video/Nexys-Video-HDMI-2016.4-2/Nexys-Video-HDMI/src/bd/hdmi/ip/hdmi_microblaze_0_axi_intc_0/hdmi_microblaze_0_axi_intc_0_stub.vhdl
-- Design      : hdmi_microblaze_0_axi_intc_0
-- Purpose     : Stub declaration of top-level module interface
-- Device      : xc7a200tsbg484-1
-- --------------------------------------------------------------------------------
library IEEE;
use IEEE.STD_LOGIC_1164.ALL;

entity hdmi_microblaze_0_axi_intc_0 is
  Port ( 
    s_axi_aclk : in STD_LOGIC;
    s_axi_aresetn : in STD_LOGIC;
    s_axi_awaddr : in STD_LOGIC_VECTOR ( 8 downto 0 );
    s_axi_awvalid : in STD_LOGIC;
    s_axi_awready : out STD_LOGIC;
    s_axi_wdata : in STD_LOGIC_VECTOR ( 31 downto 0 );
    s_axi_wstrb : in STD_LOGIC_VECTOR ( 3 downto 0 );
    s_axi_wvalid : in STD_LOGIC;
    s_axi_wready : out STD_LOGIC;
    s_axi_bresp : out STD_LOGIC_VECTOR ( 1 downto 0 );
    s_axi_bvalid : out STD_LOGIC;
    s_axi_bready : in STD_LOGIC;
    s_axi_araddr : in STD_LOGIC_VECTOR ( 8 downto 0 );
    s_axi_arvalid : in STD_LOGIC;
    s_axi_arready : out STD_LOGIC;
    s_axi_rdata : out STD_LOGIC_VECTOR ( 31 downto 0 );
    s_axi_rresp : out STD_LOGIC_VECTOR ( 1 downto 0 );
    s_axi_rvalid : out STD_LOGIC;
    s_axi_rready : in STD_LOGIC;
    intr : in STD_LOGIC_VECTOR ( 5 downto 0 );
    processor_clk : in STD_LOGIC;
    processor_rst : in STD_LOGIC;
    irq : out STD_LOGIC;
    processor_ack : in STD_LOGIC_VECTOR ( 1 downto 0 );
    interrupt_address : out STD_LOGIC_VECTOR ( 31 downto 0 )
  );

end hdmi_microblaze_0_axi_intc_0;

architecture stub of hdmi_microblaze_0_axi_intc_0 is
attribute syn_black_box : boolean;
attribute black_box_pad_pin : string;
attribute syn_black_box of stub : architecture is true;
attribute black_box_pad_pin of stub : architecture is "s_axi_aclk,s_axi_aresetn,s_axi_awaddr[8:0],s_axi_awvalid,s_axi_awready,s_axi_wdata[31:0],s_axi_wstrb[3:0],s_axi_wvalid,s_axi_wready,s_axi_bresp[1:0],s_axi_bvalid,s_axi_bready,s_axi_araddr[8:0],s_axi_arvalid,s_axi_arready,s_axi_rdata[31:0],s_axi_rresp[1:0],s_axi_rvalid,s_axi_rready,intr[5:0],processor_clk,processor_rst,irq,processor_ack[1:0],interrupt_address[31:0]";
attribute x_core_info : string;
attribute x_core_info of stub : architecture is "axi_intc,Vivado 2016.4";
begin
end;
