aditya-167/SuperPong-FPGA/src/bd/hdmi/ip/hdmi_v_axi4s_vid_out_0_0/hdmi_v_axi4s_vid_out_0_0_stub.vhdl

-- Copyright 1986-2016 Xilinx, Inc. All Rights Reserved.
-- --------------------------------------------------------------------------------
-- Tool Version: Vivado v.2016.4 (win64) Build 1756540 Mon Jan 23 19:11:23 MST 2017
-- Date        : Sun Feb 19 15:43:11 2023
-- Host        : DESKTOP-RMQ09J8 running 64-bit major release  (build 9200)
-- Command     : write_vhdl -force -mode synth_stub
--               D:/Desktop/Angad/532/Video/Nexys-Video-HDMI-2016.4-2/Nexys-Video-HDMI/src/bd/hdmi/ip/hdmi_v_axi4s_vid_out_0_0/hdmi_v_axi4s_vid_out_0_0_stub.vhdl
-- Design      : hdmi_v_axi4s_vid_out_0_0
-- Purpose     : Stub declaration of top-level module interface
-- Device      : xc7a200tsbg484-1
-- --------------------------------------------------------------------------------
library IEEE;
use IEEE.STD_LOGIC_1164.ALL;

entity hdmi_v_axi4s_vid_out_0_0 is
  Port ( 
    aclk : in STD_LOGIC;
    aclken : in STD_LOGIC;
    aresetn : in STD_LOGIC;
    s_axis_video_tdata : in STD_LOGIC_VECTOR ( 23 downto 0 );
    s_axis_video_tvalid : in STD_LOGIC;
    s_axis_video_tready : out STD_LOGIC;
    s_axis_video_tuser : in STD_LOGIC;
    s_axis_video_tlast : in STD_LOGIC;
    fid : in STD_LOGIC;
    vid_io_out_ce : in STD_LOGIC;
    vid_active_video : out STD_LOGIC;
    vid_vsync : out STD_LOGIC;
    vid_hsync : out STD_LOGIC;
    vid_vblank : out STD_LOGIC;
    vid_hblank : out STD_LOGIC;
    vid_field_id : out STD_LOGIC;
    vid_data : out STD_LOGIC_VECTOR ( 23 downto 0 );
    vtg_vsync : in STD_LOGIC;
    vtg_hsync : in STD_LOGIC;
    vtg_vblank : in STD_LOGIC;
    vtg_hblank : in STD_LOGIC;
    vtg_active_video : in STD_LOGIC;
    vtg_field_id : in STD_LOGIC;
    vtg_ce : out STD_LOGIC;
    locked : out STD_LOGIC;
    overflow : out STD_LOGIC;
    underflow : out STD_LOGIC;
    status : out STD_LOGIC_VECTOR ( 31 downto 0 )
  );

end hdmi_v_axi4s_vid_out_0_0;

architecture stub of hdmi_v_axi4s_vid_out_0_0 is
attribute syn_black_box : boolean;
attribute black_box_pad_pin : string;
attribute syn_black_box of stub : architecture is true;
attribute black_box_pad_pin of stub : architecture is "aclk,aclken,aresetn,s_axis_video_tdata[23:0],s_axis_video_tvalid,s_axis_video_tready,s_axis_video_tuser,s_axis_video_tlast,fid,vid_io_out_ce,vid_active_video,vid_vsync,vid_hsync,vid_vblank,vid_hblank,vid_field_id,vid_data[23:0],vtg_vsync,vtg_hsync,vtg_vblank,vtg_hblank,vtg_active_video,vtg_field_id,vtg_ce,locked,overflow,underflow,status[31:0]";
attribute X_CORE_INFO : string;
attribute X_CORE_INFO of stub : architecture is "v_axi4s_vid_out_v4_0_5,Vivado 2016.4";
begin
end;
