aditya-167/SuperPong-FPGA/src/bd/hdmi/ip/hdmi_v_vid_in_axi4s_0_0/hdmi_v_vid_in_axi4s_0_0_stub.vhdl

-- Copyright 1986-2016 Xilinx, Inc. All Rights Reserved.
-- --------------------------------------------------------------------------------
-- Tool Version: Vivado v.2016.4 (win64) Build 1756540 Mon Jan 23 19:11:23 MST 2017
-- Date        : Sun Feb 19 15:53:20 2023
-- Host        : DESKTOP-RMQ09J8 running 64-bit major release  (build 9200)
-- Command     : write_vhdl -force -mode synth_stub
--               D:/Desktop/Angad/532/Video/Nexys-Video-HDMI-2016.4-2/Nexys-Video-HDMI/src/bd/hdmi/ip/hdmi_v_vid_in_axi4s_0_0/hdmi_v_vid_in_axi4s_0_0_stub.vhdl
-- Design      : hdmi_v_vid_in_axi4s_0_0
-- Purpose     : Stub declaration of top-level module interface
-- Device      : xc7a200tsbg484-1
-- --------------------------------------------------------------------------------
library IEEE;
use IEEE.STD_LOGIC_1164.ALL;

entity hdmi_v_vid_in_axi4s_0_0 is
  Port ( 
    vid_io_in_clk : in STD_LOGIC;
    vid_io_in_ce : in STD_LOGIC;
    vid_io_in_reset : in STD_LOGIC;
    vid_active_video : in STD_LOGIC;
    vid_vblank : in STD_LOGIC;
    vid_hblank : in STD_LOGIC;
    vid_vsync : in STD_LOGIC;
    vid_hsync : in STD_LOGIC;
    vid_field_id : in STD_LOGIC;
    vid_data : in STD_LOGIC_VECTOR ( 23 downto 0 );
    aclk : in STD_LOGIC;
    aclken : in STD_LOGIC;
    aresetn : in STD_LOGIC;
    m_axis_video_tdata : out STD_LOGIC_VECTOR ( 23 downto 0 );
    m_axis_video_tvalid : out STD_LOGIC;
    m_axis_video_tready : in STD_LOGIC;
    m_axis_video_tuser : out STD_LOGIC;
    m_axis_video_tlast : out STD_LOGIC;
    fid : out STD_LOGIC;
    vtd_active_video : out STD_LOGIC;
    vtd_vblank : out STD_LOGIC;
    vtd_hblank : out STD_LOGIC;
    vtd_vsync : out STD_LOGIC;
    vtd_hsync : out STD_LOGIC;
    vtd_field_id : out STD_LOGIC;
    overflow : out STD_LOGIC;
    underflow : out STD_LOGIC;
    axis_enable : in STD_LOGIC
  );

end hdmi_v_vid_in_axi4s_0_0;

architecture stub of hdmi_v_vid_in_axi4s_0_0 is
attribute syn_black_box : boolean;
attribute black_box_pad_pin : string;
attribute syn_black_box of stub : architecture is true;
attribute black_box_pad_pin of stub : architecture is "vid_io_in_clk,vid_io_in_ce,vid_io_in_reset,vid_active_video,vid_vblank,vid_hblank,vid_vsync,vid_hsync,vid_field_id,vid_data[23:0],aclk,aclken,aresetn,m_axis_video_tdata[23:0],m_axis_video_tvalid,m_axis_video_tready,m_axis_video_tuser,m_axis_video_tlast,fid,vtd_active_video,vtd_vblank,vtd_hblank,vtd_vsync,vtd_hsync,vtd_field_id,overflow,underflow,axis_enable";
attribute X_CORE_INFO : string;
attribute X_CORE_INFO of stub : architecture is "v_vid_in_axi4s_v4_0_5,Vivado 2016.4";
begin
end;
