aditya-167/SuperPong-FPGA/src/bd/hdmi/ip/hdmi_mig_7series_1_0/hdmi_mig_7series_1_0/user_design/rtl/ip_top/mig_7series_v4_0_memc_ui_top_axi.v

//*****************************************************************************
// (c) Copyright 2009 - 2014 Xilinx, Inc. All rights reserved.
//
// This file contains confidential and proprietary information
// of Xilinx, Inc. and is protected under U.S. and
// international copyright and other intellectual property
// laws.
//
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
// CRITICAL APPLICATIONS
// Xilinx products are not designed or intended to be fail-
// safe, or for use in any application requiring fail-safe
// performance, such as life-support or safety devices or
// systems, Class III medical devices, nuclear facilities,
// applications related to the deployment of airbags, or any
// other applications that could lead to death, personal
// injury, or severe property or environmental damage
// (individually and collectively, "Critical
// Applications"). Customer assumes the sole risk and
// liability of any use of Xilinx products in Critical
// Applications, subject only to applicable laws and
// regulations governing limitations on product liability.
//
// THIS COPYRIGHT NOTICE AND DISCLAIMER MUST BE RETAINED AS
// PART OF THIS FILE AT ALL TIMES.
//
//*****************************************************************************
//   ____  ____
//  /   /\/   /
// /___/  \  /    Vendor             : Xilinx
// \   \   \/     Version            : 3.6
//  \   \         Application        : MIG
//  /   /         Filename           : memc_ui_top_axi.v
// /___/   /\     Date Last Modified : $Date: 2011/06/02 08:35:04 $
// \   \  /  \    Date Created       : Fri Oct 08 2010
//  \___\/\___\
//
// Device           : 7 Series
// Design Name      : DDR2 SDRAM & DDR3 SDRAM
// Purpose          :
//                   Top level memory interface block. Instantiates a clock and
//                   reset generator, the memory controller, the phy and the
//                   user interface blocks.
// Reference        :
// Revision History :
//*****************************************************************************

`timescale 1 ps / 1 ps

(* X_CORE_INFO = "mig_7series_v4_0_ddr3_7Series, hdmi_mig_7series_1_0, 2016.2" , CORE_GENERATION_INFO = "ddr3_7Series,mig_7series_v4_0,{LANGUAGE=Verilog, SYNTHESIS_TOOL=Vivado, LEVEL=CONTROLLER, AXI_ENABLE=1, NO_OF_CONTROLLERS=1, INTERFACE_TYPE=DDR3, AXI_ENABLE=1, CLK_PERIOD=2500, PHY_RATIO=4, CLKIN_PERIOD=5000, VCCAUX_IO=1.8V, MEMORY_TYPE=COMP, MEMORY_PART=mt41k256m16xx-125, DQ_WIDTH=16, ECC=OFF, DATA_MASK=1, ORDERING=NORM, BURST_MODE=8, BURST_TYPE=SEQ, CA_MIRROR=OFF, OUTPUT_DRV=HIGH, USE_CS_PORT=0, USE_ODT_PORT=1, RTT_NOM=40, MEMORY_ADDRESS_MAP=BANK_ROW_COLUMN, REFCLK_FREQ=200, DEBUG_PORT=OFF, INTERNAL_VREF=1, SYSCLK_TYPE=NO_BUFFER, REFCLK_TYPE=USE_SYSTEM_CLOCK}" *)
module mig_7series_v4_0_memc_ui_top_axi #
  (
   parameter TCQ                   = 100,
   parameter DDR3_VDD_OP_VOLT      = "135",     // Voltage mode used for DDR3
   parameter PAYLOAD_WIDTH         = 64,
   parameter ADDR_CMD_MODE         = "UNBUF",
   parameter AL                    = "0",     // Additive Latency option
   parameter BANK_WIDTH            = 3,       // # of bank bits
   parameter BM_CNT_WIDTH          = 2,       // Bank machine counter width
   parameter BURST_MODE            = "8",     // Burst length
   parameter BURST_TYPE            = "SEQ",   // Burst type
   parameter CA_MIRROR             = "OFF",   // C/A mirror opt for DDR3 dual rank
   parameter CK_WIDTH              = 1,       // # of CK/CK# outputs to memory
   parameter CL                    = 5,
   parameter COL_WIDTH             = 12,      // column address width
   parameter CMD_PIPE_PLUS1        = "ON",    // add pipeline stage between MC and PHY
   parameter CS_WIDTH              = 1,       // # of unique CS outputs
   parameter CKE_WIDTH             = 1,       // # of cke outputs
   parameter CWL                   = 5,
   parameter DATA_WIDTH            = 64,
   parameter DATA_BUF_ADDR_WIDTH   = 5,
   parameter DATA_BUF_OFFSET_WIDTH = 1,
   parameter DDR2_DQSN_ENABLE      = "YES",   // Enable differential DQS for DDR2
   parameter DM_WIDTH              = 8,       // # of DM (data mask)
   parameter DQ_CNT_WIDTH          = 6,       // = ceil(log2(DQ_WIDTH))
   parameter DQ_WIDTH              = 64,      // # of DQ (data)
   parameter DQS_CNT_WIDTH         = 3,       // = ceil(log2(DQS_WIDTH))
   parameter DQS_WIDTH             = 8,       // # of DQS (strobe)
   parameter DRAM_TYPE             = "DDR3",
   parameter DRAM_WIDTH            = 8,       // # of DQ per DQS
   parameter ECC                   = "OFF",
   parameter ECC_WIDTH             = 8,
   parameter ECC_TEST              = "OFF",
   parameter MC_ERR_ADDR_WIDTH     = 31,
   parameter MASTER_PHY_CTL        = 0,       // The bank number where master PHY_CONTROL resides
   parameter nAL                   = 0,       // Additive latency (in clk cyc)
   parameter nBANK_MACHS           = 4,
   parameter nCK_PER_CLK           = 2,       // # of memory CKs per fabric CLK
   parameter nCS_PER_RANK          = 1,       // # of unique CS outputs per rank
   parameter ORDERING              = "NORM",
   parameter IBUF_LPWR_MODE        = "OFF",
   parameter BANK_TYPE             = "HP_IO", // # = "HP_IO", "HPL_IO", "HR_IO", "HRL_IO"
   parameter DATA_IO_PRIM_TYPE     = "DEFAULT", // # = "HP_LP", "HR_LP", "DEFAULT"
   parameter DATA_IO_IDLE_PWRDWN   = "ON",  // "ON" or "OFF"
   parameter IODELAY_GRP0          = "IODELAY_MIG0",
   parameter IODELAY_GRP1          = "IODELAY_MIG1",
   parameter FPGA_SPEED_GRADE      = 1,
   parameter OUTPUT_DRV            = "HIGH",
   parameter REG_CTRL              = "OFF",
   parameter RTT_NOM               = "60",
   parameter RTT_WR                = "120",
   parameter STARVE_LIMIT          = 2,
   parameter tCK                   = 2500,         // pS
   parameter tCKE                  = 10000,        // pS
   parameter tFAW                  = 40000,        // pS
   parameter tPRDI                 = 1_000_000,    // pS
   parameter tRAS                  = 37500,        // pS
   parameter tRCD                  = 12500,        // pS
   parameter tREFI                 = 7800000,      // pS
   parameter tRFC                  = 110000,       // pS
   parameter tRP                   = 12500,        // pS
   parameter tRRD                  = 10000,        // pS
   parameter tRTP                  = 7500,         // pS
   parameter tWTR                  = 7500,         // pS
   parameter tZQI                  = 128_000_000,  // nS
   parameter tZQCS                 = 64,           // CKs
   parameter USER_REFRESH          = "OFF",        // Whether user manages REF
   parameter TEMP_MON_EN           = "ON",         // Enable/Disable tempmon
   parameter WRLVL                 = "OFF",
   parameter DEBUG_PORT            = "OFF",
   parameter CAL_WIDTH             = "HALF",
   parameter RANK_WIDTH            = 1,
   parameter RANKS                 = 4,
   parameter ODT_WIDTH             = 1,
   parameter ROW_WIDTH             = 16,       // DRAM address bus width
   parameter ADDR_WIDTH            = 32,
   parameter APP_MASK_WIDTH        = 8,
   parameter APP_DATA_WIDTH        = 64,
   parameter [3:0] BYTE_LANES_B0         = 4'b1111,
   parameter [3:0] BYTE_LANES_B1         = 4'b1111,
   parameter [3:0] BYTE_LANES_B2         = 4'b1111,
   parameter [3:0] BYTE_LANES_B3         = 4'b1111,
   parameter [3:0] BYTE_LANES_B4         = 4'b1111,
   parameter [3:0] DATA_CTL_B0           = 4'hc,
   parameter [3:0] DATA_CTL_B1           = 4'hf,
   parameter [3:0] DATA_CTL_B2           = 4'hf,
   parameter [3:0] DATA_CTL_B3           = 4'h0,
   parameter [3:0] DATA_CTL_B4           = 4'h0,
   parameter [47:0] PHY_0_BITLANES  = 48'h0000_0000_0000,
   parameter [47:0] PHY_1_BITLANES  = 48'h0000_0000_0000,
   parameter [47:0] PHY_2_BITLANES  = 48'h0000_0000_0000,

   // control/address/data pin mapping parameters
   parameter [143:0] CK_BYTE_MAP
     = 144'h00_00_00_00_00_00_00_00_00_00_00_00_00_00_00_00_00_00,
   parameter [191:0] ADDR_MAP
     = 192'h000_000_000_000_000_000_000_000_000_000_000_000_000_000_000_000,
   parameter [35:0] BANK_MAP   = 36'h000_000_000,
   parameter [11:0] CAS_MAP    = 12'h000,
   parameter [7:0] CKE_ODT_BYTE_MAP = 8'h00,
   parameter [95:0] CKE_MAP    = 96'h000_000_000_000_000_000_000_000,
   parameter [95:0] ODT_MAP    = 96'h000_000_000_000_000_000_000_000,
   parameter CKE_ODT_AUX = "FALSE",
   parameter [119:0] CS_MAP     = 120'h000_000_000_000_000_000_000_000_000_000,
   parameter [11:0] PARITY_MAP = 12'h000,
   parameter [11:0] RAS_MAP    = 12'h000,
   parameter [11:0] WE_MAP     = 12'h000,
   parameter [143:0] DQS_BYTE_MAP
     = 144'h00_00_00_00_00_00_00_00_00_00_00_00_00_00_00_00_00_00,
   parameter [95:0] DATA0_MAP  = 96'h000_000_000_000_000_000_000_000,
   parameter [95:0] DATA1_MAP  = 96'h000_000_000_000_000_000_000_000,
   parameter [95:0] DATA2_MAP  = 96'h000_000_000_000_000_000_000_000,
   parameter [95:0] DATA3_MAP  = 96'h000_000_000_000_000_000_000_000,
   parameter [95:0] DATA4_MAP  = 96'h000_000_000_000_000_000_000_000,
   parameter [95:0] DATA5_MAP  = 96'h000_000_000_000_000_000_000_000,
   parameter [95:0] DATA6_MAP  = 96'h000_000_000_000_000_000_000_000,
   parameter [95:0] DATA7_MAP  = 96'h000_000_000_000_000_000_000_000,
   parameter [95:0] DATA8_MAP  = 96'h000_000_000_000_000_000_000_000,
   parameter [95:0] DATA9_MAP  = 96'h000_000_000_000_000_000_000_000,
   parameter [95:0] DATA10_MAP = 96'h000_000_000_000_000_000_000_000,
   parameter [95:0] DATA11_MAP = 96'h000_000_000_000_000_000_000_000,
   parameter [95:0] DATA12_MAP = 96'h000_000_000_000_000_000_000_000,
   parameter [95:0] DATA13_MAP = 96'h000_000_000_000_000_000_000_000,
   parameter [95:0] DATA14_MAP = 96'h000_000_000_000_000_000_000_000,
   parameter [95:0] DATA15_MAP = 96'h000_000_000_000_000_000_000_000,
   parameter [95:0] DATA16_MAP = 96'h000_000_000_000_000_000_000_000,
   parameter [95:0] DATA17_MAP = 96'h000_000_000_000_000_000_000_000,
   parameter [107:0] MASK0_MAP  = 108'h000_000_000_000_000_000_000_000_000,
   parameter [107:0] MASK1_MAP  = 108'h000_000_000_000_000_000_000_000_000,

   parameter [7:0] SLOT_0_CONFIG         = 8'b0000_0001,
   parameter [7:0] SLOT_1_CONFIG         = 8'b0000_0000,
   parameter MEM_ADDR_ORDER        = "BANK_ROW_COLUMN",
   // calibration Address. The address given below will be used for calibration
   // read and write operations.
   parameter [15:0] CALIB_ROW_ADD         = 16'h0000, // Calibration row address
   parameter [11:0] CALIB_COL_ADD         = 12'h000,  // Calibration column address
   parameter [2:0] CALIB_BA_ADD          = 3'h0,     // Calibration bank address
   parameter SIM_BYPASS_INIT_CAL   = "OFF",
   parameter REFCLK_FREQ           = 300.0,
   parameter USE_CS_PORT           = 1,        // Support chip select output
   parameter USE_DM_PORT           = 1,        // Support data mask output
   parameter USE_ODT_PORT          = 1,        // Support ODT output
   parameter IDELAY_ADJ            = "ON",     //ON : IDELAY-1, OFF: No change
   parameter FINE_PER_BIT          = "ON",     //ON : Use per bit calib for complex rdlvl
   parameter CENTER_COMP_MODE      = "ON",     //ON: use PI stg2 tap compensation
   parameter PI_VAL_ADJ            = "ON",      //ON: PI stg2 tap -1 for centering
   parameter SKIP_CALIB            = "FALSE",
   parameter TAPSPERKCLK           = 56,
   parameter C_S_AXI_ID_WIDTH              = 4,
                                             // Width of all master and slave ID signals.
                                             // # = >= 1.
   parameter C_S_AXI_ADDR_WIDTH            = 30,
                                             // Width of S_AXI_AWADDR, S_AXI_ARADDR, M_AXI_AWADDR and
                                             // M_AXI_ARADDR for all SI/MI slots.
                                             // # = 32.
   parameter C_S_AXI_DATA_WIDTH            = 32,
                                             // Width of WDATA and RDATA on SI slot.
                                             // Must be <= APP_DATA_WIDTH.
                                             // # = 32, 64, 128, 256.
   parameter C_S_AXI_SUPPORTS_NARROW_BURST = 1,
                                             // Indicates whether to instatiate upsizer
                                             // Range: 0, 1
   parameter C_RD_WR_ARB_ALGORITHM          = "RD_PRI_REG",
                                             // Indicates the Arbitration
                                             // Allowed values - "TDM", "ROUND_ROBIN",
                                             // "RD_PRI_REG", "RD_PRI_REG_STARVE_LIMIT"
   parameter C_S_AXI_REG_EN0               = 20'h00000,
                                             // Instatiates register slices before upsizer.
                                             // The type of register is specified for each channel
                                             // in a vector. 4 bits per channel are used.
                                             // C_S_AXI_REG_EN0[03:00] = AW CHANNEL REGISTER SLICE
                                             // C_S_AXI_REG_EN0[07:04] =  W CHANNEL REGISTER SLICE
                                             // C_S_AXI_REG_EN0[11:08] =  B CHANNEL REGISTER SLICE
                                             // C_S_AXI_REG_EN0[15:12] = AR CHANNEL REGISTER SLICE
                                             // C_S_AXI_REG_EN0[20:16] =  R CHANNEL REGISTER SLICE
                                             // Possible values for each channel are:
                                             //
                                             //   0 => BYPASS    = The channel is just wired through the
                                             //                    module.
                                             //   1 => FWD       = The master VALID and payload signals
                                             //                    are registrated.
                                             //   2 => REV       = The slave ready signal is registrated
                                             //   3 => FWD_REV   = Both FWD and REV
                                             //   4 => SLAVE_FWD = All slave side signals and master
                                             //                    VALID and payload are registrated.
                                             //   5 => SLAVE_RDY = All slave side signals and master
                                             //                    READY are registrated.
                                             //   6 => INPUTS    = Slave and Master side inputs are
                                             //                    registrated.
 parameter C_S_AXI_REG_EN1                 = 20'h00000,
                                             // Same as C_S_AXI_REG_EN0, but this register is after
                                             // the upsizer
 parameter C_S_AXI_CTRL_ADDR_WIDTH         = 32,
                                             // Width of AXI-4-Lite address bus
 parameter C_S_AXI_CTRL_DATA_WIDTH         = 32,
                                             // Width of AXI-4-Lite data buses
 parameter C_S_AXI_BASEADDR                = 32'h0000_0000,
                                             // Base address of AXI4 Memory Mapped bus.
 parameter C_ECC_ONOFF_RESET_VALUE         = 1,
                                             // Controls ECC on/off value at startup/reset
 parameter C_ECC_CE_COUNTER_WIDTH          = 8,
                                             // The external memory to controller clock ratio.
 parameter FPGA_VOLT_TYPE                  = "N"
  )
  (
   // Clock and reset ports
   input                              clk,
   input                              clk_div2,
   input                              rst_div2,
   input [1:0]                        clk_ref,
   input                              mem_refclk ,
   input                              freq_refclk ,
   input                              pll_lock,
   input                              sync_pulse ,
   input                              mmcm_ps_clk,
   input                              poc_sample_pd,

   input                              rst,

   // memory interface ports
   inout [DQ_WIDTH-1:0]               ddr_dq,
   inout [DQS_WIDTH-1:0]              ddr_dqs_n,
   inout [DQS_WIDTH-1:0]              ddr_dqs,
   output [ROW_WIDTH-1:0]             ddr_addr,
   output [BANK_WIDTH-1:0]            ddr_ba,
   output                             ddr_cas_n,
   output [CK_WIDTH-1:0]              ddr_ck_n,
   output [CK_WIDTH-1:0]              ddr_ck,
   output [CKE_WIDTH-1:0]             ddr_cke,
   output [CS_WIDTH*nCS_PER_RANK-1:0] ddr_cs_n,
   output [DM_WIDTH-1:0]              ddr_dm,
   output [ODT_WIDTH-1:0]             ddr_odt,
   output                             ddr_ras_n,
   output                             ddr_reset_n,
   output                             ddr_parity,
   output                             ddr_we_n,

   output [BM_CNT_WIDTH-1:0]          bank_mach_next,
   output [2*nCK_PER_CLK-1:0]         app_ecc_multiple_err_o,
   output [2*nCK_PER_CLK-1:0]         app_ecc_single_err,

   input                              app_sr_req,
   output                             app_sr_active,
   input                              app_ref_req,
   output                             app_ref_ack,
   input                              app_zq_req,
   output                             app_zq_ack,

   // Ports to be used with SKIP_CALIB defined
   output                              calib_tap_req,
   input [6:0]                         calib_tap_addr,
   input                               calib_tap_load,
   input [7:0]                         calib_tap_val,
   input                               calib_tap_load_done,

   // temperature monitor ports
   input  [11:0]                      device_temp,
   //phase shift clock control
   output                             psen,
   output                             psincdec,
   input                              psdone,
   // debug logic ports
   input                              dbg_idel_down_all,
   input                              dbg_idel_down_cpt,
   input                              dbg_idel_up_all,
   input                              dbg_idel_up_cpt,
   input                              dbg_sel_all_idel_cpt,
   input [DQS_CNT_WIDTH-1:0]          dbg_sel_idel_cpt,
   output [6*DQS_WIDTH*RANKS-1:0]     dbg_cpt_first_edge_cnt,
   output [6*DQS_WIDTH*RANKS-1:0]     dbg_cpt_second_edge_cnt,
   output [DQS_WIDTH-1:0]             dbg_rd_data_edge_detect,
   output [2*nCK_PER_CLK*DQ_WIDTH-1:0] dbg_rddata,
   output [1:0]                       dbg_rdlvl_done,
   output [1:0]                       dbg_rdlvl_err,
   output [1:0]                       dbg_rdlvl_start,
   output [5:0]                       dbg_tap_cnt_during_wrlvl,
   output                             dbg_wl_edge_detect_valid,
   output                             dbg_wrlvl_done,
   output                             dbg_wrlvl_err,
   output                             dbg_wrlvl_start,
   output [6*DQS_WIDTH-1:0]           dbg_final_po_fine_tap_cnt,
   output [3*DQS_WIDTH-1:0]           dbg_final_po_coarse_tap_cnt,

   input                              aresetn,
   // Slave Interface Write Address Ports
   input  [C_S_AXI_ID_WIDTH-1:0]      s_axi_awid,
   input  [C_S_AXI_ADDR_WIDTH-1:0]    s_axi_awaddr,
   input  [7:0]                       s_axi_awlen,
   input  [2:0]                       s_axi_awsize,
   input  [1:0]                       s_axi_awburst,
   input  [0:0]                       s_axi_awlock,
   input  [3:0]                       s_axi_awcache,
   input  [2:0]                       s_axi_awprot,
   input  [3:0]                       s_axi_awqos,
   input                              s_axi_awvalid,
   output                             s_axi_awready,
   // Slave Interface Write Data Ports
   input  [C_S_AXI_DATA_WIDTH-1:0]    s_axi_wdata,
   input  [C_S_AXI_DATA_WIDTH/8-1:0]  s_axi_wstrb,
   input                              s_axi_wlast,
   input                              s_axi_wvalid,
   output                             s_axi_wready,
   // Slave Interface Write Response Ports
   input                              s_axi_bready,
   output [C_S_AXI_ID_WIDTH-1:0]      s_axi_bid,
   output [1:0]                       s_axi_bresp,
   output                             s_axi_bvalid,
   // Slave Interface Read Address Ports
   input  [C_S_AXI_ID_WIDTH-1:0]      s_axi_arid,
   input  [C_S_AXI_ADDR_WIDTH-1:0]    s_axi_araddr,
   input  [7:0]                       s_axi_arlen,
   input  [2:0]                       s_axi_arsize,
   input  [1:0]                       s_axi_arburst,
   input  [0:0]                       s_axi_arlock,
   input  [3:0]                       s_axi_arcache,
   input  [2:0]                       s_axi_arprot,
   input  [3:0]                       s_axi_arqos,
   input                              s_axi_arvalid,
   output                             s_axi_arready,
   // Slave Interface Read Data Ports
   input                              s_axi_rready,
   output [C_S_AXI_ID_WIDTH-1:0]      s_axi_rid,
   output [C_S_AXI_DATA_WIDTH-1:0]    s_axi_rdata,
   output [1:0]                       s_axi_rresp,
   output                             s_axi_rlast,
   output                             s_axi_rvalid,

   // AXI CTRL port
   input                                s_axi_ctrl_awvalid,
   output                               s_axi_ctrl_awready,
   input  [C_S_AXI_CTRL_ADDR_WIDTH-1:0] s_axi_ctrl_awaddr,
   // Slave Interface Write Data Ports
   input                                s_axi_ctrl_wvalid,
   output                               s_axi_ctrl_wready,
   input  [C_S_AXI_CTRL_DATA_WIDTH-1:0] s_axi_ctrl_wdata,
   // Slave Interface Write Response Ports
   output                               s_axi_ctrl_bvalid,
   input                                s_axi_ctrl_bready,
   output [1:0]                         s_axi_ctrl_bresp,
   // Slave Interface Read Address Ports
   input                                s_axi_ctrl_arvalid,
   output                               s_axi_ctrl_arready,
   input  [C_S_AXI_CTRL_ADDR_WIDTH-1:0] s_axi_ctrl_araddr,
   // Slave Interface Read Data Ports
   output                               s_axi_ctrl_rvalid,
   input                                s_axi_ctrl_rready,
   output [C_S_AXI_CTRL_DATA_WIDTH-1:0] s_axi_ctrl_rdata,
   output [1:0]                         s_axi_ctrl_rresp,

   // Interrupt output
   output                               interrupt,

   output                             init_calib_complete,
   input                              dbg_sel_pi_incdec,
   input                              dbg_sel_po_incdec,
   input [DQS_CNT_WIDTH:0]            dbg_byte_sel,
   input                              dbg_pi_f_inc,
   input                              dbg_pi_f_dec,
   input                              dbg_po_f_inc,
   input                              dbg_po_f_stg23_sel,
   input                              dbg_po_f_dec,
   output [6*DQS_WIDTH*RANKS-1:0]     dbg_cpt_tap_cnt,
   output [5*DQS_WIDTH*RANKS-1:0]     dbg_dq_idelay_tap_cnt,
   output                             dbg_rddata_valid,
   output [6*DQS_WIDTH-1:0]           dbg_wrlvl_fine_tap_cnt,
   output [3*DQS_WIDTH-1:0]           dbg_wrlvl_coarse_tap_cnt,
   output                             ref_dll_lock,
   input                              rst_phaser_ref,
   input                              iddr_rst,
   output [6*RANKS-1:0]               dbg_rd_data_offset,
   output [255:0]                     dbg_calib_top,
   output [255:0]                     dbg_phy_wrlvl,
   output [255:0]                     dbg_phy_rdlvl,
   output [99:0]                      dbg_phy_wrcal,
   output [255:0]                     dbg_phy_init,
   output [255:0]                     dbg_prbs_rdlvl,
   output [255:0]                     dbg_dqs_found_cal,
   output [5:0]                       dbg_pi_counter_read_val,
   output [8:0]                       dbg_po_counter_read_val,
   output                             dbg_pi_phaselock_start,
   output                             dbg_pi_phaselocked_done,
   output                             dbg_pi_phaselock_err,
   output                             dbg_pi_dqsfound_start,
   output                             dbg_pi_dqsfound_done,
   output                             dbg_pi_dqsfound_err,
   output                             dbg_wrcal_start,
   output                             dbg_wrcal_done,
   output                             dbg_wrcal_err,
   output [11:0]                      dbg_pi_dqs_found_lanes_phy4lanes,
   output [11:0]                      dbg_pi_phase_locked_phy4lanes,
   output [6*RANKS-1:0]               dbg_calib_rd_data_offset_1,
   output [6*RANKS-1:0]               dbg_calib_rd_data_offset_2,
   output [5:0]                       dbg_data_offset,
   output [5:0]                       dbg_data_offset_1,
   output [5:0]                       dbg_data_offset_2,
   output                             dbg_oclkdelay_calib_start,
   output                             dbg_oclkdelay_calib_done,
   output [255:0]                     dbg_phy_oclkdelay_cal,
   output [DRAM_WIDTH*16 -1:0]        dbg_oclkdelay_rd_data,
   output [6*DQS_WIDTH*RANKS-1:0]     dbg_prbs_final_dqs_tap_cnt_r,
   output [6*DQS_WIDTH*RANKS-1:0]     dbg_prbs_first_edge_taps,
   output [6*DQS_WIDTH*RANKS-1:0]     dbg_prbs_second_edge_taps,
   output [1023:0]                    dbg_poc

   );

  localparam IODELAY_GRP = (tCK <= 1500)? IODELAY_GRP1 : IODELAY_GRP0;

  localparam INTERFACE                   = "AXI4";
                                           // Port Interface.
                                           // # = UI - User Interface,
                                           //   = AXI4 - AXI4 Interface.
  localparam C_FAMILY                    = "virtex7";


  localparam C_MC_DATA_WIDTH_LCL         = 2*nCK_PER_CLK*DATA_WIDTH ;
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
