aditya-167/SuperPong-FPGA/(commit log)

2023-02-23 Adding correct working files and game demonstration files.
    [pong.c, pong.h, video_demo.c, xparameters.h]
2023-03-01 Added input buttons.
2023-03-13 Deleted unncecessary drivers.
2023-03-18 Adding new files after fixes
    [pong.c]
2023-03-25 Masking&rgb2HSV
    Adding these files to integrate with camera project
